ThaiQuangHuy2906/smart-privacy-locker/AnhVatLi/2.3.9.jpg

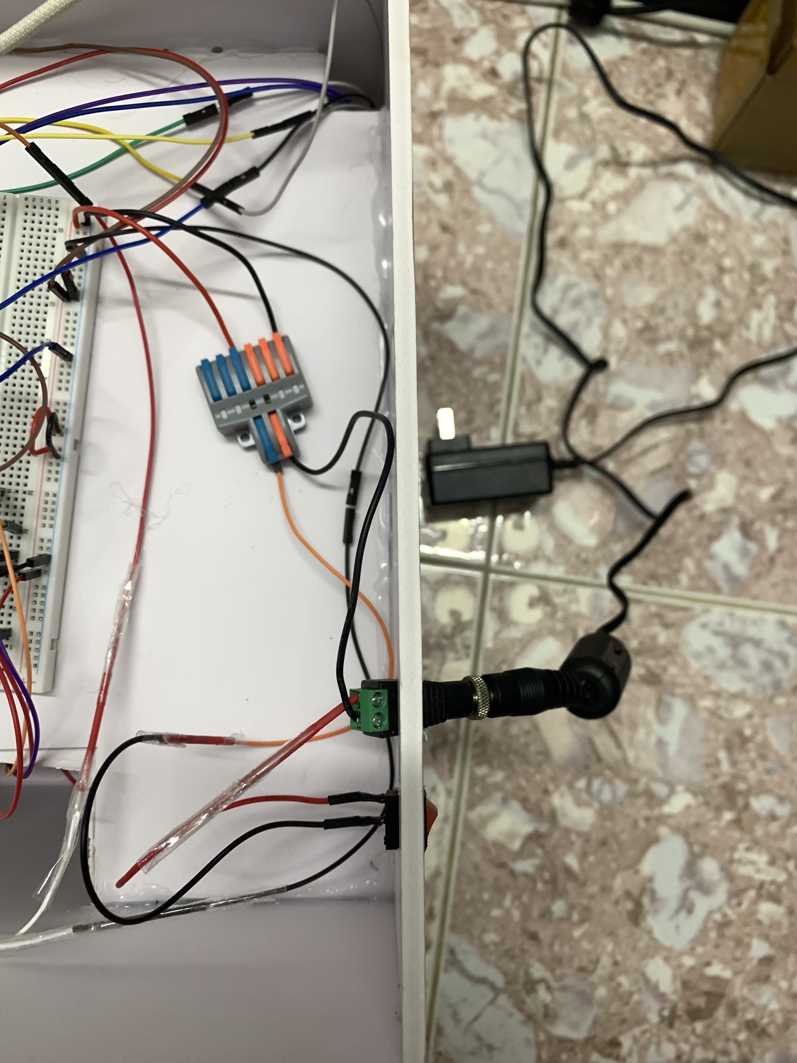
AnhVatLi/2.3.9.jpg
