ThaiQuangHuy2906/smart-privacy-locker/node-red/README.md

# Node-RED application deployment

> Audit snapshot 2026-08-18: `npm test` passes 177/177, simulator 28 assertions
> across 22 scenarios, authenticated loopback broker 18 assertions, local
> Chrome/CDP dashboard QA 18/18, and config/dependency audits report zero
> findings. External FlowFuse/Supabase/
> Telegram/Gemini/SMTP state was not redeployed or rerun in this audit.

`flows.json` separates MQTT validation/cache, auth/dispatcher/ACK/timeout,
unauthorized/Telegram, history/chatbot, Dashboard APIs, persistence/chart and
daily reports. Core logic is in
small modules under `lib/`; no giant Function node owns the trust boundary.

The dispatcher rejects unknown/late/mismatched ACKs for pending completion and
routes those schema-valid anomalies as `accepted:false` bounded diagnostics.
The runtime also validates the non-retained device heartbeat and refreshes only
the active `ONLINE` connection generation; it does not persist a periodic
`DEVICE_ONLINE` event. Dashboard corrections are documented in
[../dashboard/README.md](../dashboard/README.md). Regenerate the FlowFuse
artifact after every source change and run the deterministic artifact test.

Door events preserve a firmware UUIDv4 `event_id` and use its explicit OPEN
`authorized` boolean when present. One successful `UNLOCK` ACK while CLOSED
grants one OPEN. Current firmware auto-locks after that opening closes or when
the unused 30-second grant expires; a later forced OPEN without re-arm is
unauthorized. The automatic lock publishes state but no command ACK. The
backend window is a legacy fallback, not an
override of firmware after restart. A missed OPEN is reconciled from full state
only when the device also reports local `alarm=ACTIVE`; repeated event IDs are
idempotent across alarm/history/notification side effects.
Persistence failures enter a bounded RAM retry outbox; due retries run from the
periodic flow tick, and exhausted/full-outbox records remain visible as explicit
dead letters rather than a false healthy state.

## Install and configure

### FlowFuse Cloud (J.11)

Generate the import artifact from the tested runtime and Dashboard sources:

```
npm run build:flowfuse
```

Import `flows.flowfuse.json`, not `flows.json`. The FlowFuse export bundles the
modules under `lib/` into the initializer's **On Start** code and embeds the
Dashboard HTML/CSS/JavaScript behind `GET /locker`; `GET /phase2` remains a
legacy alias. It does not require access to this repository or a custom
`settings.js` at runtime. Do not edit the
generated JSON directly; change `lib/`, `dashboard/`, or `flows.json`, then run
the build command again.

The instance must allow Function nodes to load modules
(`functionExternalModules`). This export requests the Node.js built-ins
`crypto`/`https` plus the pinned `nodemailer` dependency. Add the
following variables to the FlowFuse instance environment, install the pinned
`@flowfuse/node-red-dashboard` palette, then enter the MQTT username and
password in the MQTT broker configuration node's credential fields:

```text
LOCKER_ID, MQTT_HOST, MQTT_PORT,
COMMAND_TIMEOUT_MS, DEVICE_STALE_AFTER_SECONDS, DASHBOARD_BASE_URL,
SUPABASE_URL, SUPABASE_ANON_KEY, SUPABASE_SERVICE_ROLE_KEY,
TELEGRAM_BOT_TOKEN, TELEGRAM_BOT_USERNAME, TELEGRAM_WEBHOOK_SECRET,
GEMINI_API_KEY, GEMINI_MODEL, REPORT_TIMEZONE,
GMAIL_SMTP_HOST, GMAIL_SMTP_PORT, GMAIL_SMTP_USER,
GMAIL_APP_PASSWORD, EMAIL_FROM
```

Do **not** copy every key from the repository-wide `.env.example` into
FlowFuse. Phase 3 Node-RED needs `SUPABASE_SERVICE_ROLE_KEY` for trusted event
and delivery writes, but the Dashboard never receives it. `MQTT_USERNAME` and
`MQTT_PASSWORD` belong in the broker configuration node's credential store,
not in the JSON export. The included TLS config verifies the broker certificate;
upload a CA only when the broker uses a private CA.

The broker permissions must match the flow's actual subscription filters. Use
separate credentials and permissions for the trusted orchestrator and device:

```text
Node-RED credential: Publish + Subscribe on locker/+/#
ESP32 credential:    Publish + Subscribe on locker/LOCKER-001/#
```

The Node-RED flow subscribes to `locker/+/+` and
`locker/+/telemetry/door`. Giving its credential only the device-scoped
`locker/LOCKER-001/#` permission can authenticate the connection while the
broker still rejects both subscriptions; a green/connected MQTT status alone
does not prove that telemetry is entering the flow. Keep the device credential
scoped to its one locker and never copy the broader Node-RED credential into
firmware.

Telegram has no shared/global destination. `TELEGRAM_BOT_TOKEN` and
`TELEGRAM_WEBHOOK_SECRET` are backend secrets; `TELEGRAM_BOT_USERNAME` is the
BotFather username without `@`. After the first deployment, register this
HTTPS webhook once with Telegram:

```text
https://<ten-instance-cua-ban>.flowfuse.cloud/api/v1/telegram/webhook
```

Use Telegram Bot API `setWebhook` with the same `TELEGRAM_WEBHOOK_SECRET` in
its `secret_token` field. The Dashboard then creates a 10-minute, one-time
deep link. The owner clicks **Liên kết Telegram**, presses **Start** in the
private bot chat, and the webhook stores the destination for that locker. The
browser never asks for, receives, or saves a Chat ID. Group/supergroup starts,
expired or cross-account token reuse, wrong owners, and webhook calls without
the exact secret header are rejected. An exact retry from the already-linked
private account is idempotent. See `docs/deployment-guide.md` for the exact
registration and verification commands.

The webhook also handles private `/start`, `/help`, and `/settings` commands
without a link token by directing the user back to the authenticated Dashboard.
Other messages and every group/supergroup command remain ignored. Configure the
same three command names and the bot descriptions through BotFather or the Bot
API after the matching runtime is deployed.

After deployment, use `/locker` for the embedded app and
`/dashboard/locker` for the FlowFuse Dashboard wrapper. Existing direct
`/phase2` links remain valid through the compatibility alias. A missing bootstrap
returns `503 RUNTIME_STARTING` from protected routes instead of exposing or
bypassing authentication.

### Self-hosted Node-RED

1. Use a FlowFuse/Node-RED runtime `>=4.1.13 <5` on Node.js 20+. The platform supplies Node-RED; this project intentionally does not vendor its palette-manager runtime. Install the pinned Dashboard node with `npm ci`.
2. Apply `settings.example.js` values to the deployment `settings.js`. Set a strong `NODE_RED_CREDENTIAL_SECRET` outside Git.
3. Set only the runtime variables listed in the FlowFuse section above in the deployment secret/environment store. Self-hosted Node-RED additionally needs `NODE_RED_CREDENTIAL_SECRET`. Never import a plaintext credential flow.
4. Import `flows.json`. Configure the MQTT broker node credential fields from the Node-RED credential store/environment; remote brokers require certificate verification.
5. Serve the static app through `httpStatic`; open the FlowFuse Dashboard page `/dashboard/locker` (or `/locker` directly for diagnostics).

Node-RED creates one shared runtime from `settings.js` before flow messages and
keeps the flow-level initializer idempotent. MQTT status is distinct from device
LWT: the exported flow recognizes the Node-RED 4.1.13 connected status key,
invalidates pending commands on disconnect, and emits one internal `GET_STATE`
per configured locker on each reconnect. Controls enable only after a fresh
ONLINE availability plus full state from the current connection generation;
restart/old ACK cannot restore a request. Invalid MQTT payload produces a safe
bounded diagnostic containing only code, topic, and observed time—never raw
payload/token.

Valid heartbeat on `locker/{locker_id}/heartbeat` is non-retained and refreshes
the liveness observation only after current-generation `ONLINE`. It cannot make
an explicitly `OFFLINE`, retained-only or pre-reconnect generation trustworthy.
Firmware follows heartbeat with a full-state refresh, so controls still depend
on validated current state rather than liveness alone.

The validated full-state `wifi_connected` boolean is retained in the live
cache and exposed to the owner Dashboard only while that state is fresh and
trusted. Missing/stale context becomes `wifi=UNKNOWN`. The Dashboard's YC12
panel provides only local captive-portal instructions; it has no path for an
SSID or Wi-Fi password.

## Tests

```powershell
npm test
npm run test:simulator
npm run test:broker
npm run audit
```

Tests use Node's built-in runner and deterministic fixtures. The memory matrix
covers retained/non-retained semantics; `test:broker` additionally executes the
exported MQTT status Function with the real Node-RED 4.1.13 status token, then
passes real MQTT traffic through `Phase2Runtime` on an authenticated loopback
Aedes broker. Neither result is an imported FlowFuse deployment or hardware evidence. Live
Supabase, FlowFuse, Telegram, Gemini, MQTT and ESP32 gates require deployment
environment and sanitized manual evidence.

Authorization is fail-closed: each Supabase Auth request is bounded to five
seconds and verify-plus-ownership shares a 9-second aggregate deadline. The
Dashboard uses a 15-second deadline for simple auth/command operations, 30
seconds for database-backed views/settings and 40 seconds for grounded chat;
all remain bounded. If the command HTTP request disconnects during
authorization, runtime dispatch and MQTT outbox draining are suppressed.

## Routes and operations

See `docs/auth-ownership.md` for route/status contracts. The timeout scheduler
runs every 250 ms against a 5000 ms default deadline. Actuator timeouts are not
retried; one internal `GET_STATE` is issued only while the device remains ready.
Completed IDs are bounded in memory. A Node-RED restart clears them, pending
commands, cache freshness, and the legacy unlock-command window by design.
Current firmware telemetry remains authoritative for the one-time OPEN decision,
so a backend restart cannot turn a device-authorized edge into an alert or vice
versa.

Phase 3 adds owner-protected `GET history`, `GET chart`, and `GET/PUT
notification-settings` routes. A minute scheduler selects email-enabled
settings after their local `HH:MM` becomes due, aggregates the previous local
calendar day, and atomically reserves `(locker, channel, report_date)`. A
definitively rejected/not-sent attempt can retry at most three times. A crash
before SMTP starts can reclaim its stale reservation; a timeout/crash after
SMTP may have accepted the message becomes `delivery_unknown` and is never
resent automatically. Every setting is isolated, so one invalid stored
timezone cannot stop reports for other lockers. Provider/config failures expose
only bounded error codes, never credentials or response bodies.

History-backed aggregation, report and chatbot queries page Supabase in stable
`occurred_at DESC,event_id DESC` order. Daily scheduler settings use the same
bounded paging rule in stable `locker_id ASC` order. Both paths fail explicitly
at their configured safety ceiling instead of returning a silent 1000-row
partial result. Enabling Telegram before that locker has a completed
private-account link is rejected. The scheduler checks that SMTP
is configured before reserving a delivery attempt, so an unset deployment does
not consume the day's retry budget. Retained availability without `sent_at`
updates live state but is not persisted because it has no replay-stable event
identity.

Apply `202608100002_phase3_scheduler_delivery_hardening.sql` and then
`202608110001_telegram_account_linking.sql` and then
`202608110002_telegram_link_consume_conflict_fix.sql` and then
`202608110003_telegram_notification_preference_upsert_fix.sql` before deploying this runtime. The
previous runtime remains compatible with the generated `report_date`; the new
runtime intentionally fails closed if the reservation or Telegram-link RPC is
absent.
