ThaiQuangHuy2906/smart-privacy-locker/PLAN.md

# Smart Privacy Locker — Implementation Plan

> Baseline lập kế hoạch: 2026-08-07, repository greenfield, chưa có source code và chưa có implementation evidence.
>
> Historical baseline status khi lập kế hoạch, không phải current registry: **Phase 1 — ACTIVE**; **Phase 2 — NOT_STARTED**; **Phase 3 — NOT_STARTED**.
>
> Quy tắc cập nhật: không tick công việc, không ghi `PASS`, không điền commit hash/remote reference và không chuyển trạng thái Phase nếu chưa có evidence thực tế tương ứng.

> **Addendum hiện hành 2026-08-18:** đây là baseline/kế hoạch lịch sử nên các
> dòng cũ về “chưa có hardware”, trạng thái phase và số test tại từng phase
> không được hiểu là current registry. Trạng thái hiện hành nằm ở
> [BAO_CAO_RA_SOAT_CODEBASE.md](BAO_CAO_RA_SOAT_CODEBASE.md),
> [docs/requirements.md](docs/requirements.md) và
> [tests/test-plan.md](tests/test-plan.md). As-built hiện dùng tay SG90 làm chốt
> quay: `LOCK=80°`, `UNLOCK=170°`, settle `2.000 ms`; người dùng đóng/mở cửa và
> MC-38 chỉ đo cửa. Các quan sát riêng lẻ OLED/DHT22/MC-38/WS2812B/SG90 là
> `PARTIAL / USER-REPORTED`; final E2E phần cứng vẫn chưa đóng. Rủi ro phép đo
> nguồn/tải P1-05 đã được người dùng chấp nhận cho demo, không phải measured
> PASS. Quy trình hiện hành ở
> [HUONG_DAN_TEST_END_TO_END.md](HUONG_DAN_TEST_END_TO_END.md), phần ôn vấn đáp ở
> [ON_TAP_VAN_DAP_CHI_TIET.md](ON_TAP_VAN_DAP_CHI_TIET.md).

## 1. Project Overview

Smart Privacy Locker là mô hình tủ bảo mật IoT mini dùng ESP32 để giám sát cửa, điều khiển khóa servo, còi báo động và đèn trong tủ. Người dùng thao tác qua FlowFuse Dashboard; Node-RED là backend bắt buộc đứng giữa Dashboard, MQTT Broker, ESP32, Supabase và các dịch vụ Telegram, Gmail, Gemini. DHT22 và OLED tạo thành luồng hiển thị cục bộ, không mặc định đưa nhiệt độ/độ ẩm lên Dashboard.

Tại baseline lập kế hoạch, repository là greenfield, Git chưa có commit và chỉ có hai tài liệu PDF nguồn. Hiện repository đã có đủ Phase 1–3 software baseline cùng build/test evidence và project ở trạng thái `SOFTWARE_COMPLETE`; current implementation/lifecycle phải lấy từ Phase registry, Phase Completion Summary và Git evidence, không từ mô tả historical baseline này.

### Nguồn sự thật và audit tài liệu

Thứ tự ưu tiên khi triển khai:

1. Bản thuyết minh dự án.
2. Yêu cầu trong prompt tạo kế hoạch này.
3. Master Project Plan.
4. Quyết định kỹ thuật được ghi rõ trong tài liệu này.

Source-document audit là phần duy nhất đã hoàn thành tại baseline:

- Đã đọc toàn bộ 22 trang của `12_24127177_24127205_24127249.pdf`, gồm phạm vi chức năng, thiết kế 3D, vị trí linh kiện, wireframe, sơ đồ truyền nhận dữ liệu, BOM, lịch và phân công gốc.
- Đã đọc toàn bộ 49 trang của `Master Project Plan.pdf`, gồm kiến trúc, MQTT/database đề xuất, firmware/Node-RED decomposition, lịch 5 tuần, acceptance criteria, test plan, risk register, demo và recovery audit.
- Đã kiểm tra trực quan các trang chứa thiết kế 3D, wireframe, sơ đồ hệ thống và ảnh linh kiện; hai PDF là born-digital, không mã hóa, không có JavaScript và không có lỗi cấu trúc do `qpdf` phát hiện.
- Hai PDF là tài liệu chỉ đọc; không được sửa, thay thế hoặc âm thầm di chuyển trong quá trình triển khai.

### Phạm vi cam kết và traceability

Có **12 requirement** phải được triển khai đầy đủ; `Owner chính` không được thay đổi dù hạ tầng dùng chung do thành viên khác xây dựng.

| Requirement | Phạm vi cam kết | Owner chính | Phase triển khai chính | Dependency tích hợp cuối |
|---|---|---|---|---|
| CB1 | MC-38 đọc `OPEN/CLOSED` → ESP32 → MQTT → Node-RED → Dashboard; hỗ trợ `UNKNOWN` | Nguyễn Văn Minh | Phase 2 | YC4 persistence ở Phase 3 |
| CB2 | Dashboard Lock/Unlock → Node-RED xác thực → MQTT → ESP32 → Servo SG90 → ACK/state | Thái Quang Huy | Phase 1, tích hợp shared backend ở Phase 2/3 | Dispatcher/Auth của Phase 2; Dashboard cuối của Phase 3 |
| CB3 | Dashboard **Bật còi/Tắt còi** (`ALARM_ON/OFF`) → Node-RED → MQTT → ESP32 → Active Buzzer → ACK/state | Mai Phương Thùy | Phase 3 | Command contract/foundation từ Phase 1/2 |
| YC1 | DHT22 → ESP32 → OLED SSD1306, chỉ cục bộ | Thái Quang Huy | Phase 1 | Hardware integration cuối Phase 3 |
| YC3 | Dashboard LED On/Off → Node-RED xác thực → MQTT → ESP32 → WS2812B → ACK/state | Thái Quang Huy | Phase 1, tích hợp shared backend ở Phase 2/3 | Dispatcher/Auth của Phase 2; Dashboard cuối của Phase 3 |
| YC4 | Node-RED lưu lịch sử cửa, khóa, buzzer, LED, cảnh báo, source, result, authorized, command_id, timestamp vào Supabase | Mai Phương Thùy | Phase 3 | Event contract do Phase 2 phát cho YC6 |
| YC5 | Biểu đồ số lần mở tủ và số cảnh báo theo 7/30 ngày | Mai Phương Thùy | Phase 3 | YC4, timezone contract |
| YC6 | Phát hiện mở trái phép; `authorized=false`; buzzer; Telegram; cảnh báo Dashboard | Nguyễn Văn Minh | Logic Phase 2; tích hợp đầy đủ Phase 3 | CB3 và YC4 do Thùy triển khai |
| YC7 | Báo cáo email hằng ngày: số lần mở, số cảnh báo, hoạt động gần nhất | Mai Phương Thùy | Phase 3 | YC4 và notification settings |
| YC8 | Chatbot dùng live state + Supabase history làm context cho Gemini; Gemini chỉ diễn đạt | Nguyễn Văn Minh | Routing/grounding Phase 2; history integration Phase 3 | YC4 history query thực ở Phase 3 |
| YC9 | Supabase Auth register/login/logout/session/JWT, ownership, RLS | Nguyễn Văn Minh | Phase 2 | Dashboard cuối Phase 3 |
| YC12 | WiFiManager captive portal đổi Wi-Fi không nạp lại firmware | Thái Quang Huy | Phase 1 | User/deployment guide Phase 3 |

### Phase registry

| Phase | Thành viên | MSSV | Owner chính | Trạng thái hiện tại |
|---|---|---|---|---|
| 1 | Thái Quang Huy | 24127177 | CB2, YC1, YC3, YC12 | **COMPLETED** |
| 2 | Nguyễn Văn Minh | 24127205 | CB1, YC6, YC8, YC9 | **COMPLETED** |
| 3 | Mai Phương Thùy | 24127249 | CB3, YC4, YC5, YC7 | **COMPLETED** |

### Phase lifecycle và ranh giới quyền hạn

Lifecycle chuẩn, chỉ chuyển theo evidence thật chứ không theo lịch:

`NOT_STARTED → ACTIVE → COMPLETED`

`BLOCKED` chỉ dùng khi có blocker thật. Khi blocker được giải quyết, Phase trở lại `ACTIVE`; thiếu hardware không phải blocker của SOFTWARE-GATE.

- `NOT_STARTED`: chưa được phép triển khai Phase.
- `ACTIVE`: Terra được phép triển khai đúng Phase này.
- `COMPLETED`: toàn bộ `MUST` software implementation của Phase đã hoàn thành; build/test phù hợp đã `PASS`; documentation/evidence software đã cập nhật; secret/diff audit sạch; code đã commit, push lên GitHub, tích hợp vào `develop` và `develop` đã push. Trạng thái này xác nhận software baseline cho dependency purposes, không xác nhận board, sensor, actuator, nguồn hoặc cơ khí đã verified. Mọi `DEFERRED — HARDWARE-FINAL-GATE` vẫn `[ ]` và chặn final release/demo.
- `BLOCKED`: có blocker software, access hoặc dependency thật khiến owner không thể tiếp tục an toàn; phải ghi chính xác blocker và điều kiện gỡ. Không dùng trạng thái này chỉ vì nhóm chưa mua hardware.

Quy tắc vận hành tuần tự:

- Khi Phase đang `ACTIVE` đạt SOFTWARE-GATE, branch Phase đã commit/push và được merge vào `develop` rồi `develop` đã push thành công, cập nhật Phase đó thành `COMPLETED` và chuyển Phase kế tiếp từ `NOT_STARTED` sang `ACTIVE`.
- Không yêu cầu review, reviewer approval, cross review hoặc Pull Request để chuyển Phase. Peer feedback hoặc Pull Request có thể dùng tùy chọn, nhưng không tạo gate và không thay đổi lifecycle.
- Mỗi thời điểm chỉ có tối đa một Phase `ACTIVE`; không triển khai Phase kế tiếp trước khi Phase hiện tại `COMPLETED`.
- Phase 1 `COMPLETED` → Phase 2 `ACTIVE`; Phase 2 `COMPLETED` → Phase 3 `ACTIVE`; Phase 3 `COMPLETED` → project `SOFTWARE_COMPLETE`.
- Sau `SOFTWARE_COMPLETE`, project đi tuần tự qua `HARDWARE_INTEGRATION → HARDWARE_VERIFICATION → FULL_E2E → FINAL_RELEASE_READY`. Đây là project-level release workflow, không phải Phase mới.
- `HARDWARE_INTEGRATION`: mua/nhận linh kiện, wiring, assembly và calibration theo pin-map/power/mechanical docs.
- `HARDWARE_VERIFICATION`: chạy toàn bộ P1 hardware tests, P2 MC-38 tests, P3 buzzer tests, WiFiManager thật, physical MQTT recovery và power/full-load tests.
- `FULL_E2E`: chạy real-device E2E/demo regression, sửa lỗi và chạy lại affected tests; simulator/mock không thay evidence vật lý.
- `FINAL_RELEASE_READY`: chỉ được đặt sau khi mọi hardware-final/`FINAL-GATE`, security/service gate và final acceptance đều có evidence thật.
- Phase 1 software baseline accepted by project maintainer.
- Hạ tầng dùng chung không làm thay đổi owner requirement. Minh xây dispatcher dùng cho CB2/CB3/YC3 nhưng không sở hữu CB3; Thùy nối buzzer/persistence vào YC6 nhưng Minh vẫn là owner YC6.

### SOFTWARE-FIRST / DEFERRED-HARDWARE workflow

Khi nhóm chưa có ESP32 hoặc module, tiến độ software vẫn tiếp tục theo frozen contracts, nhưng không một simulator/mock/broker capture nào được trình bày như hardware evidence.

- **SOFTWARE-GATE:** clean build, automated/unit/contract tests, documentation, source/diff/secret self-audit, và broker/simulator integration có thể chạy không cần board. Simulator chỉ xác nhận producer/consumer tuân thủ MQTT contract; nó không xác nhận firmware hay điện tử trên ESP32 thật.
- **HARDWARE-FINAL-GATE:** board ESP32 thật; sensor/actuator thật; pin/wiring; nguồn, brownout và full-load; cơ cấu chốt; OLED/DHT/LED/buzzer/MC-38; WiFiManager captive portal trên thiết bị thật; physical MQTT recovery; và physical end-to-end demo. Các mục này bắt buộc trước **FINAL RELEASE/DEMO**.
- Test hardware chưa thể chạy phải giữ checkbox `[ ]` và nhãn `DEFERRED — HARDWARE-FINAL-GATE`, kèm blocker “hardware chưa được mua/chưa có”. Nhãn này không phải `PASS`, không phải `VERIFIED`, và không được xóa test hoặc evidence requirement.
- Một test service/account không cần board vẫn là SOFTWARE-GATE hoặc MANUAL service gate theo table riêng của nó; chỉ phần thật sự cần hardware mới được defer thành hardware final gate.
- Sau khi Phase đạt SOFTWARE-GATE, branch Phase và `develop` đã push với integration evidence thật, Phase đó là `COMPLETED` cho dependency purposes và Phase kế tiếp có thể thành `ACTIVE`. Hardware final gates vẫn được chạy trên release candidate trước demo/release.

### Simple sequential Git workflow

Integration branch và Phase branches cố định:

```text
develop
phase/1-huy-firmware-foundation
phase/2-minh-security-orchestration
phase/3-thuy-data-integration
```

Không bắt buộc Pull Request hoặc reviewer approval. Không rebase/rewrite shared history và không force push. Nhóm làm tuần tự nên ưu tiên fast-forward merge khi có thể.

Mỗi thành viên thực hiện đúng thứ tự:

1. Pull `develop` mới nhất bằng fast-forward-only.
2. Tạo hoặc switch đúng Phase branch từ `develop`.
3. Implement duy nhất scope Phase đang `ACTIVE`.
4. Chạy build/test thuộc SOFTWARE-GATE.
5. Cập nhật `PLAN.md` và evidence thật.
6. Commit thay đổi thuộc Phase.
7. Push Phase branch lên GitHub.
8. Khi SOFTWARE-GATE `PASS`, merge Phase branch vào `develop`, ưu tiên fast-forward.
9. Push `develop` lên GitHub.
10. Đánh dấu Phase hiện tại `COMPLETED`, chuyển Phase kế tiếp `ACTIVE`, commit/push lifecycle update trên `develop`, tạo/push branch kế tiếp từ HEAD đó và dừng; với Phase 3, đặt project `SOFTWARE_COMPLETE` và không tạo Phase mới.

Phase 1 là bootstrap exception: project maintainer đã chấp nhận software baseline, vì vậy `develop` được tạo đúng tại accepted Phase-1 HEAD. Branch `phase/2-minh-security-orchestration` phải xuất phát từ HEAD đó của `develop`; việc tạo branch không triển khai functionality Phase 2.

### Priority model, manual gates và Simple Implementation Rule

Thứ tự ưu tiên của dự án:

`CORRECT → COMPLETE → TESTABLE → DEMOABLE → SECURE ENOUGH → MAINTAINABLE → HARDENING`

- `MUST`: bắt buộc để đúng thuyết minh/frozen contract, an toàn, chạy demo hoặc đạt acceptance. Mọi `MUST` software implementation và SOFTWARE-GATE verification của Phase phải hoàn tất trước `COMPLETED`; hardware `MUST` được đánh dấu `DEFERRED — HARDWARE-FINAL-GATE` có thể còn pending khi chưa có phần cứng và phải hoàn tất trước final release/demo.
- `SHOULD`: engineering quality có ích nếu không làm chậm committed scope. Có thể defer và phải ghi trong Phase Completion Summary.
- `OPTIONAL`: production hardening/enhancement. Không được block Phase, acceptance hoặc final project acceptance; chỉ làm sau khi mọi `MUST` đã hoàn thành và còn thời gian.
- `MANUAL — HARD-GATE`: manual correctness/safety/dependency test **không cần hardware** hoặc có environment thật sẵn sàng; evidence bắt buộc trước Phase có thể rời `ACTIVE`.
- `DEFERRED — HARDWARE-FINAL-GATE`: manual physical test chưa thể chạy do thiếu hardware. Nó không chặn software handoff hoặc Phase 1 → Phase 2 → Phase 3, nhưng bắt buộc pass trước `FINAL_RELEASE_READY`/demo.
- `MANUAL — FINAL-GATE`: manual service/account/end-to-end test không nhất thiết là hardware; có thể còn pending khi dependency/credential thật chưa sẵn sàng, nhưng phải được liệt kê trung thực và pass trước `FINAL_RELEASE_READY`. Không dùng nhãn nào để né test có thể và cần chạy ngay.

> **Simple Implementation Rule:** Khi có nhiều cách đúng, chọn implementation đơn giản nhất đáp ứng committed requirements và frozen contracts. Không xây abstraction, framework, service, table, queue, retry system hoặc security mechanism phức tạp hơn mức project thực sự cần.

Áp dụng KISS/YAGNI và separation of concerns vừa đủ: không giant Node-RED Function node, không god class, không premature optimization. Tuy nhiên không được “đơn giản hóa” bằng cách bỏ authentication, authorization, RLS, ACK, timeout, duplicate protection cơ bản, validation, basic failure handling hoặc secret protection.

Hardening guidance để Terra không biến ý tưởng tốt thành blocker:

| Cơ chế | Priority | MUST path đơn giản |
|---|---|---|
| MQTT authentication | `MUST` | Broker có username/password; credential không ở Dashboard/Git |
| TLS qua Internet | `MUST` khi broker remote | Xác minh certificate; local isolated development không bắt buộc TLS |
| TLS cho local development | `OPTIONAL` | Chỉ làm nếu môi trường đã hỗ trợ và không làm chậm scope |
| MQTT topic ACL nâng cao | `OPTIONAL` | Authentication + Node-RED authorization là đường bắt buộc; ACL là defense-in-depth |
| Schema migrations | `MUST` ở mức script có thứ tự, chạy lặp/rebuild dev được | Migration framework phức tạp, rollback automation và query-plan tuning là `SHOULD/OPTIONAL` |
| `boot_id`/sequence telemetry | `SHOULD` | Core state + timestamp + stale handling phải chạy; boot UUID không block |
| Duplicate cache | `MUST` ở mức bounded recent-ID cache đơn giản | LRU tinh vi, persistence qua reboot và distributed cache là `OPTIONAL` |
| Persistence failure | `MUST` ghi lỗi rõ, không crash/loop vô hạn | Bounded retry nhỏ là `SHOULD`; dead-letter queue/infrastructure là `OPTIONAL` |
| Locker provisioning | `MUST` ownership server-side + không claim lại | Provisioning service, concurrent stress/race framework là `OPTIONAL`; dùng constraint/conditional update đơn giản |
| Secret checking | `MUST` kiểm tra working tree/diff và không commit secret | Exhaustive history scanning/automation là `SHOULD/OPTIONAL`, trừ khi có incident thật |
| Dependency/license work | `MUST` pin dependency cần dùng | License/dependency automation, bot update và CI policy nâng cao là `OPTIONAL` |
| Gemini grounding | `MUST` Node-RED tính facts, context có cấu trúc, no-data/failure rõ | Numeric-token validator/phân tích output tinh vi là `OPTIONAL` |
| CI/CD, observability, scalability | `OPTIONAL` | Local documented build/test/deploy và log lỗi cơ bản là đủ cho committed scope |

### Mâu thuẫn, diễn giải và quyết định ưu tiên

1. **Lịch dự án:** Master Project Plan giả định dự án bắt đầu 20/07/2026 và đang giữa Tuần 3, nhưng repository không có commit/source và prompt xác nhận greenfield. Quyết định: dùng ba Phase tuần tự và evidence gates của kế hoạch này; lịch 5 tuần chỉ là bối cảnh lịch sử, không phải bằng chứng hoàn thành.
2. **Phân công:** Master Project Plan mô tả một số việc là trách nhiệm chung. Bản thuyết minh và prompt khóa owner theo CB/YC. Quyết định: có thể trao đổi kỹ thuật và tích hợp chéo, nhưng không chuyển owner chính; trao đổi này không phải lifecycle gate.
3. **Command payload:** hai PDF nêu tối thiểu `command_id`, `locker_id`, `action`, `issued_at`; prompt yêu cầu thêm `requested_by`. Quyết định: shared contract bắt buộc đủ cả năm trường.
4. **YC6 dependency:** Master mô tả YC6 như một luồng hoàn chỉnh trong cùng lịch tuần. Prompt tách rõ logic YC6 ở Phase 2, actual buzzer và event persistence ở Phase 3. Quyết định: Phase 2 phát `ALARM_ON` và normalized event `UNAUTHORIZED_OPEN` qua interface đã khóa; Phase 3 hiện thực CB3/YC4 và nối thật.
5. **YC8 dependency:** Minh sở hữu YC8 nhưng history thực phụ thuộc YC4 của Thùy. Quyết định: Phase 2 hoàn thành classifier, state-cache route, history adapter contract, structured grounding và failure path; Phase 3 nối adapter vào schema/query thật và chạy integration test.
6. **Quên mật khẩu:** wireframe thuyết minh có liên kết “Quên mật khẩu”, nhưng danh sách phạm vi YC9 chỉ cam kết register/login/logout/session/JWT/ownership/RLS. Quyết định: password recovery là **OPTIONAL**, không được làm chậm acceptance của YC9 trừ khi nhóm/giảng viên xác nhận bổ sung.
7. **Dashboard directory:** Dashboard chạy bằng FlowFuse Dashboard trong Node-RED. Thư mục `dashboard/` chỉ lưu wireframe, asset và tài liệu UI; source-of-truth flow runtime nằm trong `node-red/`.

### Open questions phải được đóng bằng evidence, không được suy đoán âm thầm

| Câu hỏi | Default đề xuất để triển khai | Người/Phase phải xác nhận | Ảnh hưởng nếu chưa đóng |
|---|---|---|---|
| ESP32 DevKit V1 Type-C thực tế dùng pin label/board profile nào? | Dùng candidate pin map ở Section 4, kiểm tra trực tiếp board trước khi nối tải | Huy / Phase 1 | Chặn wiring và firmware hardware |
| Góc `LOCK`/`UNLOCK` và hình học chốt? | Cấu hình, không hard-code rải rác; hiệu chuẩn không tải rồi có tải | Huy / Phase 1 | Chặn acceptance CB2 |
| Buzzer module active-high/active-low, dòng tải và có cần MOSFET? | Specimen LOW-trigger: local active-low, VCC 3V3, GPIO26 qua 4,7 kΩ; inactive HIGH bench PASS, active/current/full-load còn pending | Thùy / Phase 3; dùng power notes của Huy từ Phase 1 | Chặn phần còn lại của CB3 và tích hợp YC6 |
| WS2812B có bao nhiêu pixel và dòng cực đại? | Đo strip thật; giới hạn brightness để 5 V/3 A vẫn có margin | Huy / Phase 1 | Chặn full-load acceptance |
| MQTT Broker/FlowFuse deployment, TLS và credential được cấp ở đâu? | Broker có authentication; TLS bắt buộc nếu đi qua Internet | Nhóm, Huy khóa config / Phase 1 | Chặn MQTT integration thật |
| Locker được pre-provision/claim bằng mã như thế nào? | `LOCKER-001` được tạo server-side ở trạng thái chưa claim; claim một lần qua backend/RPC đã xác thực bằng một thao tác có điều kiện/constraint đơn giản. Chỉ cần cơ chế phức tạp hơn nếu test thật chứng minh có race cần xử lý | Minh / Phase 2 | Chặn ownership end-to-end |
| Telegram được liên kết với locker/user thế nào? | Owner tạo deep link 10 phút; private `/start` + webhook secret tiêu thụ token một lần; Chat/User ID chỉ ở backend settings | Minh / Phase 2, Thùy tích hợp Phase 3 | Chặn Telegram test thật |
| Giờ báo cáo/email auth dùng cấu hình nào? | `21:00`, `Asia/Ho_Chi_Minh`; Gmail App Password hoặc OAuth chỉ ở backend | Thùy / Phase 3 | Chặn YC7 MANUAL test |
| Gemini model/quota nào được phép dùng? | Tên model là environment variable, không hard-code; kiểm tra model khả dụng khi triển khai | Minh / Phase 2 | Chặn Gemini API MANUAL test |
| Git remote và integration branch đã tồn tại chưa? | Dùng `develop` làm integration branch sau khi bootstrap; không giả lập remote state | Huy / Phase 1 | Chặn push/integration, không chặn local implementation |

## 2. Proposed Technology Stack

Đây là stack **đề xuất** vì hai PDF không khóa phiên bản thư viện/tool cụ thể. Không ghi “latest” trong manifest. Phase 1 phải pin các phiên bản tương thích đã build/test và ghi chúng trong `platformio.ini`, Node-RED package metadata và deployment guide.

| Lớp | Công nghệ đề xuất | Lý do/ranh giới |
|---|---|---|
| Firmware toolchain | PlatformIO + ESP32 Arduino Framework + C++ | Phù hợp ESP32 DevKit, dependency pinning và build lặp lại được |
| MQTT firmware | PubSubClient | Nhẹ, phổ biến; phải kiểm tra giới hạn QoS publish và dựa vào ACK timeout/state reconciliation thay vì tự retry actuator |
| JSON firmware | ArduinoJson | Parse/validate payload có schema rõ, tránh thao tác chuỗi rời rạc |
| Wi-Fi provisioning | WiFiManager | Captive portal cục bộ cho YC12; Wi-Fi password chỉ lưu trên ESP32/NVS |
| Servo | ESP32Servo | PWM tương thích ESP32; góc và thời gian chuyển động cấu hình được |
| DHT22 | Adafruit DHT sensor library + Adafruit Unified Sensor nếu dependency yêu cầu | Chu kỳ đọc có kiểm soát, phát hiện `NaN` |
| OLED | Adafruit SSD1306 + Adafruit GFX | SSD1306 0.96 inch I2C, hỗ trợ thông báo lỗi cục bộ |
| WS2812B | Adafruit NeoPixel (ưu tiên một thư viện duy nhất) | API đơn giản cho ON/OFF; FastLED chỉ là phương án thay thế nếu có lý do được ghi lại |
| Backend/orchestration | Node-RED | Auth/ownership gate, MQTT dispatcher, pending/ACK, cache, persistence, notifications, chatbot routing |
| UI | FlowFuse Dashboard | Dashboard web/mobile trong hệ Node-RED; không publish MQTT trực tiếp |
| MQTT Broker | Eclipse Mosquitto cho local/dev hoặc broker managed tương đương | Authentication bắt buộc; TLS khi qua Internet; topic ACL nếu broker hỗ trợ |
| Auth/database | Supabase Auth + PostgreSQL + PostgREST/RPC + Row Level Security | Session/JWT, ownership, event history, aggregation và RLS |
| Telegram | Telegram Bot API qua Node-RED HTTP request | Cảnh báo tức thời YC6, rate-limit/dedupe ở Node-RED |
| Email | Gmail SMTP/Email node | Báo cáo hằng ngày YC7; credential chỉ ở backend |
| Chatbot | Gemini API qua HTTPS | Chỉ diễn đạt structured facts do Node-RED cung cấp; không là nguồn dữ liệu |
| Test | PlatformIO test/native parser tests, Node-RED flow tests, Supabase/RLS integration tests, MANUAL hardware/service tests | Tách semantic automated tests khỏi phần cần board/account thật |
| Documentation | Markdown + ảnh/video/log evidence | Traceability requirement → module → test → evidence |

Quy tắc dependency:

- Chỉ dùng một thư viện cho cùng một trách nhiệm; không đồng thời dùng Adafruit NeoPixel và FastLED.
- Không nâng dependency giữa Phase nếu không có lỗi/nhu cầu cụ thể và regression evidence.
- Production dependency mới **MUST** có lý do cụ thể, phiên bản pin và manifest/lockfile được cập nhật bằng tool chính thức. License/risk assessment cơ bản là **SHOULD**; license/dependency automation nâng cao là **OPTIONAL**.
- FlowFuse/Supabase/Gemini/Telegram/Gmail là dịch vụ biến động; Phase tương ứng phải xác minh API/node đang khả dụng bằng tài liệu chính thức tại thời điểm triển khai, không dựa vào tên endpoint nhớ từ trước.

## 3. Target Repository Structure

Cây dưới đây là **mục tiêu cho quá trình triển khai**, không phải cấu trúc đã được tạo ở baseline:

```text
smart-privacy-locker/
├── PLAN.md
├── README.md
├── .gitignore
├── .env.example
├── firmware/
├── node-red/
├── supabase/
├── dashboard/
├── hardware/
├── tests/
├── tools/
└── docs/
```

| Đường dẫn | Mục đích |
|---|---|
| `PLAN.md` | Trạng thái Phase, checklist, acceptance, evidence index và Git handoff; là tài liệu điều phối chính |
| `README.md` | Tổng quan, quick start không chứa secret, trạng thái triển khai thật và liên kết tài liệu |
| `.gitignore` | Loại `.env`, secret header, Node-RED credential runtime, PlatformIO build, log, cache, evidence nhạy cảm |
| `.env.example` | Chỉ tên biến và placeholder vô hại; không chứa credential hoạt động |
| `firmware/` | PlatformIO project, module ESP32, config example, unit/contract tests và firmware README |
| `node-red/` | Export flow/subflow, package metadata, environment example, test helper/fixtures không nhạy cảm và deployment README |
| `supabase/` | Migration/schema/RLS/RPC/test được tạo ở Phase 2/3; không đặt service-role key hoặc dump dữ liệu thật |
| `dashboard/` | Wireframe, asset và UI behavior/spec; FlowFuse flow runtime vẫn ở `node-red/` |
| `hardware/` | Pin map, wiring diagram, power budget, BOM, enclosure/assembly guide và ảnh evidence |
| `tests/` | Test plan, traceability matrix, fixtures, test results/evidence index; file lớn/nhạy cảm theo chính sách nhóm |
| `tools/device-simulator/` | Test-support harness dùng broker để giả lập device theo frozen MQTT contract; không phải production firmware, không phải hardware evidence |
| `docs/` | Requirements, architecture, MQTT/event contract, auth model, database design, user/deployment/troubleshooting/demo guide |

Không tạo cấu trúc “cho đủ”. Mỗi Phase chỉ tạo đường dẫn có deliverable thực, và không commit build output, cache, local credentials, Node-RED encrypted credentials gắn với máy cá nhân hoặc dữ liệu người dùng thật.

## 4. Architecture and Shared Contracts

### Sơ đồ hệ thống và trust boundaries

```text
Người dùng
   │ HTTPS / authenticated Dashboard messages
   ▼
FlowFuse Dashboard
   │  Supabase access token theo frozen Auth Transport Contract; không có MQTT credential
   ▼
Node-RED Backend
   ├── validate session/JWT + ownership + device/broker readiness
   ├── pending command / ACK / timeout / live-state cache
   ├── Supabase Auth, Database, RLS
   ├── Telegram Bot API
   ├── Gmail SMTP/Email node
   └── Gemini API (structured context only)
   │ authenticated MQTT
   ▼
MQTT Broker
   │ command / ACK / state / telemetry / availability
   ▼
ESP32
   ├── MC-38
   ├── Servo SG90
   ├── Active Buzzer
   ├── WS2812B
   └── DHT22 ──local only──► OLED SSD1306
```

Dashboard không được biết MQTT username/password và không được publish thẳng xuống ESP32. Node-RED là policy enforcement point; Supabase RLS là lớp bảo vệ dữ liệu độc lập, không thay thế ownership check trước command.

### Contract freeze và thay đổi contract

- Huy tạo bản `docs/mqtt-contract.md` đầu tiên trong Phase 1 và chốt với Minh trước khi các firmware module phụ thuộc được merge.
- Đầu Phase 2, Minh khóa thêm normalized event, **Supabase Auth Transport Contract** và history-adapter contract với Thùy trước khi triển khai protected command/history/chatbot/settings flows hoặc YC6/YC8/YC4 integration.
- Mỗi contract có `schema_version` số nguyên, ví dụ `1`. Thay đổi additive tương thích giữ version; thay đổi breaking phải tăng version, cập nhật producer, consumer, fixtures, tests và migration note trong cùng versioned change set.
- Không đổi topic, enum, field type, timeout semantics hoặc event counting rule một phía.

### MQTT topics

Base topic đề xuất: `locker/{locker_id}`. `locker_id` trong topic và payload phải khớp tuyệt đối.

| Topic | Publisher | Subscriber | Retained | Mục đích |
|---|---|---|---|---|
| `locker/{locker_id}/command` | Node-RED | ESP32 | Không | `LOCK`, `UNLOCK`, `ALARM_ON`, `ALARM_OFF`, `LED_ON`, `LED_OFF`, `GET_STATE` |
| `locker/{locker_id}/ack` | ESP32 | Node-RED | Không | ACK cho từng command, kể cả lỗi có thể định danh |
| `locker/{locker_id}/state` | ESP32 | Node-RED | Có | Full current state để bootstrap/reconcile sau reconnect |
| `locker/{locker_id}/telemetry/door` | ESP32 | Node-RED | Không | Stable door transition sau debounce; không replay event cũ |
| `locker/{locker_id}/availability` | ESP32/LWT | Node-RED | Có | `ONLINE` lúc connect, LWT `OFFLINE` khi disconnect bất thường |

Quy tắc MQTT:

- Command topic không retained để ESP32 không thực thi lệnh cũ sau reboot.
- Node-RED publish command với QoS được broker/client hỗ trợ cao nhất theo cấu hình đã test; firmware phải chịu được delivery trùng.
- Nếu dùng PubSubClient, phải ghi rõ QoS publish thực tế. Không tuyên bố QoS 1 cho ACK/state nếu library chỉ publish QoS 0.
- Availability LWT đặt retained; Node-RED dùng thời điểm nhận broker làm `observed_at` cho offline, vì timestamp đóng gói trong LWT được tạo từ lúc connect.
- ESP32 dùng client ID duy nhất theo locker/device. Reconnect **MUST** có khoảng chờ tăng dần và giới hạn hợp lý để không busy-loop/reset vô hạn; exponential backoff chính xác hoặc jitter là **SHOULD**, không được làm chậm committed scope nếu một state machine retry đơn giản đã đáp ứng.
- Sau mỗi MQTT reconnect thành công: publish retained `ONLINE`, drain door-transition outbox theo FIFO, publish retained full state, rồi mới chạy callback nhận command bình thường.
- MQTT session cho device ưu tiên clean session và command không queued qua downtime; sau recovery Node-RED dùng `GET_STATE`, không replay actuator command.

### Device simulator strategy

`tools/device-simulator/` là **test-support component**, không phải production component và không thay firmware ESP32. Phase 2 sẽ tạo source/harness này khi bắt đầu software implementation; phiên cập nhật PLAN này không tạo skeleton/source simulator.

Simulator phải dùng nguyên MQTT topics, payloads, schema version, retained semantics, ACK semantics và QoS đã ghi trong plan; field additive chỉ được thêm khi contract hiện hành tài liệu hóa (hiện có `event_id` và `authorized` ở door telemetry), không tự thêm field riêng để tiện cho test. Nó phải có fixture/script có kiểm soát cho:

- availability `ONLINE`/`OFFLINE`;
- retained full state;
- `GET_STATE`;
- `LOCK`/`UNLOCK`, `LED_ON`/`LED_OFF`, `ALARM_ON`/`ALARM_OFF`;
- ACK success/error, cached duplicate ACK, delayed ACK, timeout/no ACK, và malformed payload;
- door telemetry `OPEN`/`CLOSED` cho CB1 Phase 2;
- reconnect scenarios, gồm availability/full-state recovery.

Simulator/broker output chỉ là SOFTWARE-GATE evidence cho contract, Node-RED, Dashboard/state-cache và recovery handling. Nó không xác minh GPIO, Wi-Fi provisioning trên ESP32, PubSubClient transport thực, sensor, servo, LED, buzzer, nguồn, cơ khí hoặc full-load; các mục đó vẫn là HARDWARE-FINAL-GATE.

### Command payload

```json
{
  "schema_version": 1,
  "command_id": "550e8400-e29b-41d4-a716-446655440000",
  "locker_id": "LOCKER-001",
  "action": "UNLOCK",
  "issued_at": "2026-08-07T08:00:00.000Z",
  "requested_by": "user-uuid"
}
```

Validation bắt buộc:

- Đủ năm field tối thiểu; đúng type; `command_id` là UUID hợp lệ. `requested_by` là user UUID do Node-RED lấy từ session cho lệnh Dashboard, hoặc service principal ổn định như `system:unauthorized-detector` cho automation YC6; UI không được tự khai giá trị này.
- `locker_id` khớp topic và compile/runtime configuration của thiết bị.
- `action` thuộc allowlist: `LOCK`, `UNLOCK`, `ALARM_ON`, `ALARM_OFF`, `LED_ON`, `LED_OFF`, `GET_STATE`.
- `issued_at` là ISO 8601 UTC. Nếu thiết bị đã sync thời gian, từ chối command quá cũ hơn `COMMAND_MAX_AGE_SECONDS`; nếu chưa sync, dựa vào non-retained topic/clean session và Node-RED timeout, đồng thời ghi diagnostic.
- ESP32 không tự đánh giá quyền user; nó chỉ thực thi command đến từ topic/broker credential được bảo vệ. Quyền được kiểm tra ở Node-RED trước publish.

### ACK payload

```json
{
  "schema_version": 1,
  "command_id": "550e8400-e29b-41d4-a716-446655440000",
  "locker_id": "LOCKER-001",
  "action": "UNLOCK",
  "result": "success",
  "device_state": {
    "door": "CLOSED",
    "lock": "UNLOCKED",
    "alarm": "INACTIVE",
    "led": "OFF"
  },
  "error": null,
  "duplicate": false,
  "timestamp": "2026-08-07T08:00:01.000Z"
}
```

Ví dụ correlated error ACK khi command parse được `command_id` nhưng lỗi ở validation khác:

```json
{
  "schema_version": 1,
  "command_id": "550e8400-e29b-41d4-a716-446655440000",
  "locker_id": "LOCKER-001",
  "action": "UNLOCK",
  "result": "error",
  "device_state": {
    "door": "CLOSED",
    "lock": "LOCKED",
    "alarm": "INACTIVE",
    "led": "OFF"
  },
  "error": {
    "code": "STALE_COMMAND",
    "message": "Command is outside the accepted age window"
  },
  "duplicate": false,
  "timestamp": "2026-08-07T08:00:01.000Z"
}
```

- `result`: `success` hoặc `error`.
- `device_state` luôn là object full state với enum hợp lệ; trạng thái chưa xác định dùng `UNKNOWN`, không dùng chuỗi rỗng.
- `error` là `null` khi thành công; khi lỗi là object có `code` ổn định và `message` an toàn, ví dụ `MISSING_FIELD`, `INVALID_ACTION`, `LOCKER_MISMATCH`, `STALE_COMMAND`, `ACTUATION_FAILED`. `INVALID_JSON` chỉ được dùng trong ACK khi payload vẫn parse đủ để lấy một `command_id` hợp lệ; nếu không thì chỉ là diagnostic nội bộ/không tương quan.
- **Normal ACK luôn là response tương quan với command có `command_id` hợp lệ.** Nếu JSON malformed đến mức không lấy được `command_id`, firmware không publish normal correlated ACK và tuyệt đối không bịa `command_id:null`. Firmware **MAY** ghi serial diagnostic hoặc publish một uncorrelated diagnostic đơn giản nếu thật sự hữu ích; Node-RED không match diagnostic đó với pending command, không cập nhật success và để request liên quan timeout/reconcile theo contract.
- Nếu lấy được `command_id` hợp lệ nhưng command lỗi ở field/action/locker/time khác, firmware publish ACK `result:error` giữ nguyên `command_id` để Node-RED correlate.
- Command trùng không tác động actuator lần hai. Firmware phát lại cached ACK, giữ `result/device_state/error` gốc và đặt `duplicate: true`.
- Node-RED chỉ accept ACK khi `command_id`, `locker_id`, expected action/state và schema hợp lệ, đồng thời command còn trong pending store. ACK sai hoặc đến muộn được ghi diagnostic, không đổi UI thành success.

### Full state payload

```json
{
  "schema_version": 1,
  "locker_id": "LOCKER-001",
  "door": "CLOSED",
  "lock": "LOCKED",
  "alarm": "INACTIVE",
  "led": "OFF",
  "wifi_connected": true,
  "mqtt_connected": true,
  "timestamp": "2026-08-07T08:00:01.000Z"
}
```

Enum chuẩn:

- Door: `OPEN`, `CLOSED`, `UNKNOWN`.
- Lock: `LOCKED`, `UNLOCKED`, `UNKNOWN`.
- Alarm: `ACTIVE`, `INACTIVE`, `UNKNOWN`.
- LED: `ON`, `OFF`, `UNKNOWN`.
- Availability: `ONLINE`, `OFFLINE`.

### Cold boot và Servo safe-state policy

- Sau cold boot: `lock=UNKNOWN`, `alarm=INACTIVE`, `led=OFF`; door giữ `UNKNOWN` cho đến khi MC-38 có stable debounce sample rồi mới chuyển `OPEN`/`CLOSED`.
- Servo SG90 **không tự di chuyển chỉ vì ESP32 boot/reboot**. Không phát xung “safe initialization”, không replay last command và không khôi phục mù vị trí từ NVS.
- SG90 không có position feedback, vì vậy firmware không được giả vị trí cơ khí sau restart. `lock` chỉ chuyển sang `LOCKED` hoặc `UNLOCKED` sau khi controller thực sự thực hiện command `LOCK`/`UNLOCK` hợp lệ và tạo ACK/full state tương ứng; trước đó vẫn là `UNKNOWN`.
- Dashboard phải trình bày lock `UNKNOWN` là **chưa xác nhận**, không ánh xạ hoặc tô trạng thái như `LOCKED`/`UNLOCKED` và không dùng last-known state như current truth.
- YC6 tiếp tục xử lý lock `UNKNOWN` theo fail-safe hiện có: door `OPEN` khi lock chưa xác nhận không được coi là authorized.

Full-state JSON phía trên là ví dụ runtime sau một command đã được xác nhận, không phải cold-boot payload mặc định.

State được publish sau boot/reconnect, sau state transition và sau command. Retained state là last-known state, không tự chứng minh device online; availability và stale timer mới quyết định độ tươi. `boot_id`/sequence có thể được thêm nhất quán như **SHOULD**, nhưng không phải điều kiện bắt buộc của contract v1 hoặc acceptance.

### Door telemetry

```json
{
  "schema_version": 1,
  "locker_id": "LOCKER-001",
  "previous_state": "CLOSED",
  "state": "OPEN",
  "timestamp": "2026-08-07T08:01:00.000Z",
  "time_synced": true
}
```

- Chỉ publish sau stable debounce và khi state thay đổi; boot publish initial state qua full state, telemetry transition chỉ phát khi có edge thật.
- `boot_id` và `sequence` là field **SHOULD** nếu nhóm triển khai được đơn giản và nhất quán để hỗ trợ chẩn đoán duplicate/reorder; core path không phụ thuộc vào chúng.
- Nếu chưa sync NTP, giữ field `timestamp` nhưng dùng `null`, đặt `time_synced:false`; Node-RED đóng dấu `received_at` UTC và không bịa device time.
- Với MC-38 hai dây và một digital input pull-up/pull-down thông thường, firmware chỉ ánh xạ **stable electrical state** sang `OPEN` hoặc `CLOSED`; nó không thể chắc chắn phân biệt cửa đang mở hợp lệ với dây sensor bị đứt/hở. Vì vậy không được yêu cầu hoặc tuyên bố `wire disconnected → UNKNOWN`.
- Door `UNKNOWN` chỉ dùng khi live state không đáng tin: sensor chưa initialize, boot chưa có stable sample, device Offline, state cache stale, payload thiếu/không hợp lệ, hoặc lỗi đọc nội bộ mà phần cứng/library thực sự phát hiện. Dashboard/cache có thể suy ra `UNKNOWN` do Offline/stale mà không sửa retained payload gốc. **Broken-wire detection requires additional supervised circuitry and is outside current project scope.**

### Availability/Last Will and Testament (LWT) payload

Availability dùng MQTT **Last Will and Testament (LWT)**. Payload tối thiểu là JSON retained có `schema_version`, `locker_id`, `status` và `sent_at`; `boot_id` là **SHOULD**, không bắt buộc. ESP32 publish `ONLINE` sau MQTT connect. LWT chứa `OFFLINE`; `sent_at` trong LWT chỉ là lúc LWT được đăng ký, vì vậy Node-RED phải thêm `observed_at` khi broker phát LWT và dùng `observed_at` để lưu event/display. Graceful disconnect nên publish `OFFLINE` trước khi ngắt nếu có thể.

### Pending command, timeout và duplicate protection

- Node-RED sinh UUID v4 server-side; Dashboard không tự đặt `command_id`.
- Dispatcher có hai caller class rõ ràng: `authenticated_user` cho Dashboard và `trusted_internal_automation` cho detector YC6. Chỉ entrypoint nội bộ không public mới được dùng automation; action allowlist ban đầu chỉ cho `ALARM_ON`/`GET_STATE`, gắn `requested_by=system:unauthorized-detector`, vẫn phải kiểm tra locker, MQTT/device readiness, conflict và audit. Không tạo HTTP/UI “bypass auth”.
- Pending store key là `command_id`, có `locker_id`, user ID, action, actuator domain, issued time, deadline và request correlation của Dashboard.
- Actuator domain: lock (`LOCK/UNLOCK`), alarm (`ALARM_ON/OFF`), LED (`LED_ON/OFF`). Không cho hai command xung đột cùng locker/domain đồng thời; các control tương ứng bị disable.
- Timeout mặc định đề xuất `5.000 ms`, cấu hình bằng environment. Khi timeout: không báo success, ghi `COMMAND_TIMEOUT`, giải phóng pending, hiển thị lỗi và gửi một `GET_STATE` để reconcile nếu connection còn tốt.
- Không tự động retry `LOCK`, `UNLOCK`, alarm hoặc LED sau timeout; actuator có thể đã tác động nhưng ACK bị mất. Chỉ reconcile state hoặc yêu cầu người dùng thao tác lại sau khi biết state.
- Node-RED và firmware **MUST** giữ một bounded recent-command cache đơn giản đủ cho demo để nhận command/ACK trùng và tái phát ACK gốc khi phù hợp. Array/ring buffer kích thước cấu hình nhỏ là đủ; LRU phức tạp, persistence qua reboot hoặc distributed cache là **OPTIONAL** và không block Phase.
- ACK đến sau timeout không đổi request cũ thành success; state hợp lệ vẫn có thể cập nhật cache như telemetry riêng và UI phải ghi rõ reconciliation, không giả thành công cho command đã timeout.

### Node-RED restart recovery policy

- Khi Node-RED khởi động/restart, **MUST** clear toàn bộ pending commands và unlock-command correlation trong runtime; không restore hoặc replay actuator command cũ.
- Live-state cache sau restart bắt đầu empty/stale. Controls phải disabled và không được dùng retained last-known state như bằng chứng rằng device đang fresh.
- Node-RED reconnect MQTT, chờ availability cùng retained full state hợp lệ; gửi `GET_STATE` nếu state còn thiếu/stale. Chỉ enable controls sau khi MQTT Broker, ESP32 availability và state freshness đều được xác nhận theo Dashboard state rules.
- ACK cũ đến sau restart không có pending entry tương ứng nên bị drop/ghi diagnostic an toàn; nó không được biến command cũ thành success. State hợp lệ trong ACK chỉ có thể được dùng cho reconciliation theo validation/freshness policy, không khôi phục request cũ.
- Sau restart, detector chỉ phân loại lại khi retained full state hoặc ACK hợp lệ xác nhận lock state fresh; last-known state stale không được dùng để bật/tắt cảnh báo.
- Không tạo persistent queue/database cho pending command hoặc unlock correlation chỉ để xử lý restart. Runtime state đơn giản + retained full state/`GET_STATE` reconciliation là contract bắt buộc.

### One-time unlock authorization và unauthorized-open rule

- Mỗi ACK `UNLOCK` thành công khi MC-38 đang `CLOSED` cấp một quyền cho đúng cạnh `CLOSED→OPEN` tiếp theo trong 30 giây. Cạnh đầu tiên consume quyền và arm auto-lock; `OPEN→CLOSED` kế tiếp tự chạy `LOCK=80°`. Nếu quyền không được dùng, đúng hạn 30 giây cũng tự khóa khi cửa stable/raw `CLOSED`. `LOCK`, hết hạn và reboot thu hồi quyền.
- Current firmware quyết định tại cạnh OPEN và gửi `authorized:true|false`. `true` chỉ phát `DOOR_OPENED`; `false` bật còi cục bộ, phát thêm `UNAUTHORIZED_OPEN`, cập nhật latest alert và gửi Telegram. Auto-lock chạy cục bộ, không chờ mạng và không phát ACK giả; mở/ép lại khi chưa có ACK `UNLOCK` mới là unauthorized.
- Node-RED ưu tiên quyết định explicit của firmware. Bounded UNLOCK window phía backend chỉ để gắn `command_id` và hỗ trợ producer legacy không có field `authorized`; restart backend không được đổi ngược quyết định của firmware.
- Retained state chỉ hòa giải một OPEN thành unauthorized khi cùng snapshot xác nhận `alarm=ACTIVE`; OPEN với alarm inactive chờ transition telemetry để tránh cảnh báo giả.
- Chỉ cảnh báo trên stable transition/episode. Duplicate telemetry hoặc door vẫn `OPEN` không gửi lặp; transition về `CLOSED` mới reset episode. Telegram có dedupe/rate-limit theo locker + episode/event ID.

### Normalized event types và persistence contract

Canonical event types:

`DOOR_OPENED`, `DOOR_CLOSED`, `DOOR_UNKNOWN`, `LOCK_COMMAND`, `UNLOCK_COMMAND`, `LOCK_STATE_CHANGED`, `ALARM_STARTED`, `ALARM_STOPPED`, `LED_TURNED_ON`, `LED_TURNED_OFF`, `DEVICE_ONLINE`, `DEVICE_OFFLINE`, `UNAUTHORIZED_OPEN`, `COMMAND_REJECTED`, `COMMAND_TIMEOUT`, `TELEGRAM_NOTIFICATION`, `DAILY_EMAIL_REPORT`.

Mỗi normalized event phải có:

- `event_id` UUID để dedupe insert.
- `schema_version`, `locker_id`, `event_type`.
- `device`: `door`, `lock`, `alarm`, `led`, `system` hoặc `notification`.
- `action` nullable; `source`: `sensor`, `dashboard`, `system`, `automation`.
- `result`: `observed`, `success`, `failure`, `rejected` hoặc `timeout`.
- `authorized`: boolean bắt buộc cho `DOOR_OPENED`/`UNAUTHORIZED_OPEN`, `null` cho event không áp dụng.
- `command_id` bắt buộc cho command/ACK-derived event, nullable cho telemetry.
- `device_state`, `error`, metadata tối thiểu không chứa secret/JWT.
- `occurred_at` UTC và `recorded_at` server-side. Nếu device time không tin cậy, `occurred_at` dùng Node-RED receive time và metadata ghi `device_time_unsynced=true`.

Counting rule bắt buộc để chart/report/chatbot không đếm khác nhau:

- “Số lần mở tủ” = số event `DOOR_OPENED` đã dedupe trong khoảng thời gian.
- “Số cảnh báo” = số event `UNAUTHORIZED_OPEN` đã dedupe trong khoảng thời gian.
- Một lần mở trái phép tạo cả `DOOR_OPENED authorized=false` và `UNAUTHORIZED_OPEN`; nó tính một lần mở và một cảnh báo, không tạo hai cảnh báo.

### Database entities đề xuất

Không tạo SQL ở baseline; Phase 2/3 hiện thực bằng versioned migrations.

| Entity | Trường/ý nghĩa tối thiểu | Owner triển khai |
|---|---|---|
| `profiles` | `user_id` liên kết Auth, full name, created time | Minh / Phase 2 |
| `lockers` | UUID, unique `locker_code`, `owner_id`, display name, claim state/time | Minh / Phase 2 |
| `device_events` | event ID, locker FK, type, device/action/source/result/authorized/command ID, state/error/metadata, occurred/recorded timestamps | Thùy / Phase 3 |
| `notification_settings` | locker FK, Telegram enabled + backend-only private destination, email enabled/address, report time, timezone | Thùy / Phase 3; Minh cung cấp ownership contract |
| `notification_deliveries` | channel, locker, report/event key, status, attempted/sent time, bounded error; unique dedupe key | Thùy / Phase 3 |

RLS/ownership rules:

- User chỉ đọc/update profile của chính mình theo policy phù hợp.
- User chỉ đọc locker có `owner_id = auth.uid()`; không được tự sửa `owner_id` từ frontend.
- Claim locker là thao tác server-side/RPC đã xác thực, atomic, chỉ cho locker chưa claim; code sai/đã claim bị từ chối.
- Event/history/settings/deliveries chỉ đọc khi user sở hữu locker liên quan; write event từ Node-RED backend sau auth/ownership hoặc bằng service-role bảo vệ tuyệt đối.
- Frontend chỉ có Supabase URL + publishable/anon key. Service-role key chỉ nằm ở Node-RED environment/secret store.
- Node-RED validate access token với Supabase Auth, lấy user ID đáng tin cậy, rồi kiểm tra ownership trước mọi command/history/chatbot/settings request. `locker_id` do client gửi chỉ là selector không đáng tin và luôn phải ownership-check trước side effect.

### Supabase Auth Transport Contract

- Browser/FlowFuse Dashboard thực hiện Supabase sign-up/sign-in và nhận authenticated session; protected request sang Node-RED phải mang **Supabase access token hiện hành**, không tự tạo token hoặc identity thứ hai.
- Transport mặc định cần freeze ở đầu Phase 2 là HTTP `Authorization: Bearer <access_token>` nếu implementation FlowFuse Dashboard thực tế hỗ trợ phù hợp. Phase 2 phải xác minh bằng request thật và ghi rõ route, header, refresh/expiry behavior cùng CORS cần thiết trong `docs/auth-ownership.md` **trước** khi xây toàn bộ protected command/history/chatbot/settings flows.
- Nếu FlowFuse Dashboard cần `ui-template`/`fetch` hoặc cơ chế tương đương để gắn `Authorization` header, chọn cách đơn giản nhất và tài liệu hóa. Chỉ dùng một canonical auth transport; không vận hành song song Bearer + custom token/cookie/session mechanism nếu không có constraint thực tế được ghi bằng evidence.
- Node-RED validate access token với Supabase trước side effect; `user_id` luôn lấy từ verified token, tuyệt đối không tin `user_id` do browser gửi. Mọi `locker_id` trong request phải qua ownership check cho user đã verify.
- Supabase service-role key chỉ ở Node-RED/backend secret store, không được gửi ra browser. Không log full JWT, không lưu JWT trong event metadata và không đưa JWT vào Gemini context.
- Không thêm backend framework/service mới chỉ để vận chuyển hoặc validate token; dùng FlowFuse/Node-RED + Supabase theo implementation đơn giản nhất đáp ứng contract này.

### Timestamp và timezone

- Truyền và lưu chuẩn UTC ISO 8601 có hậu tố `Z`; database dùng `timestamptz`.
- `Asia/Ho_Chi_Minh` là timezone hiển thị/report mặc định, nhưng phải lưu theo từng notification setting.
- Chart 7 ngày = ngày hiện tại và 6 ngày lịch trước; chart 30 ngày = ngày hiện tại và 29 ngày lịch trước, tính boundary theo timezone người dùng rồi chuyển UTC khi query.
- Daily report mặc định tổng hợp ngày lịch trước `[00:00, 24:00)` theo timezone đã cấu hình.
- Không dùng local timezone của máy Node-RED một cách ngầm định; DST/timezone conversion phải nằm ở một utility/subflow dùng chung.

### Environment variables và secret boundaries

Tên biến đề xuất; `.env.example` chỉ để placeholder:

- Device/deployment: `LOCKER_ID`, `MQTT_HOST`, `MQTT_PORT`, `MQTT_USERNAME`, `MQTT_PASSWORD`, `MQTT_TLS`, `MQTT_CA_CERT_PATH`.
- Runtime: `COMMAND_TIMEOUT_MS`, `COMMAND_MAX_AGE_SECONDS`, `DEVICE_STALE_AFTER_SECONDS`, `DASHBOARD_BASE_URL`.
- Supabase: `SUPABASE_URL`, `SUPABASE_ANON_KEY`, `SUPABASE_SERVICE_ROLE_KEY`.
- Telegram: `TELEGRAM_BOT_TOKEN`, public bot username và secret webhook riêng; không dùng global `TELEGRAM_CHAT_ID`.
- Email: `GMAIL_SMTP_HOST`, `GMAIL_SMTP_PORT`, `GMAIL_SMTP_USER`, `GMAIL_APP_PASSWORD`, `EMAIL_FROM`.
- Gemini: `GEMINI_API_KEY`, `GEMINI_MODEL`.
- Node-RED: `NODE_RED_CREDENTIAL_SECRET`, `REPORT_TIMEZONE`.

Wi-Fi SSID/password không thuộc `.env`: nhập qua captive portal, lưu trong ESP32/NVS và không publish/log/đưa lên Cloud. MQTT credential firmware được provision bằng file local bị ignore hoặc cơ chế runtime đã tài liệu hóa; không hard-code trong source hay `platformio.ini` được commit.

### Dashboard state rules

Control chỉ enable khi đồng thời:

1. User đã đăng nhập.
2. Session/JWT còn hiệu lực.
3. Ownership đúng locker.
4. Node-RED đang connected với MQTT Broker.
5. ESP32 `ONLINE` và state chưa stale.
6. Không có command xung đột đang pending.

UI rules:

- Click control chuyển đúng domain sang `PENDING`, disable control xung đột và hiển thị spinner/command ID rút gọn.
- Chỉ hiển thị success sau ACK hợp lệ. Publish thành công vào broker không phải device success.
- Timeout/error/rejected phải hiện lý do có kiểm soát và không đổi state mong muốn thành state thực.
- `MQTT Disconnected` và `ESP32 Offline` là hai trạng thái riêng; cả hai disable control.
- Khi Offline/stale: door hiển thị `UNKNOWN`; actuator có thể hiện last-known kèm nhãn stale nhưng không được trình bày như current truth.
- Lock `UNKNOWN` phải hiển thị nhãn chưa xác nhận và không được trình bày như `LOCKED`/`UNLOCKED`; chỉ ACK/state từ command `LOCK`/`UNLOCK` thực sự được controller thực hiện mới xác nhận lock state.
- State cache **MUST** lưu value, source, device timestamp, Node-RED observed time và stale flag theo locker; `boot_id` là **SHOULD** nếu firmware đã cung cấp nhất quán.
- Session hết hạn: xóa state UI nhạy cảm, disable control, yêu cầu đăng nhập lại; không âm thầm dùng service credential thay user.
- User không sở hữu locker nhận `403`/thông báo phù hợp; request không được publish MQTT.
- Recent events, chart, chatbot và notification settings đều lọc theo locker ownership.

### Candidate pin map cần Phase 1 xác nhận trên board thật

| Chức năng | Candidate GPIO | Ghi chú |
|---|---:|---|
| MC-38 | GPIO 27 | `INPUT_PULLUP` nếu wiring phù hợp; xác nhận logic đảo |
| Servo SG90 signal | GPIO 18 | PWM; servo lấy 5 V từ rail nguồn, không từ GPIO/3.3 V |
| Active Buzzer control | GPIO 26 | LOW-trigger: `IN` qua 4,7 kΩ, module `VCC→3V3`, `GND` chung; public baseline active-low; GPIO không cấp VCC/tải |
| DHT22 data | GPIO 4 | Cấp và kéo data lên 3.3 V; dùng 4.7–5.1 kΩ nếu module chưa có; không kéo GPIO lên 5 V |
| WS2812B data | GPIO 25 | Revision demo dùng Direct-D qua 330–470 Ω gần DIN và bắt buộc qua direct/full-load gate; nếu không ổn định thì đổi sang đúng 74AHCT125 không đảo hoặc hai cổng 74HCT14 nối tiếp, không dùng SN74HC125N như TTL buffer |
| OLED SDA | GPIO 21 | I2C mặc định; pull-up nhìn thấy từ ESP32 phải về 3.3 V hoặc qua level shifter đã xác minh |
| OLED SCL | GPIO 22 | I2C mặc định; pull-up nhìn thấy từ ESP32 phải về 3.3 V hoặc qua level shifter đã xác minh |

Tránh dùng GPIO boot-strapping hoặc input-only nếu không có lý do/kiểm thử. Pin map chỉ được xem là khóa sau khi Phase 1 đo board, kiểm tra boot, test từng module và cập nhật `hardware/pin-map.md` + `docs/mqtt-contract.md` nếu state mapping bị ảnh hưởng.

## 5. Phase 1 — Thái Quang Huy

### Phase Goal

**Status: COMPLETED. Owner: Thái Quang Huy — 24127177.**

Phase 1 software baseline accepted by project maintainer.

Khởi tạo nền tảng repository và firmware ESP32; khóa pin map/MQTT contract; triển khai firmware foundation, CB2, YC1, YC3, YC12 đủ để Minh thêm CB1 và xây Node-RED orchestration ở Phase 2. Phase 1 không tuyên bố CB2/YC3 end-to-end qua Dashboard đã hoàn thành khi auth/dispatcher/final Dashboard chưa tồn tại.

### Minimum Required Completion Path

Để Phase 1 chuyển từ `ACTIVE` sang `COMPLETED`, Terra phải ưu tiên và hoàn tất SOFTWARE-GATE `MUST`: repository/toolchain build được; candidate pin map/wiring/power documentation; frozen command/ACK/state contract; Wi-Fi/MQTT/CB2/YC1/YC3/YC12 implementation và contract coverage; parser/validation/dedupe; broker/simulator integration khi harness có sẵn; build/test/evidence thật; commit/push/integration handoff. Mọi xác minh pin map trên board, power/wiring thật, servo, DHT/OLED, LED, captive portal và physical MQTT recovery là `DEFERRED — HARDWARE-FINAL-GATE` nếu chưa có hardware; không làm `OPTIONAL` trước software critical path này.

### Dependencies

- Hai PDF nguồn và Sections 1–4 của `PLAN.md`.
- ESP32 DevKit V1 Type-C, MC-38 để reserved pin integration, SG90, DHT22, OLED SSD1306, WS2812B, nguồn 5 V/3 A, dây/đầu nối và linh kiện bảo vệ thực tế. Khi chưa mua/chưa có, đây là blocker riêng của HARDWARE-FINAL-GATE, không chặn software baseline hoặc Phase 2 software sau khi Phase 1 đã tích hợp vào `develop`.
- MQTT Broker development endpoint/credential hoặc broker local có cấu hình tương đương; không commit credential.
- MQTT topics/payload/error semantics phải được ghi đầy đủ, không còn TBD và được khóa bằng contract/fixtures/tests trước khi Phase 2 dùng.
- Git remote/permissions để hoàn tất push Phase branch và `develop`; thiếu remote không được giả evidence.

### Deliverables

- Repository baseline (`README.md`, `.gitignore`, `.env.example`) và target directories cần thiết cho Phase 1.
- PlatformIO firmware project có module boundaries, config example và build/test command được tài liệu hóa.
- Wi-Fi provisioning, MQTT connect/reconnect/LWT/availability, full-state publish, command parser, state manager, duplicate protection và ACK publisher.
- CB2 Servo SG90 controller + cấu hình góc + firmware command/ACK/state.
- YC1 DHT22 → OLED local display + error state, không publish temperature/humidity lên Dashboard.
- YC3 WS2812B ON/OFF + firmware command/ACK/state.
- YC12 WiFiManager captive portal, reset/configuration guide và reconnect Internet/MQTT.
- Pin map, wiring/power guide, MQTT contract v1, firmware README, test case/evidence index.

### Files and Directories to Create or Modify

Đây là danh sách dự kiến cho lúc triển khai, không phải file đã tồn tại:

| Đường dẫn | Nội dung |
|---|---|
| `README.md`, `.gitignore`, `.env.example` | Baseline repo, secret/build ignore, placeholder config |
| `firmware/platformio.ini` | Board/framework/dependency versions đã pin; không chứa secret |
| `firmware/include/app_config.example.h`, `firmware/include/pin_map.h`, `firmware/include/secrets.example.h` | Cấu hình public/candidate pins/secret template vô hại |
| `firmware/src/main.cpp` | Non-blocking orchestration loop và module wiring |
| `firmware/src/wifi_provisioning.*`, `mqtt_client.*` | WiFiManager, connection/backoff, subscriptions, LWT |
| `firmware/src/state_manager.*`, `command_handler.*`, `ack_publisher.*` | State, JSON validation, dedupe, ACK/full state |
| `firmware/src/lock_controller.*` | Servo CB2 |
| `firmware/src/environment_monitor.*`, `display_controller.*` | DHT22/OLED YC1 |
| `firmware/src/led_controller.*` | WS2812B YC3 |
| `firmware/test/` | Parser/state/dedupe tests chạy không cần hardware khi khả thi |
| `hardware/pin-map.md`, `hardware/power-budget.md`, `HUONG_DAN_CHAY_HE_THONG.md`, `HUONG_DAN_TEST_END_TO_END.md` | Pin/calibration, common ground, nguồn và post-assembly acceptance; các assembly guide lỗi thời đã xóa theo xác nhận của người dùng |
| `docs/requirements.md`, `docs/architecture.md`, `docs/mqtt-contract.md` | Baseline requirement/architecture/shared contract |
| `tests/test-plan.md`, `tests/evidence/phase-1/` | Test spec và evidence thật, không chứa secret |
| `PLAN.md` | Chỉ cập nhật trạng thái/evidence/commit/remote state thực |

### Implementation Checklist

Các bullet cần board, module, nguồn hoặc cơ khí bên dưới vẫn là `MUST` cho final release, nhưng khi hardware chưa có chúng được theo dõi bằng P1-M01–P1-M11 và Section 9 với nhãn `DEFERRED — HARDWARE-FINAL-GATE`; chúng không chặn SOFTWARE-GATE handoff Phase 1.

- [ ] **[MUST]** Khởi tạo repository baseline và cấu trúc tối thiểu cần cho Phase 1.
  - File/module dự kiến: `README.md`, `.gitignore`, `.env.example`, các thư mục cần dùng trong bảng trên.
  - Kết quả phải đạt: người mới hiểu dự án, toolchain và secret policy; build/cache/local config bị ignore đúng.
  - Cách kiểm tra: audit tree, `git status`, ignore checks với file placeholder local và secret scan diff.
  - Điều kiện được tick: chỉ các file có nội dung thật được tạo, không có source ngoài scope/secret/build artifact và baseline tự tái lập được theo README.

- [ ] **[MUST]** Chọn, pin và tài liệu hóa PlatformIO/ESP32 Arduino toolchain cùng firmware architecture.
  - File/module dự kiến: `firmware/platformio.ini`, `firmware/README.md`, module headers/sources.
  - Kết quả phải đạt: clean build tái lập được; mỗi module có một trách nhiệm; loop không bị chặn bởi thao tác thiết bị/network.
  - Cách kiểm tra: chạy clean build và parser/unit tests trên môi trường được ghi lại; audit dependency versions.
  - Điều kiện được tick: build thật exit 0, không warning nghiêm trọng bị bỏ qua, command/build output và phiên bản đã ghi evidence.

- [ ] **[MUST]** Chốt pin map, wiring, power budget và nguyên tắc nguồn trên phần cứng thật.
  - File/module dự kiến: `firmware/include/pin_map.h`, `hardware/pin-map.md`, wiring diagram, assembly guide.
  - Kết quả phải đạt: pin không xung đột/ảnh hưởng boot; common ground; servo/LED/buzzer không lấy dòng từ GPIO; protection parts được ghi rõ.
  - Cách kiểm tra: continuity/polarity check, boot test từng module, đo rail không tải/có tải, đối chiếu candidate map Section 4.
  - Điều kiện được tick: as-built pin-map evidence đã được ghi, không còn pin TBD ảnh hưởng Phase 2. Khi chưa có hardware, mục này giữ `[ ] DEFERRED — HARDWARE-FINAL-GATE`.

- [ ] **[MUST]** Khóa MQTT topics, payload, enum, error và timeout contract v1 với Minh.
  - File/module dự kiến: `docs/mqtt-contract.md`, fixtures trong `firmware/test/`.
  - Kết quả phải đạt: contract chứa command/ACK/state/door/availability, QoS/retained thực tế, schema version và sample hợp lệ/lỗi.
  - Cách kiểm tra: audit producer/consumer matrix, validate fixtures, walkthrough valid/invalid/duplicate/reconnect cases.
  - Điều kiện được tick: không còn field/type/topic TBD, contract version được ghi và fixtures/tests bám đúng frozen contract.

- [ ] **[MUST]** Xây Wi-Fi foundation và YC12 WiFiManager captive portal.
  - File/module dự kiến: `wifi_provisioning.*`, config example, user setup section.
  - Kết quả phải đạt: dùng Wi-Fi đã lưu; khi không kết nối được thì mở AP/portal; lưu Wi-Fi mới; có bounded portal/reconnect behavior và cách reset cấu hình.
  - Cách kiểm tra: MANUAL bằng điện thoại với Wi-Fi cũ sai/không có, nhập Wi-Fi mới, restart và kiểm tra NVS/reconnect mà không lộ password.
  - Điều kiện được tick: captive portal/reconnect/reset đều có video/log đã che secret và ESP32 không cần nạp lại firmware.

- [ ] **[MUST]** Xây MQTT connect/reconnect, subscription, LWT/availability và full-state recovery.
  - File/module dự kiến: `mqtt_client.*`, `state_manager.*`, `main.cpp`.
  - Kết quả phải đạt: unique client ID; backoff có giới hạn; command non-retained; LWT retained; publish `ONLINE`, drain door outbox, rồi full state sau reconnect trước khi nhận command.
  - Cách kiểm tra: MANUAL ngắt broker/Wi-Fi/restart ESP32, quan sát broker/Node-RED debug client và timestamp.
  - Điều kiện được tick: recovery lặp lại được, không busy-loop/reset vô hạn, LWT và full state đúng contract có evidence.

- [ ] **[MUST]** Xây command parser, action validation, duplicate cache và ACK publisher.
  - File/module dự kiến: `command_handler.*`, `ack_publisher.*`, `state_manager.*`, parser tests.
  - Kết quả phải đạt: validate JSON/field/locker/action/time; invalid payload không actuation; duplicate không actuation lần hai; ACK lỗi rõ. Malformed JSON không lấy được `command_id` không tạo normal ACK; payload lấy được `command_id` nhưng lỗi field/action khác tạo correlated error ACK.
  - Cách kiểm tra: automated fixtures cho valid action, missing field, malformed JSON có/không lấy được `command_id`, invalid action/locker, stale và duplicate command; assert không có correlated ACK giả.
  - Điều kiện được tick: tất cả test đã chạy thật và có result artifact; không có broad fallback/silent ignore ngoài trường hợp contract quy định.

- [ ] **[MUST]** Bảo đảm scheduler/loop firmware non-blocking và state nhất quán.
  - File/module dự kiến: `main.cpp`, `state_manager.*`, các controller.
  - Kết quả phải đạt: MQTT loop/reconnect, sensor polling, display và actuator state machine cùng chạy; không dùng delay dài trong callback.
  - Cách kiểm tra: source audit, timing log có kiểm soát, chạy đồng thời reconnect/sensor/LED/servo.
  - Điều kiện được tick: không có blocking path làm mất MQTT keepalive và state transition có nguồn duy nhất.

- [ ] **[MUST]** Triển khai CB2 Servo SG90 với cấu hình `LOCK`/`UNLOCK` an toàn.
  - File/module dự kiến: `lock_controller.*`, config angles/timing, state/ACK integration.
  - Kết quả phải đạt: góc tập trung trong config; callback chỉ queue action; controller chuyển động hữu hạn; cold boot giữ `lock=UNKNOWN` và không di chuyển servo; chỉ command hợp lệ đã thực thi mới publish ACK/full state `LOCKED`/`UNLOCKED`.
  - Cách kiểm tra: automated controller boot/state test nếu khả thi; MANUAL cold reboot quan sát không có servo motion, rồi test servo không tải, có tải, chốt thật và command trùng.
  - Điều kiện được tick: reboot không tự di chuyển/giả vị trí; LOCK/UNLOCK lặp lại ổn định, không kẹt/quá góc/reset; ACK/state khớp và có ảnh/video/current evidence.

- [ ] **[MUST]** Triển khai YC1 DHT22 acquisition và OLED SSD1306 local display.
  - File/module dự kiến: `environment_monitor.*`, `display_controller.*`.
  - Kết quả phải đạt: chu kỳ đọc phù hợp DHT22; hiển thị nhiệt độ/độ ẩm; `NaN`/sensor missing hiển thị lỗi; firmware tiếp tục chạy.
  - Cách kiểm tra: MANUAL với sensor bình thường, tháo data/sensor lỗi, theo dõi OLED và MQTT connection.
  - Điều kiện được tick: display/read/error evidence đầy đủ và không có temperature/humidity topic/card Dashboard được tạo.

- [ ] **[MUST]** Triển khai YC3 WS2812B `LED_ON`/`LED_OFF`, ACK và state.
  - File/module dự kiến: `led_controller.*`, command/state integration.
  - Kết quả phải đạt: ON/OFF không block; brightness/current limit cấu hình; duplicate command không render lại không cần thiết; state chính xác.
  - Cách kiểm tra: parser/controller tests và MANUAL LED, nguồn LED, servo + LED đồng thời.
  - Điều kiện được tick: LED đúng trạng thái qua command contract, ACK/state đúng, không reset/overheat và power evidence đạt.

- [ ] **[MUST]** Tích hợp firmware foundation và kiểm tra recovery/state reconciliation.
  - File/module dự kiến: toàn bộ `firmware/src/`, integration fixtures, firmware README.
  - Kết quả phải đạt: cold boot áp dụng safe-state policy mà không di chuyển servo; boot → Wi-Fi → MQTT → running; GET_STATE; full state sau reconnect; invalid/duplicate command không làm hỏng loop.
  - Cách kiểm tra: scripted broker messages khi khả thi và MANUAL restart/mất mạng/khôi phục nhiều vòng.
  - Điều kiện được tick: các path thành công/lỗi/recovery có evidence, không có debug secret hoặc temporary instrumentation trong diff.

- [ ] **[MUST]** Hoàn thiện tài liệu Phase 1 và evidence index.
  - File/module dự kiến: firmware/hardware docs, `tests/test-plan.md`, `tests/evidence/phase-1/`, `PLAN.md`.
  - Kết quả phải đạt: người khác có thể build, wire, flash, reset Wi-Fi và chạy test; evidence liên kết với Test ID.
  - Cách kiểm tra: tái tạo theo README khi khả thi, final diff audit và secret scan.
  - Điều kiện được tick: software acceptance đạt; mọi physical MANUAL test chưa thể chạy giữ `[ ] DEFERRED — HARDWARE-FINAL-GATE` với procedure/evidence rõ và vẫn chặn final release.

### Tests

Không ghi `PASS` trước khi chạy. `P1-Sxx` là SOFTWARE-GATE broker/simulator integration, không cần board nhưng vẫn cần command/output thật. `P1-Mxx` là physical ESP32 verification; khi nhóm chưa có hardware, giữ `[ ]` và dùng nhãn `DEFERRED — HARDWARE-FINAL-GATE`.

| Test ID | Kịch bản | Bước thực hiện | Kết quả mong đợi | Loại | Evidence cần lưu |
|---|---|---|---|---|---|
| P1-A01 | Clean firmware build | Checkout sạch; cài toolchain đúng README; chạy clean/build | Build exit 0 cho đúng board profile; không cần secret thật | Automated | Command, tool versions, full build log |
| P1-A02 | Valid command parser | Feed từng action hợp lệ và required fields | Parse đúng; locker/action/UUID được validate; queue đúng domain | Automated | Test report + fixtures |
| P1-A03 | Invalid JSON/missing field/action | Feed malformed JSON không lấy được ID, rồi payload lấy được valid `command_id` nhưng lỗi field/action | Không actuation; case không có ID không phát normal ACK; case có ID phát correlated `result:error` | Automated | Test report + assertion no-ACK/captured error ACK |
| P1-A04 | Duplicate command | Feed cùng `command_id` hai lần | Actuator handler gọi một lần; cached ACK phát lại với `duplicate:true` | Automated | Assertion/log không chứa secret |
| P1-S05 | MQTT broker/simulator recovery contract | Dùng `tools/device-simulator/` khi được tạo ở Phase 2 cùng broker test để phát availability/state, rồi mô phỏng OFFLINE/ONLINE, reconnect và GET_STATE | Consumer nhận retained availability + full state đúng contract; reconnect reconciliation không replay command; capture không được gọi là ESP32/LWT hardware evidence | SOFTWARE-GATE — broker/simulator integration | Simulator scenario, broker capture, automated/integration output |
| P1-S06 | MQTT broker/simulator command/ACK contract | Dùng simulator gửi LOCK/UNLOCK, LED_ON/OFF, ALARM_ON/OFF, GET_STATE; chạy success/error/duplicate/delayed/no-ACK/malformed fixtures | ACK/state/timeout/duplicate semantics đúng frozen contract; không khẳng định actuator vật lý hoặc firmware PubSubClient đã chạy | SOFTWARE-GATE — broker/simulator integration | Fixture + broker/test-runner output |
| P1-M01 | Servo không tải | Khi có hardware: cấp nguồn đúng; gửi UNLOCK/LOCK nhiều vòng | Góc đúng, không rung/kẹt/reset; ACK/state đúng | DEFERRED — HARDWARE-FINAL-GATE | Video, angle config, current/voltage note |
| P1-M02 | Servo có tải/cơ cấu chốt | Khi có hardware: lắp linkage; đóng/mở chốt lặp lại; xác minh chốt tự giữ cơ khí sau khi servo detach hay cần holding torque | Khóa/mở cơ khí tin cậy, không vượt travel/quá nhiệt; kết luận giữ lực được ghi trước khi sửa servo policy | DEFERRED — HARDWARE-FINAL-GATE | Video, ảnh cơ khí, kết luận holding-torque, defect log nếu có |
| P1-M03 | Servo power transient | Khi có hardware: quan sát 5 V và ESP32 khi servo khởi động/đảo chiều | Không brownout/MQTT drop; rail trong giới hạn đã chốt | DEFERRED — HARDWARE-FINAL-GATE | Meter/scope photo hoặc đo điện áp + serial/broker log |
| P1-M04 | DHT22 thành công + OLED | Khi có hardware: kết nối sensor; chạy qua nhiều chu kỳ | OLED hiển thị nhiệt độ/độ ẩm hợp lý, cập nhật đúng chu kỳ | DEFERRED — HARDWARE-FINAL-GATE | Ảnh OLED + serial diagnostic |
| P1-M05 | DHT22 lỗi/NaN | Khi có hardware: tháo hoặc gây lỗi sensor an toàn | OLED hiển thị lỗi; firmware/MQTT không treo; không publish YC1 lên Dashboard | DEFERRED — HARDWARE-FINAL-GATE | Video/ảnh + broker topic capture |
| P1-M06 | LED ON/OFF và nguồn | Khi có hardware: gửi LED_ON/OFF, test brightness đã chốt | LED đúng; ACK/state đúng; data/power ổn định | DEFERRED — HARDWARE-FINAL-GATE | Video, current/voltage note |
| P1-M07 | Servo + LED | Khi có hardware: chạy servo khi LED đang ON | ESP32/OLED/MQTT ổn định, không flicker/reset bất thường | DEFERRED — HARDWARE-FINAL-GATE | Video + broker/serial log |
| P1-M08 | WiFiManager bằng điện thoại | Khi có hardware: xóa config theo hướng dẫn; boot; kết nối AP; nhập Wi-Fi mới | Portal mở; credential lưu cục bộ; Internet/MQTT reconnect không reflash | DEFERRED — HARDWARE-FINAL-GATE | Screen recording đã che SSID/password + broker log |
| P1-M09 | MQTT physical ESP32 reconnect/LWT | Khi có hardware: ngắt Wi-Fi/broker đột ngột rồi khôi phục nhiều lần. Nếu tạo được điều kiện thực tế làm `PubSubClient::subscribe()` trả `false` ở local/send level thì lưu capture riêng. Broker ACL là deployment prerequisite; PubSubClient 2.8 không expose SUBACK grant/rejection nên không yêu cầu firmware phát hiện ACL reject. | ESP32 thật phát LWT `OFFLINE`; backoff bounded; `ONLINE` + full state sau reconnect. Local/send failure không để `ONLINE`/full state giả, đặt MQTT false, disconnect và retry bounded. | DEFERRED — HARDWARE-FINAL-GATE | Timestamped serial/broker log; local/send-failure setup nếu thực hiện được |
| P1-M10 | ESP32 physical restart/GET_STATE | Khi có hardware: đưa lock về trạng thái đã biết, restart board, quan sát servo; sau online gửi GET_STATE rồi gửi command mới | Restart không di chuyển servo/replay command; cold-boot state là lock UNKNOWN, alarm INACTIVE, LED OFF, door UNKNOWN; chỉ command mới xác nhận LOCKED/UNLOCKED. Không yêu cầu stable MC-38 sample ở Phase 1. | DEFERRED — HARDWARE-FINAL-GATE | Video servo + broker transcript + serial boot log |
| P1-M11 | ESP32 physical full-state retained semantics | Khi có hardware: ESP32 online/reconnected, dùng subscriber mới subscribe availability và state | Subscriber mới nhận retained availability và retained full state phù hợp từ ESP32 thật. Door telemetry non-retained/no old-event replay thuộc CB1 Phase 2. | DEFERRED — HARDWARE-FINAL-GATE | Broker subscription capture |

### Acceptance Criteria

Mọi mục trong phần này là `MUST`. `SHOULD`/`OPTIONAL` còn defer không được làm thất bại acceptance nếu Minimum Required Completion Path đã đạt và được ghi trong summary.

- [ ] **[SOFTWARE-GATE]** Repository/toolchain baseline có thể được tái tạo từ tài liệu trên checkout sạch.
- [ ] **[SOFTWARE-GATE]** Candidate pin map, wiring/power documentation và MQTT contract v1 đầy đủ, nhất quán với implementation/tests; physical pin/power verification còn được ghi riêng là hardware final gate, không phải `VERIFIED`.
- [ ] **[SOFTWARE-GATE]** Firmware clean build và automated parser/state/dedupe tests đã chạy thật, evidence được liên kết.
- [ ] **[PLANNED SOFTWARE-GATE — Phase 2 harness]** Broker/simulator integration cho availability, retained full state, GET_STATE, ACK/timeout/duplicate và reconnect contract sẽ chạy thật khi `tools/device-simulator/` được tạo ở Phase 2; output không được gọi là ESP32 evidence và không block Phase 1 software handoff trước khi harness tồn tại.
- [ ] **[SOFTWARE-GATE]** Invalid JSON/action/missing field/locker mismatch không gây actuation; chỉ command có `command_id` hợp lệ mới nhận correlated error ACK, malformed JSON không có ID sẽ timeout/reconcile.
- [ ] **[SOFTWARE-GATE]** CB2/YC1/YC3/YC12 implementation, cold-boot policy, state/ACK contract và documentation đủ để Phase 2 dùng frozen baseline mà không đổi contract một phía.
- [ ] **[SOFTWARE-GATE]** Không có secret, build output, cache, debug token hoặc kết quả test giả trong diff; handoff đủ để Minh bắt đầu Phase 2 từ `develop`.
- [ ] **[DEFERRED — HARDWARE-FINAL-GATE]** P1-M01–P1-M03: servo không tải/có tải, latch/holding torque, rail/power transient.
- [ ] **[DEFERRED — HARDWARE-FINAL-GATE]** P1-M04–P1-M05: DHT22/OLED physical success/error và actual I2C address.
- [ ] **[DEFERRED — HARDWARE-FINAL-GATE]** P1-M06–P1-M07: WS2812B physical ON/OFF và Servo + LED power stability.
- [ ] **[DEFERRED — HARDWARE-FINAL-GATE]** P1-M08–P1-M11: WiFiManager phone/board, physical ESP32 MQTT recovery/LWT, safe reboot và retained full-state verification.

### Git Checklist

- [ ] **Terra/owner:** Pull `develop` mới nhất nếu branch đã tồn tại; với Phase 1 bootstrap phải ghi đúng hiện trạng, không giả remote.
- [ ] **Terra/owner:** Xác nhận Phase 1 đang `ACTIVE`, owner đúng và switch/tạo `phase/1-huy-firmware-foundation`.
- [ ] **Terra/owner:** Bảo toàn hai PDF nguồn và mọi user work; không reformat/move ngoài scope.
- [ ] **Terra/owner:** Build/test SOFTWARE-GATE phù hợp đã chạy; mọi P1-M01–P1-M11 chưa có hardware giữ `[ ] DEFERRED — HARDWARE-FINAL-GATE`, không ghi PASS/VERIFIED.
- [ ] **Terra/owner:** Chạy final diff/source/secret audit; `PLAN.md` chỉ ghi evidence và remote state thật.
- [ ] **Terra/owner:** Commit thay đổi thuộc Phase và ghi hash thật vào Phase Completion Summary.
- [ ] **Terra/owner:** Push `phase/1-huy-firmware-foundation` lên GitHub; nếu không có quyền, giữ Phase `ACTIVE` và ghi exact command.
- [ ] **Terra/owner:** Khi SOFTWARE-GATE `PASS`, tạo/fast-forward `develop` tại Phase-1 HEAD và push `develop`; không rewrite history hoặc force push.
- [ ] **Terra/owner:** Chỉ sau push thành công, chuyển Phase 1 `ACTIVE → COMPLETED`, Phase 2 `NOT_STARTED → ACTIVE`, tạo `phase/2-minh-security-orchestration` từ `develop`, push branch rồi dừng.
- [ ] **Terra/owner:** Xác nhận P1-M01–P1-M11 vẫn `[ ] DEFERRED — HARDWARE-FINAL-GATE` và nằm trong Final Release checklist.

### Handoff

- Người nhận tiếp theo: **Nguyễn Văn Minh — 24127205**.
- Phase tiếp theo: **Phase 2 — CB1, YC6, YC8, YC9 và Node-RED orchestration**.
- Contract phải đọc: Sections 4; `docs/mqtt-contract.md`; pin map; firmware README; command/ACK/error/duplicate/time và cold-boot/Servo safe-state contracts.
- Những phần đã hoàn thành (SOFTWARE-GATE): repository/toolchain baseline; PlatformIO firmware foundation; WiFiManager lifecycle; MQTT v1 parser/validation/dedupe/ACK/state/LWT/reconnect; CB2, YC1 và YC3 software implementation; pin/wiring/power documentation; automated build/native evidence.
- Những phần còn MANUAL: P1-M01–P1-M11 là `DEFERRED — HARDWARE-FINAL-GATE` do nhóm chưa có ESP32/module; chúng không có evidence/PASS và phải chạy lại trước final release/demo. Các full-system case phụ thuộc Node-RED/Supabase/Dashboard vẫn được ghi `FINAL-GATE` cho Phase 3, không bị trình bày là đã pass.
- Dependency được mở khóa sau SOFTWARE-GATE và integration/push: firmware buildable; CB2/YC1/YC3/YC12 software baseline; MQTT/LWT/state/ACK contract; candidate pin map documentation; contract v1. Physical pin/wiring/power behavior chưa được unlock/verified.
- Dependency vẫn dành cho Phase 3: actual buzzer, event persistence, chart, email và final Dashboard.
- Phase 1 software baseline accepted by project maintainer.
- Phase 1 là `COMPLETED`; Phase 2 là `ACTIVE` và bắt đầu từ `develop`; Phase 3 giữ `NOT_STARTED`. Hardware final gates vẫn pending.

### Phase Completion Summary

- Status: COMPLETED — tất cả MUST SOFTWARE-GATE implementation, documentation, automated evidence, secret/diff audit và Git handoff đã được re-audit; software baseline đã được project maintainer chấp nhận. P1-M01–P1-M11 đều `[ ] DEFERRED — HARDWARE-FINAL-GATE` do nhóm chưa có ESP32/module; chúng không phải PASS/VERIFIED, không chặn Phase 2 software, nhưng vẫn bắt buộc trước final release/demo.
- Implementation: Repository baseline; PlatformIO ESP32 Arduino firmware foundation; WiFiManager; MQTT v1 parser/validation/dedupe/ACK/state/LWT/reconnect; CB2 SG90 state machine with cold-boot no-motion; YC1 local DHT22/OLED error display; YC3 WS2812B control; wiring/power/test/docs created. Targeted patch: a transport connection is operational only after PubSubClient 2.8 sends the `command` SUBSCRIBE packet successfully at local/send level; it does not expose broker SUBACK grant/rejection. A local/send failure keeps MQTT state false, publishes `OFFLINE` when possible, disconnects, and follows bounded retry. OLED I2C address is `AppConfig::OLED_I2C_ADDRESS` (default `0x3C`), not a display-source literal; local calibration copies the full ignored `app_config.h` from the example and edits it directly. CB1/YC6/YC8/YC9/CB3/YC4/YC5/YC7 were not implemented.
- Automated tests: PASS — SOFTWARE-GATE re-audit at `8695b3c` ran P1-A01 clean `esp32dev` build (PlatformIO Core 6.1.18, `espressif32@6.10.0`) and P1-A02/P1-A03/P1-A04 native contract suite 7/7. Evidence: `tests/evidence/phase-1/automated-results.md`.
- Planned broker/simulator tests: P1-S05/P1-S06 remain PLANNED SOFTWARE-GATE scenarios for the Phase 2 harness. They are not hardware evidence and do not create a circular dependency that blocks this Phase 1 handoff.
- Deferred HARDWARE-FINAL-GATE tests: P1-M01–P1-M11 remain `[ ]` because the group has not bought/received ESP32 or modules. P1-M09 remains the physical ESP32 Wi-Fi/broker reconnect/LWT check and P1-M02 must determine mechanical self-holding versus holding torque before any servo-policy change. Section 8/full-system hardware tests remain mandatory before final release/demo.
- Known issues: PlatformIO Core 6.1.18 fails from the current Windows path containing Vietnamese characters; documented ASCII-path build workaround was used. Default Arduino partition build uses 83.7% flash (16.3% remaining). Candidate pin map vẫn chờ physical as-built verification; trạng thái này không phải `VERIFIED`.
- Deferred SHOULD/OPTIONAL items at the original Phase 1 handoff: `boot_id`/sequence telemetry and optional local TLS. The later pre-purchase electrical audit supersedes the old conditional WS2812B note: the 5 V data path now requires a 5 V-powered 74AHCT125, or two cascaded 74HCT14 inverter gates so the output is not inverted, plus a 330–470 Ω series resistor and 470–1000 µF local bulk capacitor unless the exact purchased module's primary datasheet proves an equivalent safe interface. No optional scope was used to replace a MUST.
- Branch: `phase/1-huy-firmware-foundation` pushed to `origin/phase/1-huy-firmware-foundation`.
- Accepted baseline commit: `4dd72fa` — Phase 1 source/docs/PDF baseline trước workflow-transition commit; remote branch HEAD là source of truth cho commit mới nhất.
- Integration: `develop` được tạo tại accepted Phase-1 HEAD và push; không yêu cầu Pull Request.
- Maintainer acceptance: Phase 1 software baseline accepted by project maintainer.
- Next phase: Phase 2 `ACTIVE` trên `phase/2-minh-security-orchestration`, tạo từ `develop`. Hardware final gates remain open until final release.

## 6. Phase 2 — Nguyễn Văn Minh

### Phase Goal

**Status: COMPLETED. Owner: Nguyễn Văn Minh — 24127205.**

Phase này đã `COMPLETED` sau khi Phase 1 mở dependency trên `develop`; P1/P2 hardware final gates vẫn deferred. Baseline đã triển khai CB1; nền tảng Node-RED authentication/authorization/command orchestration; YC9; logic YC6 và Telegram; YC8 routing/grounding. Interface cho actual buzzer và event persistence được bàn giao sang Phase 3, không chuyển ownership YC6 hoặc YC8.

### Minimum Required Completion Path

Để Phase 2 chuyển từ `ACTIVE` sang `COMPLETED`, Terra phải hoàn tất SOFTWARE-GATE `MUST`: CB1 debounce/state semantics qua unit tests và simulator; Supabase Auth/session/ownership/RLS và frozen auth transport; Node-RED validation + secure dispatcher; pending/ACK/timeout/dedupe/restart recovery; live-state cache; one-time unlock + unauthorized detector; `UNAUTHORIZED_OPEN`/`ALARM_ON` interface; Telegram path; YC8 live/history adapter contract và grounded failure behavior; regression/evidence; commit/push/`develop` integration. Physical MC-38/ESP32 verification được defer thành HARDWARE-FINAL-GATE khi hardware chưa có. Actual CB3, YC4 persistence và history backend thật vẫn thuộc Phase 3. Không làm `OPTIONAL` trước software critical path này.

### Dependencies

- Phase 1 software baseline đã `COMPLETED` và có trên `develop`, handoff có evidence và MQTT contract v1 đã freeze; physical pin map/wiring vẫn là deferred hardware final gate cho đến khi có evidence thật.
- Firmware build được; Wi-Fi/MQTT/LWT/state/ACK parser foundation có software evidence. Hardware behavior trên ESP32 chỉ được coi là verified sau hardware final gates.
- Supabase development project và hai test account riêng; credential thật chỉ ở local/backend secret store.
- MQTT Broker/Node-RED development environment; Telegram bot và Gemini credential cho MANUAL tests khi được cấp.
- Normalized event/history adapter contract phải đầy đủ, versioned và có producer/consumer fixtures trước khi Phase 2 merge vào `develop`.
- Phase 2 không được giả actual buzzer ACK hoặc Supabase event persistence là production-complete; các dependency Phase 3 phải được ghi rõ.

### Deliverables

- Firmware `DoorSensor` cho MC-38: logic OPEN/CLOSED và boot/untrusted-state `UNKNOWN`, debounce, transition telemetry, timestamp; sequence/boot ID là `SHOULD`.
- Device simulator test harness theo frozen MQTT contract cho Phase 2 software/broker integration; không phải firmware production và không thay physical ESP32 verification.
- Node-RED modular foundation: MQTT connection, payload validation, availability/state cache, authenticated command dispatcher, pending map, ACK matching, timeout, dedupe và disabled-control state.
- YC9: Supabase Auth register/login/logout/session/JWT; frozen browser → Node-RED access-token transport; profile/locker ownership/claim; RLS; Node-RED token + ownership middleware; test User A/B.
- CB1 Dashboard state `OPEN/CLOSED/UNKNOWN` và updated time.
- YC6: firmware-first one-time unlock authorization, `UNAUTHORIZED_OPEN` event contract, `ALARM_ON` request, latest alert, Telegram delivery/rate-limit/failure handling.
- YC8: question classification, live-state path, history adapter, structured Gemini context do Node-RED tính facts, no-data/failure response. Sophisticated numeric-token validator là `OPTIONAL`.
- Contract và handoff cho Phase 3: normalized event, alarm integration, event persistence input, history query output, notification status.

### Files and Directories to Create or Modify

| Đường dẫn | Nội dung dự kiến |
|---|---|
| `firmware/src/door_sensor.*`, `firmware/include/pin_map.h`, `firmware/src/main.cpp` | MC-38 integration, debounce, telemetry/state |
| `firmware/test/door_sensor/` | Debounce/state-transition tests không cần hardware khi khả thi |
| `tools/device-simulator/` | Harness/fixtures broker MQTT giả lập device theo frozen contract cho contract, dispatcher, cache, ACK/timeout và reconnect tests; không phải production component |
| `node-red/flows.json`, `node-red/package.json`, `node-red/README.md` | Export nguồn FlowFuse/Node-RED, dependency và deploy guide |
| `node-red/test/`, `node-red/fixtures/` | Auth/dispatcher/ACK/YC6/chatbot contract tests, dữ liệu giả chỉ trong test |
| `supabase/migrations/` | Profiles, lockers, claim/ownership và RLS migrations của YC9 |
| `supabase/tests/` | Auth/RLS/ownership test scripts hoặc hướng dẫn integration test |
| `dashboard/README.md`, `dashboard/wireframes/` | Auth, connection/door/basic control and chatbot behavior spec |
| `docs/auth-ownership.md` | Token lifecycle, frozen browser → Node-RED transport, FlowFuse request implementation, claim flow và policy boundaries |
| `docs/event-contract.md`, `docs/chatbot-grounding.md` | Phase 3 interfaces và Gemini rules |
| `tests/evidence/phase-2/`, `tests/test-plan.md` | Test evidence/index cập nhật |
| `PLAN.md` | Status, evidence, handoff, commit/remote state thực |

Node-RED flow phải được tổ chức thành tab/subflow có trách nhiệm rõ: authentication/authorization, command dispatcher, ACK processor, telemetry/cache, unauthorized detector, Telegram, history adapter và chatbot. Không đặt toàn bộ logic trong một Function node lớn.

### Implementation Checklist

Các bullet CB1/MC-38 cần phần cứng thật vẫn là `MUST` cho final release, nhưng khi hardware chưa có chúng được theo dõi bằng P2-M01/P2-M02 và Section 9 với nhãn `DEFERRED — HARDWARE-FINAL-GATE`; simulator/unit/broker evidence không thay thế physical verification.

- [x] **[MUST]** Re-audit Phase 1 handoff và khóa contract bổ sung cho Phase 3.
  - File/module dự kiến: `docs/mqtt-contract.md`, `docs/event-contract.md`, fixtures dùng chung.
  - Kết quả phải đạt: Phase 2 không phá payload v1; normalized event, history request/response và alarm request có schema rõ.
  - Cách kiểm tra: producer/consumer walkthrough; contract fixture validation; audit change log.
  - Điều kiện được tick: mọi thay đổi contract được version hóa; fixtures chứng minh đủ dữ liệu để Phase 3 làm YC4/YC5/YC7.

- [ ] **[MUST]** Triển khai firmware CB1 cho MC-38 với stable debounce và semantics `UNKNOWN` khả thi.
  - File/module dự kiến: `door_sensor.*`, state manager integration, door tests.
  - Kết quả phải đạt: xác định logic điện thật; ánh xạ stable electrical state sang OPEN/CLOSED; debounce cấu hình hợp lý; chỉ publish stable change; boot trước stable sample là UNKNOWN; không flood event. Không tuyên bố phát hiện dây đứt bằng digital input thường.
  - Cách kiểm tra: automated debounce/boot-state tests và MANUAL reed switch đóng/mở liên tục. Test UNKNOWN bằng boot trước stable sample và Node-RED Offline/stale/invalid-payload scenarios, không dùng tháo dây làm bằng chứng broken-wire detection.
  - Điều kiện được tick: OPEN/CLOSED đúng trên board; UNKNOWN đúng các untrusted-state cases trong Section 4; telemetry/cache/Dashboard đúng contract và evidence đầy đủ.

- [x] **[MUST]** Xây Node-RED MQTT ingress/egress và payload validation.
  - File/module dự kiến: MQTT/config tab, validation subflows, fixtures.
  - Kết quả phải đạt: subscribe đúng locker topics; reject schema/type/locker/enum sai; không để invalid payload cập nhật cache/UI/persistence.
  - Cách kiểm tra: automated inject valid/invalid ACK/state/door/availability và broker integration test.
  - Điều kiện được tick: validation branches có test/evidence và error log không lộ payload nhạy cảm.

- [x] **[MUST]** Xây live-state cache và availability/staleness handling.
  - File/module dự kiến: telemetry/cache subflow, context schema, Dashboard state adapter.
  - Kết quả phải đạt: cache theo locker gồm state/source/timestamps/stale; phân biệt MQTT disconnected và device offline. Sau Node-RED restart cache bắt đầu empty/stale, controls disabled cho đến khi MQTT + availability + full state fresh; chỉ lưu boot ID/sequence nếu firmware cung cấp nhất quán (`SHOULD`).
  - Cách kiểm tra: inject retained state, LWT, invalid/missing state, late/duplicate message; restart Node-RED và assert cache stale/controls disabled, MQTT reconnect, retained state/GET_STATE reconciliation rồi mới enable.
  - Điều kiện được tick: stale/offline/restart đưa live state về untrusted, control gates nhận trạng thái đúng và không dùng retained state như bằng chứng online trước freshness confirmation.

- [ ] **[MUST]** Cấu hình Supabase development project và triển khai YC9 Auth register/login/logout/session lifecycle.
  - File/module dự kiến: project/auth settings được tài liệu hóa, Dashboard auth view, Node-RED auth endpoints/subflow, `docs/auth-ownership.md`.
  - Kết quả phải đạt: project URL/redirect/config được nạp qua environment; browser nhận Supabase authenticated session; signup/signin/signout thật; token không log; expiry/refresh behavior rõ; logout xóa session UI. FlowFuse transport thực tế được xác minh và freeze trước protected flows.
  - Cách kiểm tra: MANUAL bằng test account, redirect allowlist, expiry/revocation, browser reload; inspect network để xác nhận canonical `Authorization: Bearer <access_token>` hoặc alternative đã document; inspect log và frontend bundle/config.
  - Điều kiện được tick: register/login/logout/session hoạt động; auth transport duy nhất được ghi trong `docs/auth-ownership.md`; expired token bị từ chối; service-role key không ở frontend.

- [ ] **[MUST]** Triển khai profiles, lockers, one-time claim/ownership và RLS của YC9.
  - File/module dự kiến: versioned Supabase migrations/tests, claim backend/RPC, ownership docs.
  - Kết quả phải đạt: locker pre-provisioned chỉ được claim một lần bằng conditional update/constraint hoặc RPC đơn giản đã xác thực; owner không tự sửa; User A không đọc/claim/control Locker B.
  - Cách kiểm tra: MANUAL/Integration bằng hai account, direct REST query, claim locker chưa có owner, double claim locker đã có owner và unauthenticated cases. Concurrent stress/race harness nâng cao là `OPTIONAL`.
  - Điều kiện được tick: RLS deny đúng ở database, claim thứ hai bị từ chối, frontend dùng anon/publishable key và evidence không chứa PII/secret.

- [ ] **[MUST]** Xây Node-RED authentication middleware và ownership gate cho mọi route/message nhạy cảm.
  - File/module dự kiến: auth/authorization subflows dùng lại cho command, history, chatbot và settings; `docs/auth-ownership.md`.
  - Kết quả phải đạt: middleware chỉ nhận canonical frozen transport; token được Supabase xác minh; user ID lấy từ verified token; client-supplied user ID bị bỏ qua; locker ID luôn ownership-check; deny trước side effect; full JWT không vào log/Gemini.
  - Cách kiểm tra: automated matrix cho missing/malformed/expired Bearer token, spoofed `user_id`, User A–Locker B và valid owner; MANUAL FlowFuse request; broker capture xác nhận deny không publish.
  - Điều kiện được tick: unauthenticated nhận 401, wrong owner 403, session expired disable UI, không có bypass hoặc auth mechanism song song và transport khớp tài liệu.

- [x] **[MUST]** Xây command dispatcher, command ID generation và pending-command store.
  - File/module dự kiến: command dispatcher subflow, pending context, Dashboard response adapter.
  - Kết quả phải đạt: user request kiểm tra auth/ownership/MQTT/device/stale/conflict; trusted YC6 automation chỉ đi qua internal allowlisted entrypoint; sinh UUID/timestamp/requested_by; publish đúng topic; lưu deadline.
  - Cách kiểm tra: automated matrix cho từng user gate, attempt gọi automation entrypoint từ ngoài, internal ALARM_ON, concurrent domains và conflicting actions; inspect broker output.
  - Điều kiện được tick: chỉ user/internal request đủ điều kiện được publish, không có public auth bypass, mỗi request có command ID duy nhất và control pending đúng domain.

- [x] **[MUST]** Xây ACK processor, matching, timeout, duplicate/late ACK handling và reconciliation.
  - File/module dự kiến: ACK subflow, timeout scheduler, completed-command cache.
  - Kết quả phải đạt: match ID/locker/action/schema; cancel đúng timer; wrong/late ACK không báo success; timeout ghi event interface và GET_STATE một lần. Restart clear pending, không restore/replay command; ACK cũ sau restart không thể báo success.
  - Cách kiểm tra: automated valid ACK, wrong ID, wrong locker/state, duplicate, late ACK, no ACK; restart với command pending rồi feed ACK cũ và kiểm tra GET_STATE/state reconciliation.
  - Điều kiện được tick: Dashboard chỉ success sau valid ACK của pending runtime hiện tại; restart không resurrect request; không auto-retry actuator; timeout/reconcile có evidence.

- [ ] **[MUST]** Hoàn thiện CB1 Dashboard và shared disabled-control behavior.
  - File/module dự kiến: FlowFuse Dashboard state widgets, connection/door view, UI state adapter.
  - Kết quả phải đạt: hiển thị ESP32/MQTT riêng, door OPEN/CLOSED/UNKNOWN và update time; lock UNKNOWN có nhãn chưa xác nhận; control disable đúng sáu điều kiện Section 4, bao gồm recovery sau Node-RED restart.
  - Cách kiểm tra: MANUAL desktop/mobile và automated state-model inputs khi khả thi.
  - Điều kiện được tick: UI không hiển thị stale data như live, không success trước ACK và CB1 end-to-end có evidence.

- [x] **[MUST]** Triển khai one-time unlock authorization và unauthorized-open detector của YC6.
  - File/module dự kiến: security detector subflow, per-locker command correlation/episode state, test fixtures.
  - Kết quả phải đạt: một ACK `UNLOCK` khi `CLOSED` cho đúng một OPEN `authorized=true`; close/expiry tự khóa ở firmware; OPEN sau không có grant mới tạo `authorized=false`; firmware decision sống qua backend restart; duplicate/replay không phát side effect lặp.
  - Cách kiểm tra: automated timeline gồm current producer auto-lock và fixture tương thích producer cũ có first/second OPEN khi vẫn `UNLOCKED`, re-arm bằng same-state `UNLOCK`, expiry, firmware/backend restart, `LOCKED`/`UNKNOWN`, duplicate telemetry và replay `event_id`.
  - Điều kiện được tick: classification deterministic theo Section 4 và không có repeated alert trong cùng door-open episode.

- [x] **[MUST]** Phát `UNAUTHORIZED_OPEN` interface và `ALARM_ON` request mà không nhận ownership CB3/YC4.
  - File/module dự kiến: event emitter/dispatcher adapter, `docs/event-contract.md`.
  - Kết quả phải đạt: event đủ source/result/authorized/state/time; alarm đi qua cùng dispatcher/pending/ACK contract; có hook cho Phase 3.
  - Cách kiểm tra: automated contract consumer/harness xác nhận event và command output; không tuyên bố buzzer/persistence thật.
  - Điều kiện được tick: interface có contract/fixture evidence và Phase 2 ghi rõ CB3/YC4 integration vẫn pending Phase 3.

- [ ] **[MUST]** Triển khai Telegram notification, dedupe/rate-limit và failure handling cho YC6.
  - File/module dự kiến: Telegram subflow, notification status adapter, settings lookup interface.
  - Kết quả phải đạt: message có locker code, local display time, door/lock state, Dashboard link; token không log; lỗi không làm crash detector.
  - Cách kiểm tra: MANUAL bot thật cho success/invalid token/network failure; automated duplicate episode/rate-limit tests.
  - Điều kiện được tick: một cảnh báo/episode theo policy, delivery status hiện rõ, failure có evidence và không làm mất normalized event.

- [x] **[MUST]** Triển khai YC8 classifier, live-state/history routing và Gemini grounding.
  - File/module dự kiến: chatbot subflows, history adapter, prompt/context builder, `docs/chatbot-grounding.md`.
  - Kết quả phải đạt: câu live lấy cache; câu history dùng adapter Supabase; Node-RED tính facts/counts; context không có JWT/secret; Gemini chỉ diễn đạt.
  - Cách kiểm tra: automated route/context snapshots, verify Node-RED facts/counts xuất hiện đúng trong structured context, missing-data/provider-error fixtures; MANUAL Gemini live credential. Numeric-token validator tinh vi chỉ là `OPTIONAL`.
  - Điều kiện được tick: live query thật đạt; history adapter contract đạt; no-data/failure trả lời kiểm soát; prompt buộc Gemini chỉ diễn đạt facts, không tự tạo số liệu. Không cần blocker là một validator phức tạp.

- [x] **[MUST]** Hoàn thiện Phase 2 documentation, regression và handoff Phase 3.
  - File/module dự kiến: Node-RED/Supabase/dashboard docs, test evidence/index, `PLAN.md`.
  - Kết quả phải đạt: Thùy có thể nối buzzer, event persistence, chart/email/final Dashboard mà không sửa ngầm contract.
  - Cách kiểm tra: tái tạo key tests khi khả thi, final diff/secret/generated-flow audit và Phase 1 regression.
  - Điều kiện được tick: acceptance/evidence đạt; pending MANUAL/Phase 3 dependencies được liệt kê trung thực.

### Tests

| Test ID | Kịch bản | Bước thực hiện | Kết quả mong đợi | Loại | Evidence cần lưu |
|---|---|---|---|---|---|
| P2-A01 | Door debounce timeline | Feed bounce sequences quanh threshold | Một stable transition, không event giả; boundary xác định | Automated | Test report + input timeline |
| P2-S01 | Device simulator contract matrix | Chạy harness với broker cho availability/state/door telemetry, command/ACK success/error/duplicate/delay/no-ACK/malformed và reconnect | Node-RED/consumer xử lý frozen contract đúng; output không được gọi là MC-38/ESP32 hardware evidence | SOFTWARE-GATE — broker/simulator integration | Harness fixture + broker/test-runner output |
| P2-M01 | MC-38 OPEN/CLOSED | Khi có hardware: tác động reed switch/nam châm thật; dùng subscriber mới kiểm tra telemetry sau transition | Stable electrical states ánh xạ đúng; telemetry door non-retained nên subscriber mới không nhận lại old transition; cache và Dashboard đúng state/time | DEFERRED — HARDWARE-FINAL-GATE | Video + broker/Dashboard capture |
| P2-M02 | MC-38 debounce và UNKNOWN khả thi | Khi có hardware: toggle nhanh; boot trước stable sample; tạo Offline/stale hoặc inject invalid/missing state payload | Debounce lọc bounce; OPEN/CLOSED từ input ổn định; cache/Dashboard dùng UNKNOWN khi live state không đáng tin | DEFERRED — HARDWARE-FINAL-GATE | Video/log + cache/UI capture; ghi rõ không test broken-wire detection |
| P2-A02 | Invalid MQTT payload | Inject malformed JSON/schema/enum/locker | Reject; cache/UI/event interface không đổi | Automated | Flow test output |
| P2-A03 | Auth transport/ownership command gates | Gửi canonical Bearer token valid/missing/malformed/expired, spoof `user_id`, wrong owner, provider transport/5xx/malformed response, offline và MQTT down | Node-RED dùng verified token identity; chỉ invalid session trả 401, owner deny 403, provider failure 503; claim RPC chuẩn hóa đúng một row; không publish khi deny | Automated | Request fixtures + broker spy + redacted log assertion |
| P2-M03 | Register/login/logout/session + FlowFuse transport | Dùng Supabase test account thật; inspect request protected từ Dashboard qua login/refresh/logout | Browser session và frozen token transport đúng tài liệu; logout/expiry disable control; full JWT không log | MANUAL — HARD-GATE | Screen/network capture đã redact PII/token |
| P2-M04 | User A đọc/điều khiển Locker B | Hai account/locker thật, thử UI và API trực tiếp | RLS/read deny; command gate deny; MQTT không có command | MANUAL — HARD-GATE | Sanitized request/result + broker capture |
| P2-M05 | Locker one-time/double claim | Claim locker chưa có owner, sau đó claim lại cùng code bằng user khác | Chỉ owner đầu tiên thành công; owner ID không sửa từ client | MANUAL — HARD-GATE | Sanitized DB/API evidence |
| P2-A04 | Command dispatcher valid | Request hợp lệ với live device | UUID sinh server-side; pending lưu; payload đủ năm field | Automated | Captured command + assertions |
| P2-A05 | Pending conflict | Gửi LOCK và UNLOCK cùng locker/domain khi pending | Command sau bị reject/disabled; domain khác theo policy không bị sai | Automated | Flow test output |
| P2-A06 | Valid ACK | Feed ACK khớp pending | Timer cancel; state/cache/UI success; event output đúng | Automated | ACK fixture + result snapshot |
| P2-A07 | ACK + Node-RED restart/reconnect recovery | Feed wrong/duplicate/late ACK; restart khi pending; disconnect/reconnect; feed Node-RED 4.1.13 status token, MQTT/availability/full-state recovery | Restart/disconnect clear hoặc fail pending; ACK cũ không resurrect; reconnect phát một GET_STATE bootstrap; chỉ fresh state generation mới re-enable | Automated | Exported Function + flow/state-gate assertions |
| P2-A08 | Timeout | Không feed ACK đến hết deadline | Timeout; không auto-retry actuator; GET_STATE một lần; UI error | Automated | Virtual-clock/timestamped output |
| P2-A09 | One-time unlock + restart | ACK `UNLOCK` khi `CLOSED`; producer hiện tại auto-lock sau close, đồng thời giữ fixture legacy OPEN → CLOSED → OPEN; restart backend trước một firmware edge `authorized=true` | OPEN đầu authorized; OPEN sau không grant là unauthorized; explicit firmware decision vẫn đúng sau restart; legacy producer vẫn tương thích | Automated | Timeline + normalized events + firmware-decision assertions |
| P2-A10 | Unauthorized OPEN | OPEN không có grant hợp lệ: second open, expired/revoked grant, `LOCKED` hoặc `UNKNOWN` | `authorized=false`; một `UNAUTHORIZED_OPEN`; local alarm và bounded ALARM_ON request | Automated | Event + command capture |
| P2-A11 | Alert duplicate/rate-limit/bounded state | Replay same sequence/keep OPEN và feed quá giới hạn buffer/map | Không tạo Telegram/alarm request lặp trong episode; runtime/Telegram collections không tăng vô hạn; delivery status có contract/UI | Automated | Invocation counts + bound/status assertions |
| P2-M06 | Telegram thành công | Owner bấm **Liên kết Telegram**, Start private bot, gửi test rồi gây unauthorized event an toàn | Link một lần thành công; một message đúng locker/time/states/link | MANUAL — FINAL-GATE | Screenshot đã che provider ID nếu cần + delivery log |
| P2-M07 | Telegram thất bại | Dùng controlled invalid credential/network case | Detector/event vẫn hoạt động; status failure rõ; không crash/retry vô hạn | MANUAL — FINAL-GATE | Sanitized error/status log |
| P2-A12 | Chatbot canonical/live/missing/error route | Feed đủ sáu câu acceptance, live cache, empty cache, provider error | Intent/route và safe canonical question đúng; structured facts đúng; no-data/error deterministic; raw trailing secret không vào context | Automated | Context snapshots không secret |
| P2-A13 | Chatbot history contract | Feed history response, unavailable và thrown transport failure | Structured context chứa đúng question/intent/facts/counts; failure controlled; instruction không cho model tự tính hoặc tạo số | Automated | Adapter fixture + deterministic context assertions |
| P2-M08 | Gemini live API | Hỏi state thật qua Dashboard | Câu trả lời bám cache; không lộ token/JWT; failure UI kiểm soát | MANUAL — FINAL-GATE | Sanitized UI/API evidence |

### Acceptance Criteria

Mọi mục trong phần này là `MUST`. External-service `FINAL-GATE` có thể còn `Pending` khi Phase 2 handoff nếu credential/dependency thật chưa sẵn sàng, nhưng implementation/contract test tương ứng phải đạt và test thật bắt buộc hoàn tất trước final release. `SHOULD`/`OPTIONAL` không block acceptance.

- [x] Phase 1 regression còn đạt và shared contract không bị đổi một phía.
- [x] **[SOFTWARE-GATE]** Device simulator/broker matrix chứng minh CB1 telemetry OPEN/CLOSED/UNKNOWN, retained/non-retained, reconnect và consumer handling theo frozen contract; không gọi đây là MC-38/ESP32 evidence.
- [ ] **[DEFERRED — HARDWARE-FINAL-GATE]** CB1 đọc/debounce/publish OPEN/CLOSED với MC-38/ESP32 thật; UNKNOWN dùng đúng cho boot/uninitialized/Offline/stale/invalid state, không tuyên bố phát hiện dây đứt ngoài khả năng phần cứng.
- [x] Node-RED validate mọi MQTT ingress trước cache/UI/event side effect.
- [x] YC9 register/login/logout/session/JWT, frozen Supabase access-token transport, ownership/claim và RLS hoạt động với hai user; verified token là nguồn user ID duy nhất; service-role key không ở frontend.
- [x] Command dispatcher kiểm tra auth/ownership cho user request; internal YC6 entrypoint không public, allowlisted/audited; cả hai kiểm tra MQTT, device freshness và pending conflict trước publish.
- [x] ACK matching, wrong ID, timeout, duplicate/late ACK và GET_STATE reconciliation đạt; exported flow nhận đúng status Node-RED 4.1.13; disconnect fail pending, reconnect bootstrap một GET_STATE; restart clear pending/cache freshness và ACK cũ không tạo success.
- [x] Mỗi ACK `UNLOCK` khi cửa đóng cho đúng một OPEN; đóng lại hoặc hết hạn tự khóa; mở/ép lại không re-arm và phát unauthorized một lần/episode; explicit firmware decision không lệch sau backend restart.
- [x] YC6 phát đúng `UNAUTHORIZED_OPEN` và `ALARM_ON` interface; Telegram adapter, payload, bounded dedupe/rate-limit, visible delivery status và controlled failure có automated/integration evidence. P2-M06/P2-M07 với dịch vụ thật đã PASS.
- [x] Tài liệu nói rõ actual buzzer CB3 và Supabase persistence YC4 chưa được Phase 2 tuyên bố hoàn tất.
- [x] YC8 nhận đủ sáu câu acceptance; live route, history adapter contract, safe canonical question/intent, structured context do Node-RED tính facts, no-data/history transport failure và controlled Gemini failure đạt; model được giới hạn ở diễn đạt dữ liệu. P2-M08 dùng Gemini thật đã PASS.
- [x] Event/history/alarm interfaces có contract/fixture/documentation đủ để Phase 3 bắt đầu mà không đổi interface ngầm.
- [x] Không có secret, production mock data, token/JWT trong log/evidence hoặc implementation result giả.

### Git Checklist

- [x] **Terra/owner:** Pull `develop` mới nhất bằng fast-forward-only; xác minh Phase 1 `COMPLETED`, Phase 2 `ACTIVE` và P1 hardware final gates vẫn deferred.
- [x] **Terra/owner:** Xác nhận owner Nguyễn Văn Minh và switch/tạo `phase/2-minh-security-orchestration` từ `develop`.
- [x] **Terra/owner:** Build/test phù hợp đã chạy; firmware regression + Node-RED/Auth/RLS/dispatcher/YC6/YC8 contract tests được ghi đúng.
- [x] **Terra/owner:** Manual service/account gates có environment sẵn sàng đã có sanitized live evidence: P2-M03 custom-SMTP signup/session/logout/Bearer 12/12 và P2-M04–P2-M08 đều PASS. MC-38/ESP32 tests thiếu hardware giữ `[ ] DEFERRED — HARDWARE-FINAL-GATE`; không giả PASS.
- [x] **Terra/owner:** Chạy final diff/source/secret/generated-flow audit; không nhận ownership CB3/YC4 và không đổi frozen contract thiếu version/evidence.
- [x] **Terra/owner:** Cập nhật `PLAN.md`, commit thay đổi thuộc Phase và ghi hash thật `5eef94b` vào Phase Completion Summary.
- [x] **Terra/owner:** Push Phase branch lên GitHub; `origin/phase/2-minh-security-orchestration` đã được push tại `478864e`.
- [x] **Terra/owner:** SOFTWARE-GATE `PASS`; Phase branch đã được fast-forward merge vào `develop` và `origin/develop` đã được push tại `478864e`, không merge commit, rewrite history hoặc force push.
- [x] **Terra/owner:** Sau integration push thành công, chuyển Phase 2 `ACTIVE → COMPLETED` và Phase 3 `NOT_STARTED → ACTIVE`.
- [x] **Terra/owner:** Đã tạo và push `phase/3-thuy-data-integration` từ lifecycle commit `a05ca06` trên `develop`; remote ref được xác minh trước khi ghi nhận.
- [x] **Terra/owner:** Xác nhận Phase 1/2 hardware final gates vẫn `[ ]` và nằm trong Final Release checklist.

### Handoff

- Người nhận tiếp theo: **Mai Phương Thùy — 24127249**.
- Phase tiếp theo: **Phase 3 — CB3, YC4, YC5, YC7 và final integration**.
- Contract phải đọc: MQTT v1; normalized event; alarm request/ACK; Supabase Auth Transport + ownership; Node-RED restart recovery; state cache; history adapter; timezone/counting; Telegram status.
- Những phần đã hoàn thành: implementation/evidence software đã có cho CB1 contract/debounce, secure dispatcher/cache/ACK/timeout/restart, YC9 schema/auth middleware/Dashboard và custom-SMTP signup/session gate, YC6 Telegram success/failure/restore, YC8 grounded Gemini success/failure/restore, cùng P2-M03–P2-M08 trên deployment thật.
- Những phần còn MANUAL: automatic Telegram private-account linking được bổ sung trong lần tích hợp Phase 3; current Dashboard/artifact, secret/webhook, private **Start**, sanitized connected status và test-message subset đã PASS trên deployment ngày 2026-08-11, còn preference save/re-enable, consumed-token replay và disconnect/relink chưa chạy nên gate vẫn unticked. Gate này không mở lại lifecycle Phase 2 nhưng vẫn chặn final release. Actual CB3 buzzer, full load/final demo và Phase 1/2 hardware final gates vẫn deferred.
- Dependency được mở khóa: door telemetry; secure dispatcher; pending/ACK/timeout; cache; auth/RLS; unauthorized event + ALARM_ON; Telegram; chatbot context adapter.
- Dependency Phase 3 phải hoàn thiện: CB3 firmware/hardware, event schema/persistence, history query thật, YC6 full integration, YC5, YC7, final Dashboard/docs/regression.
- SOFTWARE-GATE, commit/push Phase branch và fast-forward integration vào `develop` đã hoàn tất. `phase/3-thuy-data-integration` đã được tạo/push từ lifecycle commit `a05ca06`; bàn giao lifecycle hoàn tất mà không triển khai functionality Phase 3 trong phiên chuyển giao này.
- Hardware final gates của Phase 1/2 vẫn pending và không đổi owner YC6/YC8 sang Thùy.

### Phase Completion Summary

- Status: COMPLETED — SOFTWARE-GATE, live service gates và Git integration đều PASS; P1/P2 hardware final gates vẫn deferred và tiếp tục block final release/demo.
- Implementation: Phase 2 software source hiện có cho CB1 debounce/telemetry; authenticated local TCP device simulator; modular Node-RED MQTT validation/live cache/dispatcher/ACK/timeout/restart/reconnect recovery; real Node-RED status-key handling + GET_STATE bootstrap; Supabase profiles/lockers/RLS/atomic claim migrations với explicit least-privilege Data API grants; full-name signup; canonical Bearer middleware với 401/503 và bounded provider timeout; normalized claim row; responsive Phase 2 Dashboard auth/claim/state/control/chat + Telegram delivery status, implicit-flow URL cleanup, local-first logout, bounded/serialized requests; bounded runtime/provider buffers; firmware-first one-time unlock authorization/unauthorized episodes; normalized event, `ALARM_ON`, notification và history contracts; đủ sáu YC8 canonical question với safe question/intent; Telegram/Gemini adapters. Actual CB3 và YC4/history backend production vẫn thuộc Phase 3.
- Automated tests at the immutable Phase 2 snapshot — PlatformIO native 14/14 at Phase 2 (the then-current combined firmware suite was 17/17); clean ESP32 build PASS via temporary ASCII drive alias (RAM 16,2%, Flash 84,2%); the then-current Node contract/artifact/Dashboard/export suite 145/145; P2-S01 memory fault matrix 14 scenario/8 assertion + authenticated local TCP MQTT broker/exported-status/Phase2Runtime 15 assertion; npm audit 0 vulnerability and secret/config audit 0 finding. These historical counts are intentionally not rewritten to the later correction-pass totals. Corrective regression bao phủ MQTT status/reconnect/bootstrap, pre-status retained-message generation, disconnect pending cancellation, auth outage/timeout/malformed/RPC normalization (kể cả response body bị treo), aggregate deadline/aborted-request suppression, bounded buffers, đủ sáu YC8 questions + context/history failure, Dashboard callback/logout/claim/poll/concurrency/late-401/locker-context/pending-generation/timeout behavior, semantic `hidden` cho logout/Telegram controls, blocked-popup fallback, private `/start`/`/help`/`/settings`, claim feedback không bị live-state poll ghi đè, automatic Telegram private-account link/retry/cross-account denial, byte-safe webhook secret và unknown-provider retry, pgTAP test envelope, public-signup real-domain template guard và deterministic cross-platform LF-canonical FlowFuse export. Evidence: `tests/evidence/phase-2/automated-results.md`.
- Manual HARD-GATE tests: **PASS**. P2-M03 custom-SMTP signup/user/profile/login/session/callback/reload/logout/PII/Bearer/cleanup đạt 12/12; P2-M04/P2-M05 đạt sanitized two-user UI/API/RLS/broker evidence và claim 200/409/409 + immutable owner evidence.
- Manual FINAL-GATE tests: P2-M06/P2-M07 Telegram **PASS** cho real delivery, controlled failure, `ALARM_ON`/ACK continuity và restore trên deployment pre-auto-link; automatic private-account link current-deployment subset **PASS** cho Dashboard/secret/webhook/private **Start**/sanitized status/test message nhưng preference replay/disconnect/relink vẫn Pending. P2-M08 Gemini **PASS** cho grounded live success, controlled provider failure, state preservation và restore. Evidence: `tests/evidence/phase-2/live-service-results.md` và `tests/test-plan.md`.
- Hardware final gates: P2-M01/P2-M02 `[ ] DEFERRED — HARDWARE-FINAL-GATE`; không có ESP32/MC-38, không tuyên bố GPIO/polarity/debounce/hardware verified. P1-M01–P1-M11 vẫn giữ nguyên deferred.
- Known issues: Playwright CLI 0.1.18 abort với libuv `UV_HANDLE_CLOSING` trên Node v24.14.1 nên live UI evidence dùng Chrome DevTools fallback. Xtensa Windows toolchain không xử lý ổn định đường dẫn workspace tiếng Việt nên clean ESP32 build dùng temporary ASCII `Z:` alias rồi xóa alias. Node-RED runtime phải do FlowFuse cung cấp ở phiên bản `>=4.1.13 <5`; project không vendor runtime/palette-manager npm thừa. Không có Critical/High dependency advisory trong dependency tree đã cài của project.
- Deferred SHOULD/OPTIONAL items: MQTT ACL nâng cao; `boot_id`/sequence; persistent/distributed cache; numeric-output validator nâng cao. Không mục nào thay thế MUST.
- Branch: `phase/2-minh-security-orchestration`; accepted implementation/evidence commit `5eef94b`; final Phase 2 documentation commit `478864e`; remote Phase branch verified at `478864e`.
- Commits: `d7e1c95` — Phase 2 implementation; `9cea590` — implementation evidence; `10ceb08` — corrective review fixes; `43f2efc` — review documentation; `5eef94b` — complete secure orchestration acceptance; `478864e` — record Phase 2 acceptance commit; `967530d` — canonicalize generated FlowFuse export line endings across Git platforms.
- Integration into `develop`: Phase 2 was fast-forwarded and pushed to `origin/develop` at `478864e`; the lifecycle transition was then committed/pushed at `a05ca06`. No merge commit, history rewrite or force push was used.
- Next phase at this historical Phase 2 handoff: Phase 3 was `ACTIVE` on `phase/3-thuy-data-integration`, created and pushed from lifecycle commit `a05ca06`; Phase 3 has since completed and been integrated into `develop`.

## 7. Phase 3 — Mai Phương Thùy

### Phase Goal

**Status: COMPLETED. Owner: Mai Phương Thùy — 24127249.**

Phase này đã được kích hoạt sau khi Phase 2 `COMPLETED`, rồi hoàn tất và được tích hợp/push trên `develop`; Phase 1/2 hardware final gates vẫn deferred. Phase đã triển khai CB3, YC4, YC5, YC7; nối actual buzzer và Supabase persistence vào YC6; nối history thật vào YC8; hoàn thiện Dashboard, full-system integration, regression và tài liệu software. Demo/release vẫn chờ các final gate có evidence thật. Ownership YC6/YC8 vẫn thuộc Minh.

### Minimum Required Completion Path

Để Phase 3 chuyển từ `ACTIVE` sang `COMPLETED`, Terra phải hoàn tất mọi SOFTWARE-GATE `MUST` implementation: CB3 controller logic; YC4 schema/persistence/history/RLS; YC5 chart 7/30; YC7 settings/scheduler/report/dedupe; full YC6/YC8 integration adapters; final Dashboard; automated/contract/simulator tests cần thiết; non-hardware manual gates có environment sẵn sàng; evidence/code/docs; commit/push/`develop` integration. Board, buzzer, door, servo, LED, OLED/DHT, WiFiManager, nguồn/cơ khí/full-load và physical E2E còn thiếu hardware được giữ `DEFERRED — HARDWARE-FINAL-GATE`. Không làm `OPTIONAL` trước committed software scope; Phase 3 không có Phase 4 để đẩy core implementation sang.

MANUAL `FINAL-GATE`, Section 8 E2E, full-load và release tests có thể còn `Pending` khi Phase 3 software chuyển `COMPLETED` nếu được ghi trung thực trong Phase Completion Summary. Chúng không block project đạt `SOFTWARE_COMPLETE`, nhưng tuyệt đối block `FINAL_RELEASE_READY`, demo/release cho đến khi toàn bộ mandatory final tests và final acceptance đạt bằng evidence thật.

### Dependencies

- Phase 1, Phase 2 và Phase 3 software baselines đã `COMPLETED` trên `develop` với acceptance/evidence thực; project hiện là `SOFTWARE_COMPLETE`. Hardware final gates có thể còn deferred và vẫn phải được đóng trước release.
- MQTT/event/auth/history/time/counting contracts đã khóa ở Phase 2 với producer/consumer fixtures và documentation.
- Active Buzzer LOW-trigger/TMB12A05 theo revision đã chọn (`VCC→3V3`, `IN←4,7 kΩ←GPIO26`); active/current/boot/full-load implications vẫn phải được xác minh trong hardware-final workflow.
- Supabase project/schema YC9, Node-RED secure dispatcher/cache, test users/lockers.
- Telegram/Gmail/Gemini/MQTT/Supabase credentials cho MANUAL tests ở secret store; không commit.
- Dashboard endpoint và report recipients/test mailbox đã xác nhận.

### Deliverables

- CB3 Active Buzzer firmware/hardware, configurable polarity, `ALARM_ON/OFF`, ACK/full state và Dashboard **Bật còi/Tắt còi**.
- YC4 versioned event schema, RLS/indexes, Node-RED persistence pipeline, recent/history queries và explicit failure behavior.
- YC5 aggregation/chart 7/30 ngày, empty/loading/error state và timezone-correct boundaries.
- YC7 notification settings, scheduler, daily aggregation, Gmail delivery, delivery log và duplicate-send prevention.
- YC6 hoàn chỉnh: actual alarm ACK/state + persisted unauthorized event + Telegram/latest alert.
- YC8 history adapter nối Supabase thật và regression grounding.
- Final FlowFuse Dashboard cho auth, availability, all states/controls/pending/error/history/chart/chatbot/settings.
- Full test plan/results/evidence, user guide, deployment guide, troubleshooting, demo script và release checklist.

### Files and Directories to Create or Modify

| Đường dẫn | Nội dung dự kiến |
|---|---|
| `firmware/src/alarm_controller.*`, `firmware/src/main.cpp`, config/pin files | CB3 buzzer, polarity, state/ACK integration |
| `firmware/test/alarm_controller/` | Controller/dedupe/state tests khi không cần hardware |
| `supabase/migrations/` | Device events, notification settings/deliveries, indexes, RLS, query/RPC migrations |
| `supabase/tests/` | RLS, aggregation, dedupe/idempotency/timezone tests |
| `node-red/flows.json`, `node-red/README.md`, `node-red/test/` | Persistence/history/chart/email/final integration flows/tests |
| `dashboard/README.md`, `dashboard/assets/` | Final UI behavior/assets; không chứa mock production data |
| `hardware/pin-map.md`, `hardware/power-budget.md`, `HUONG_DAN_CHAY_HE_THONG.md`, `HUONG_DAN_TEST_END_TO_END.md` | Revision pin/nguồn và full-load/final acceptance sau lắp; các assembly guide lỗi thời đã xóa theo xác nhận của người dùng |
| `tests/test-plan.md`, `tests/test-cases.*`, `tests/evidence/phase-3/`, `tests/traceability.md` | System/security/reliability/regression evidence |
| `docs/database-design.md`, `docs/user-guide.md`, `docs/deployment-guide.md`, `docs/troubleshooting.md`, `docs/demo-script.md` | Tài liệu cuối |
| `README.md`, `PLAN.md` | Quick start/status/release evidence thực |

### Implementation Checklist

Các bullet CB3/board/power/cơ khí cần phần cứng thật vẫn là `MUST` cho final release, nhưng khi hardware chưa có chúng được theo dõi bằng deferred hardware-final tests và Section 9; chúng không chặn Phase 3 software handoff hoặc thay thế physical E2E.

- [x] **[MUST]** Re-audit handoff, contract và unresolved hardware/service questions trước khi chỉnh integration.
  - File/module dự kiến: `PLAN.md`, contract docs, risk/open-question log.
  - Kết quả phải đạt: Phase 3 biết rõ schema/topic/counting/timezone/pending semantics; không sửa interface âm thầm.
  - Cách kiểm tra: walkthrough dependency và chạy Phase 1/2 smoke/regression baseline.
  - Điều kiện được tick: dependency thật sẵn sàng, blocker được ghi, contract change nếu có được version hóa và có producer/consumer evidence.

- [ ] **[MUST]** Xác nhận Active Buzzer LOW-trigger ở revision `VCC→3V3`, `IN←4,7 kΩ←GPIO26` và power wiring an toàn.
  - File/module dự kiến: pin/config, wiring diagram, power guide.
  - Kết quả phải đạt: active-high/low cấu hình; safe default INACTIVE khi boot; GPIO không cấp dòng tải; common ground/protection đúng.
  - Cách kiểm tra: MANUAL đo logic/điện áp/dòng, boot/restart, disconnected control và buzzer duration an toàn.
  - Điều kiện được tick: không alarm ngoài ý muốn khi boot và hardware wiring/polarity/current evidence đầy đủ; giữ `[ ] DEFERRED — HARDWARE-FINAL-GATE` khi chưa có hardware.

- [ ] **[MUST]** Triển khai CB3 `ALARM_ON`/`ALARM_OFF`, non-blocking control, ACK và state.
  - File/module dự kiến: `alarm_controller.*`, command/state/ACK integration, tests.
  - Kết quả phải đạt: command hợp lệ điều khiển đúng; duplicate không toggle lại; invalid không actuation; full state phản ánh ACTIVE/INACTIVE.
  - Cách kiểm tra: automated controller/duplicate tests và MANUAL MQTT command/hardware.
  - Điều kiện được tick: CB3 firmware/hardware lặp lại ổn định, không treo/reset và ACK/state đúng contract.

- [ ] **[MUST]** Hoàn thiện Dashboard **Bật còi/Tắt còi** (`ALARM_ON/OFF`) qua secure dispatcher.
  - File/module dự kiến: FlowFuse control widgets/state adapter, existing dispatcher/ACK flows.
  - Kết quả phải đạt: control auth/ownership/online/pending gates; processing; success chỉ sau ACK; timeout/error rõ.
  - Cách kiểm tra: MANUAL valid/unauthorized/offline/timeout/duplicate scenarios và broker capture.
  - Điều kiện được tick: CB3 end-to-end đạt, không có Dashboard → MQTT direct path.

- [x] **[MUST]** Thiết kế và migrate YC4 event schema/index/idempotency/RLS.
  - File/module dự kiến: versioned Supabase migrations, database design, RLS tests.
  - Kết quả phải đạt: lưu đầy đủ event contract; event ID/unique rule chống insert trùng; indexes hỗ trợ locker/time/type query; RLS owner-only.
  - Cách kiểm tra: apply các migration có thứ tự trên dev sạch, schema diff, two-user RLS tests, duplicate insert và query thực tế. Migration framework/rollback automation/query-plan tuning nâng cao là `SHOULD/OPTIONAL`.
  - Điều kiện được tick: setup schema dev tái lập được bằng các script đơn giản, policy/contract tests đạt và không dùng production dump/secret.

- [x] **[MUST]** Xây Node-RED YC4 event persistence pipeline và failure handling.
  - File/module dự kiến: event persistence subflow, error/status output và tests; không cần dead-letter infrastructure.
  - Kết quả phải đạt: insert door/lock/alarm/LED/unauthorized/device/timeout events; idempotent theo event ID; lỗi được log/surface an toàn và không crash/loop. Bounded retry nhỏ cho transient error là `SHOULD`; dead-letter queue/service và retry framework nâng cao là `OPTIONAL`.
  - Cách kiểm tra: automated event matrix, duplicate, 4xx validation failure, 5xx/network failure và recovery; MANUAL Supabase thật.
  - Điều kiện được tick: success lưu đúng; failure không bị nuốt/loop vô hạn; UI/diagnostic phản ánh persistence health và evidence có thật.

- [x] **[MUST]** Hoàn thiện recent events và history query có ownership/RLS.
  - File/module dự kiến: Supabase query/RPC migration, Node-RED history subflow, Dashboard recent/history views.
  - Kết quả phải đạt: recent list newest-first có bounded display limit; filter locker/time/type; không cross-owner; empty/loading/error rõ. Các consumer cần tổng chính xác phải paginate, không được âm thầm dừng ở giới hạn Data API.
  - Cách kiểm tra: seeded test data qua test setup, User A/B, boundary timestamps, no-data và Supabase failure.
  - Điều kiện được tick: query trả đúng dữ liệu thật, UI không leak Locker B và test cleanup được kiểm soát.

- [ ] **[MUST]** Triển khai YC5 aggregation và chart 7/30 ngày theo counting/timezone contract.
  - File/module dự kiến: aggregation query/RPC, chart subflow/widgets, tests.
  - Kết quả phải đạt: DOOR_OPENED và UNAUTHORIZED_OPEN counts đúng; đủ bucket ngày kể cả zero; filter 7/30; local timezone boundaries.
  - Cách kiểm tra: deterministic dataset quanh midnight/UTC boundary, empty/multiple-event days, compare expected counts.
  - Điều kiện được tick: chart/query/chatbot/report dùng cùng counting utility/contract và 7/30 MANUAL UI evidence đạt.

- [x] **[MUST]** Triển khai notification settings với ownership/RLS.
  - File/module dự kiến: settings table/policies, settings API/subflow, Dashboard settings.
  - Kết quả phải đạt: Telegram/email enable, automatic private-account link, email/report time/timezone được validate; chỉ owner thao tác; Chat/User ID và one-time token không lộ ra frontend.
  - Cách kiểm tra: User A/B, invalid time/timezone/address, session expiry và reload.
  - Điều kiện được tick: settings persist đúng, RLS deny cross-owner và UI không hiển thị credential backend.

- [x] **[MUST]** Triển khai YC7 scheduler, daily aggregation và email rendering.
  - File/module dự kiến: scheduler/report aggregator/email subflows, email template/docs.
  - Kết quả phải đạt: đúng report period local ngày trước; số lần mở/cảnh báo/latest activity từ data; email nêu khoảng thời gian/timezone.
  - Cách kiểm tra: virtual/injected schedule automated test với deterministic events và email transport adapter; selected SMTP test mailbox được theo dõi riêng ở P3-M06 `FINAL-GATE`.
  - Điều kiện được tick cho software completion: subject/body/recipient/counts, owner scope và controlled provider-failure path đạt bằng automated/integration evidence; deployed P3-M06 success/definite-failure evidence đã PASS qua Mailtrap Sandbox.

- [x] **[MUST]** Chống gửi email trùng và lưu delivery log idempotent.
  - File/module dự kiến: notification delivery migration, dedupe/scheduler subflow, tests.
  - Kết quả phải đạt: unique dedupe key đơn giản theo locker + local report date + channel; trigger lặp/restart chỉ tạo một send intent/success. Distributed scheduler coordination là `OPTIONAL`.
  - Cách kiểm tra: fire scheduler hai lần, restart Node-RED giữa các bước, provider success/failure và retry policy hữu hạn nếu có.
  - Điều kiện được tick: không gửi trùng, log status/time/error đúng và retry không biến lỗi permanent thành loop.

- [x] **[MUST]** Nối YC6 với actual buzzer và event persistence mà giữ Minh là owner YC6.
  - File/module dự kiến: unauthorized detector adapters, dispatcher, persistence, latest alert, Dashboard.
  - Kết quả phải đạt: unauthorized transition → one event → ALARM_ON → valid ACK/ACTIVE → Telegram/latest alert; persistence failure không ngăn cảnh báo vật lý.
  - Cách kiểm tra: deterministic/injected integration cho buzzer ACK/timeout, Telegram/Supabase success/failure và dedupe episode; MANUAL full scenario P3-M07/P3-M08 là `FINAL-GATE`.
  - Điều kiện được tick cho software completion: adapters/wiring logic và automated/integration matrix có evidence, `authorized=false` mapping đúng, không duplicate alarm/alert; P3-M07/P3-M08 có thể còn `Pending` nhưng block `FINAL_RELEASE_READY`.

- [x] **[MUST]** Nối YC8 history adapter vào Supabase thật và regression grounding.
  - File/module dự kiến: history adapter, chatbot tests, Dashboard chatbot.
  - Kết quả phải đạt: live từ cache, history/counts từ query; context có provenance/time range; Gemini không nhận secret/JWT hoặc tự tính facts.
  - Cách kiểm tra: automated assertions cho query result, structured facts/provenance/time range, prompt boundary, no-data/provider error; MANUAL live Gemini P3-M09 là `FINAL-GATE`. Sophisticated numeric validator là `OPTIONAL`.
  - Điều kiện được tick cho software completion: history query/context/owner filter và deterministic no-data/error behavior đạt; P3-M09 có thể còn `Pending` nhưng block `FINAL_RELEASE_READY`; không cần output-validation framework phức tạp.

- [x] **[MUST]** Hoàn thiện toàn bộ FlowFuse Dashboard và responsive/interaction states.
  - File/module dự kiến: all Dashboard tabs/widgets, dashboard docs/assets.
  - Kết quả phải đạt: Online/Offline, OPEN/CLOSED/UNKNOWN, LOCKED/UNLOCKED, ACTIVE/INACTIVE, LED ON/OFF, pending/timeout/error, recent/history/chart/chatbot/settings.
  - Cách kiểm tra: state-model/integration checks cho auth expiry, wrong owner, broker/device offline và every control path; MANUAL desktop + phone P3-M10 là `FINAL-GATE`.
  - Điều kiện được tick cho software completion: UI bám wireframe/phạm vi, không có YC1 card/mock data, disabled controls đúng và accessibility cơ bản đủ dùng theo available checks; P3-M10 có thể còn `Pending` nhưng block `FINAL_RELEASE_READY`.

- [ ] **[MUST]** Hoàn thiện full-system test plan/harness, chạy SOFTWARE-GATE và quản lý DEFERRED HARDWARE-FINAL-GATE/FINAL-GATE execution.
  - File/module dự kiến: `tests/` plan/cases/evidence, defect log, firmware/flow regression.
  - Kết quả phải đạt để Phase 3 software `COMPLETED`: test plan/harness hoàn chỉnh, SOFTWARE-GATE và non-hardware manual gate đạt, mọi hardware final gate/`FINAL-GATE` chưa chạy được liệt kê `Pending` với bước/evidence/blocker cụ thể. Trước `FINAL_RELEASE_READY`: toàn bộ Section 8/full-load/release tests đạt, Critical/High = 0; Medium có workaround/decision rõ.
  - Cách kiểm tra: trước software completion, audit SOFTWARE-GATE output và danh sách deferred hardware final gate/FINAL-GATE pending; trong hardware-final workflow, chạy test session với hardware/accounts thật, fault injection có kiểm soát và final evidence audit.
  - Điều kiện được tick cho software completion: plan/harness + SOFTWARE-GATE + pending record đầy đủ, không ghi giả. Các test row/acceptance hardware final/`FINAL-GATE` vẫn để unticked cho đến khi chạy thật và tiếp tục block `FINAL_RELEASE_READY`; defects được triage và affected regression rerun.

- [x] **[MUST]** Hoàn thiện user/deployment/troubleshooting/demo documents và release checklist.
  - File/module dự kiến: docs cuối, README, test traceability, `PLAN.md`.
  - Kết quả phải đạt: người khác deploy/use/demo/recover được; secret provisioning và backup/export được mô tả an toàn.
  - Cách kiểm tra: trước software completion, self-check docs với implementation và final diff; reproduction cùng rehearsal P3-M12 diễn ra ở hardware/`FINAL-GATE` workflow.
  - Điều kiện được tick cho software completion: docs/traceability/release checklist đã hoàn chỉnh, liên kết evidence hiện có và ghi rõ final evidence còn `Pending`; rehearsal không được ghi hoàn tất trước bằng chứng thật và vẫn block `FINAL_RELEASE_READY`.

### Tests

| Test ID | Kịch bản | Bước thực hiện | Kết quả mong đợi | Loại | Evidence cần lưu |
|---|---|---|---|---|---|
| P3-A01 | Alarm controller valid/duplicate/invalid | Feed ALARM_ON/OFF, duplicate ID, invalid action | State/ACK đúng; duplicate không actuation; invalid an toàn | Automated | Test report + ACK fixtures |
| P3-M01 | Buzzer active polarity/boot | Khi có hardware: boot/restart, bật/tắt qua command | Boot INACTIVE; ON/OFF đúng; không treo/reset | DEFERRED — HARDWARE-FINAL-GATE | Video + wiring/voltage note |
| P3-M02 | Dashboard **Bật còi/Tắt còi** | Software: test bằng simulator/broker; khi có hardware: login owner, thao tác control | Pending → ACK success → ACTIVE/INACTIVE; không direct MQTT; physical buzzer evidence còn deferred | DEFERRED — HARDWARE-FINAL-GATE | UI + broker + hardware video |
| P3-A02 | Event persistence matrix | Feed mọi canonical event type | Mapping đầy đủ; required fields; idempotent insert | Automated | DB assertions/test report |
| P3-M03 | Supabase insert thành công | Software: inject simulator fixtures; khi có hardware: chạy door/lock/alarm/LED/unauthorized thật | Rows đúng locker/source/result/authorized/command/time; physical producer evidence còn deferred | DEFERRED — HARDWARE-FINAL-GATE | Sanitized query export/screenshot |
| P3-A03 | Supabase duplicate/failure | Insert same event ID; inject 4xx/5xx/network | Một row; lỗi được surface, không crash/loop; retry transient hữu hạn nếu có | Automated | Invocation/row counts + error log |
| P3-M04 | RLS event history | User A/B query UI/API | A không đọc B; unauthenticated bị deny | MANUAL — HARD-GATE | Sanitized request/result |
| P3-A04 | Chart aggregation 7/30 | Deterministic events tại boundary/multiple/zero days | Đủ buckets, counts đúng contract | Automated | Dataset + expected/actual report |
| P3-M05 | Dashboard chart/empty/timezone | Chọn 7/30, no-data và local midnight data | UI/count/boundary/empty state đúng | MANUAL — HARD-GATE | Screenshots + source query |
| P3-A05 | Daily report aggregation | Feed previous-day data/timezone | Counts/latest/period đúng và owner-scoped | Automated | Rendered sanitized email + assertions |
| P3-M06 | SMTP send success/failure | Gửi test report rồi dùng controlled failure | Success log đúng; failure rõ; không crash/loop | MANUAL — FINAL-GATE PASS | Mailtrap Sandbox message + sanitized delivery log |
| P3-A06 | Duplicate email prevention | Trigger cùng locker/report date hai lần và qua restart | Chỉ một send; unique delivery key giữ idempotency | Automated | Send spy + DB delivery rows |
| P3-M07 | YC6 full success | LOCKED rồi tạo stable unauthorized OPEN | One event authorized=false; buzzer ACTIVE; Telegram; Dashboard alert | MANUAL — FINAL-GATE | Synchronized video/UI/broker/DB/Telegram evidence |
| P3-M08 | YC6 dependency failures | Lần lượt gây Supabase/Telegram/buzzer ACK failure an toàn | Các nhánh độc lập, lỗi rõ, không duplicate/infinite retry | MANUAL — FINAL-GATE | Failure matrix evidence |
| P3-M09 | YC8 live/history/no-data/error | Hỏi bốn loại câu với data thật | Grounded answer hoặc controlled no-data/error; no secret | MANUAL — FINAL-GATE | Sanitized question/context/source/answer |
| P3-M10 | Final Dashboard responsive/state gates | Desktop/phone; offline/expired/wrong owner/pending | State/controls/loading/error đúng toàn bộ | MANUAL — FINAL-GATE | Screen recording |
| P3-M11 | Full electrical load | Servo chuyển động + LED max allowed + buzzer ON + OLED/DHT + MQTT | Rail ổn định; ESP32 không reset; devices tiếp tục đúng | MANUAL — FINAL-GATE | Voltage/current + video + broker log |
| P3-M12 | Full demo regression | Chạy Section 11 từ đầu đến cuối | Mọi requirement demo được theo cùng build/deploy | MANUAL — FINAL-GATE | Timestamped rehearsal video + checklist |

### Acceptance Criteria

Mọi mục trong phần này là `MUST` cho final project acceptance. Để Phase 3 software thành `COMPLETED`, các phần implementation/automated/software-gate tương ứng phải đạt; các phần cần hardware/service thật giữ `[ ] DEFERRED — HARDWARE-FINAL-GATE` hoặc `Pending` đúng loại. Mọi `FINAL-GATE` phải có evidence thật trước `FINAL_RELEASE_READY`. `SHOULD`/`OPTIONAL` không block acceptance và phải được ghi rõ nếu defer.

- [ ] CB3 hardware/firmware/Dashboard **Bật còi/Tắt còi**, ACK/state/timeout đạt và safe boot INACTIVE.
- [ ] YC4 lưu đầy đủ door/lock/alarm/LED/unauthorized/source/result/authorized/command/time; idempotency và RLS đạt.
- [ ] Recent/history query đúng owner, có bounded limit/filter và empty/error behavior rõ; pagination đầy đủ là `SHOULD`, không block demo dataset.
- [ ] YC5 chart 7/30, zero buckets, counting rule và Asia/Ho_Chi_Minh boundary đạt.
- [ ] YC7 settings/schedule/aggregation/Gmail/delivery log/duplicate prevention đạt success và failure tests.
- [ ] YC6 actual buzzer + persistence + Telegram + latest alert hoạt động, không duplicate episode; Minh vẫn là owner.
- [ ] YC8 live/history thật, no-data/API error và grounded structured-context behavior đạt; Gemini không được tự tạo số liệu; Minh vẫn là owner.
- [ ] Final Dashboard có đủ states/controls/history/chart/chatbot/settings và disable đúng mọi gate.
- [ ] Full-load hardware không reset/mất MQTT; WiFi/MQTT/restart recovery regression đạt.
- [ ] Security tests unauthenticated/expired/User A–Locker B/RLS/secret scan đạt; Critical và High defect = 0.
- [ ] User/deployment/troubleshooting/demo/release docs khớp hệ thống thật; traceability 12 requirement đầy đủ.
- [ ] Không còn production mock data, debug secret, generated local credential, kết quả test giả hoặc requirement bị đánh dấu hoàn tất thiếu evidence.

### Git Checklist

- [x] **Terra/owner:** Pull `develop` mới nhất bằng fast-forward-only; xác minh Phase 2 `COMPLETED`, Phase 3 `ACTIVE` và prior hardware final gates vẫn deferred nếu chưa có hardware.
- [x] **Terra/owner:** Xác nhận owner Mai Phương Thùy và switch/tạo `phase/3-thuy-data-integration` từ `develop`.
- [x] **Terra/owner:** Build/test SOFTWARE-GATE phù hợp đã chạy: firmware, Node-RED, migrations/RLS, aggregation và regression; non-hardware manual gates có environment sẵn sàng có evidence thật.
- [x] **Terra/owner:** Physical tests chưa chạy được giữ `[ ] DEFERRED — HARDWARE-FINAL-GATE`; `FINAL-GATE` thiếu account/credential giữ `Pending`, không giả PASS và vẫn block `FINAL_RELEASE_READY`.
- [x] **Terra/owner:** Chạy final diff/source/secret/generated-flow/migration audit; không đổi owner YC6/YC8 hoặc frozen contract ngầm.
- [x] **Terra/owner:** Phase 3 source/docs/evidence được commit trên Phase branch tại `55138a`.
- [x] **Terra/owner:** `origin/phase/3-thuy-data-integration` đã được push tại `55138a`.
- [x] **Terra/owner:** Phase branch đã được merge vào `develop`; `origin/develop` hiện tại ở merge commit `f60928f`, không rewrite history hoặc force push.
- [x] **Terra/owner:** Sau integration push thành công, Phase 3 chuyển `ACTIVE → COMPLETED` và project chuyển sang `SOFTWARE_COMPLETE`.
- [x] **Terra/owner:** Không đặt `FINAL_RELEASE_READY`; toàn bộ hardware-final/`FINAL-GATE` vẫn `[ ]`/`Pending` cho workflow sau software.

### Handoff

- Người nhận tiếp theo: **Cả nhóm thực hiện hardware integration**.
- Phase tiếp theo: **Không có Phase 4; sau Phase 3 `COMPLETED`, project là `SOFTWARE_COMPLETE`**.
- Contract phải đọc: architecture/MQTT/event/auth/database/time/counting/deployment docs đã khóa và traceability matrix.
- Những phần đã hoàn thành: Phase 3 source, migration, owner-scoped history, automated gates, deterministic FlowFuse export và responsive Dashboard đã có evidence; khi software handoff phải liệt kê commit/deployment version có thật, không suy từ working tree.
- Những phần còn MANUAL: phân biệt SOFTWARE-GATE, `DEFERRED — HARDWARE-FINAL-GATE` và `FINAL-GATE`; ghi rõ mọi credential/hardware/demo rehearsal chưa chạy; Phase 3 vẫn có thể `COMPLETED` ở software level nhưng project chưa release-ready.
- Dependency được mở khóa: `HARDWARE_INTEGRATION`, sau đó `HARDWARE_VERIFICATION`, `FULL_E2E` và cuối cùng `FINAL_RELEASE_READY`.
- Release record: chỉ ghi tag/version, commit, deployment URL và evidence link sau khi chúng tồn tại; không tạo giá trị giả.
- Khi `MUST` SOFTWARE-GATE implementation + automated/contract/simulator evidence + code/docs đầy đủ, commit/push Phase branch, fast-forward merge/push `develop`, đặt Phase 3 `COMPLETED`, project `SOFTWARE_COMPLETE` và dừng.
- Chỉ sau toàn bộ hardware-final/`FINAL-GATE` và final acceptance có evidence thật mới đặt project `FINAL_RELEASE_READY`. Không có Phase 4.

### Phase Completion Summary

- Status: COMPLETED — Phase 3 source, SOFTWARE-GATE, commit/push and `develop` integration are complete. The development forward migration plus P3-M04/P3-M05 hard gates pass. The automatic Telegram-link Dashboard/secret/webhook/private-Start/sanitized-status/test-message subset passes on the current deployment; preference replay/disconnect/relink and the remaining final gates are still pending and continue to block `FINAL_RELEASE_READY`.
- Implementation: CB3 controller/ACK/state with backward-compatible polarity config; YC4 migration/RLS/idempotent persistence and paginated history consumers; YC5 timezone aggregation/chart with accessible zero buckets; YC7 SMTP state machine with configuration preflight, atomic reservation, bounded retry and ambiguous-outcome protection; YC6/YC8 adapters; YC12 validated fresh Wi-Fi state and local-only captive-portal guidance; independently resilient history/chart panels; warm, responsive owner-facing Dashboard; current deployment/user/troubleshooting/evidence docs.
- Final auto-lock correction pass on 2026-08-18: Node 177/177 PASS; simulator 28 assertions/22 scenarios PASS; authenticated loopback broker's latest relevant result remains 18 assertions; config/secret audit 0 findings and npm production audit 0 vulnerabilities remain unchanged-path results from the same audit day. PlatformIO native 28/28 PASS; clean `esp32dev` build PASS at 53,580 RAM bytes (16.4%) and 1,108,145 flash bytes (84.5%); the 32-file Arduino mirror and isolated profile PASS at 53,608 RAM/1,112,269 flash. The earlier GUI-equivalent Arduino result predates auto-lock and was not rerun. Clean Wokwi build PASS at 22,440 RAM/322,729 flash. Deterministic FlowFuse SHA-256 is `c154c9fbd41041667678c04bfc62e0181a87c9601c35d6606d4c801e84af1d37` (266,041 bytes, 81 nodes, 7 tabs, 15 method-specific HTTP routes, no credential object). Chrome/CDP QA passes 18 checks at 1280×720 desktop and exact 320×800 mobile, including auto-lock wording/action gates, auth privacy, chart/table, keyboard focus, effective targets, reduced motion, polling cadence and classic-scrollbar reflow without horizontal overflow. `playwright-cli 0.1.18` remains `UNAVAILABLE` on Node v24.14.1 because wrapper and direct invocation both hit upstream `UV_HANDLE_CLOSING`; no CLI PASS is claimed. Software/compile results still do not imply hardware evidence.
- Manual HARD-GATE tests: P3-M04 PASS on the development project. P3-M05 PASS for deployed 7/30-day owner views, empty buckets and controlled `Asia/Ho_Chi_Minh` local-midnight data with cleanup.
- Manual FINAL-GATE tests remaining: P3-M01–P3-M03 and P3-M07–P3-M12 remain Pending; P3-M06 deployed SMTP success/definite-failure PASS is recorded, but no buzzer hardware or final physical E2E evidence is claimed.
- Known issues: the completed audits reproduced and fixed the ESP32Servo channel-zero initialization bug, bounded-data response-body/error normalization, late auth expiry handling, same-domain Dashboard request locking, stale/raw UI states, locker-timezone drift across history/chart/YC8 context, browser deadlines that were too short for database-backed views, the visible-but-unissued Telegram fallback button, missing private bot-command guidance, duplicate aggregation caused by overlapping offset pages, quiet-device liveness after 30 seconds, future-skew validation, ACK anomaly routing, publish-failure visibility, Dashboard startup/status/spinner/auth-mode behavior, Wokwi angle/help and remote-MQTT secure defaults. No remaining reproducible software defect is known in the automated scope. QoS0 ambiguity and open-loop SG90 feedback are explicit limits; the unexecuted manual gates above remain release risks, not PASS. Local Supabase CLI/`psql`/Docker were unavailable, so the live database evidence comes from the separately recorded development-project run. No physical result is inferred from the simulator or ESP32 compile.
- Deferred SHOULD/OPTIONAL items: advanced retry/dead-letter infrastructure, distributed scheduler coordination and query-plan tuning.
- Branch: `develop`; accepted Phase 3 implementation/evidence commit `55138a` remains at `origin/phase/3-thuy-data-integration`.
- Commit: `f60928f` — current pushed `origin/develop` integration baseline; the later local audit fixes are not yet committed or pushed.
- Integration into `develop`: completed and pushed at merge commit `f60928f`; no history rewrite or force push was used.
- Project state after completion: `SOFTWARE_COMPLETE`; hardware workflow follows.

## 8. End-to-End Test Checklist

Quy tắc dùng bảng:

- Mỗi dòng chỉ được tick sau khi chạy đúng build/deployment được ghi, expected result đạt và evidence có thể truy vết.
- `Automated` phải có command/test runner output thật. `MANUAL` phải có bước, người chạy, thời gian, cấu hình và ảnh/video/log đã che secret.
- Hardware hoặc account/service thật luôn là `MANUAL`, dù có script hỗ trợ.
- Mọi test có phần `MANUAL` trong Section 8 là `FINAL-GATE`: có thể được ghi pending rõ ràng khi Phase 3 software `COMPLETED` nếu môi trường thật chưa sẵn sàng, nhưng toàn bộ phải pass trước `FINAL_RELEASE_READY`.
- Không đổi expected result để hợp thức hóa behavior lỗi. Defect phải được ghi riêng và regression test lại sau fix.

| Test ID | Kịch bản | Bước thực hiện | Kết quả mong đợi | Loại | Evidence cần lưu |
|---|---|---|---|---|---|
| [ ] E2E-01 | Door CLOSED | Khởi động hệ thống; đưa nam châm MC-38 vào vị trí cửa đóng; chờ hết debounce | Firmware/state/telemetry và Dashboard hiển thị `CLOSED` với update time đúng | MANUAL — FINAL-GATE | Video phần cứng + broker + Dashboard cùng timestamp |
| [ ] E2E-02 | Door OPEN | Từ CLOSED, tách nam châm/cửa thật | Chỉ một stable transition `OPEN`; recent event đúng | MANUAL — FINAL-GATE | Video + telemetry/event evidence |
| [ ] E2E-03 | Door debounce | Rung/toggle MC-38 nhanh quanh ngưỡng nhiều lần | Không flood telemetry/event/cảnh báo; chỉ stable state được publish | MANUAL — FINAL-GATE | Slow-motion/video + message count |
| [ ] E2E-04 | Door UNKNOWN | Quan sát boot trước stable sample; tạo device Offline/cache stale; inject state payload thiếu/không hợp lệ | Cache/Dashboard dùng `UNKNOWN` khi live state không đáng tin; không suy từ retained data và không tuyên bố tháo dây là broken-wire detection | MANUAL — FINAL-GATE | Boot/LWT/cache/UI capture + scope note về supervised circuit |
| [ ] E2E-05 | Servo UNLOCK | Owner login; device online; nhấn Unlock | Pending; một command; servo mở; valid ACK; UI `UNLOCKED` | MANUAL — FINAL-GATE | UI/broker/servo video + ACK |
| [ ] E2E-06 | Servo LOCK và cơ khí | Đóng cửa đúng; nhấn Lock; lặp nhiều vòng có tải | Chốt khóa đúng, không kẹt/quá góc/reset; ACK `LOCKED` | MANUAL — FINAL-GATE | Video + angle/current/defect note |
| [ ] E2E-07 | Buzzer ON/OFF | Nhấn **Bật còi** rồi **Tắt còi** | `ALARM_ON/OFF` qua Node-RED; buzzer/ACK/UI `ACTIVE/INACTIVE` đúng | MANUAL — FINAL-GATE | Hardware/UI/broker video |
| [ ] E2E-08 | LED ON/OFF | Nhấn/toggle LED On rồi Off | WS2812B, ACK và Dashboard `ON/OFF` đúng; không reset | MANUAL — FINAL-GATE | Video + state/ACK capture |
| [ ] E2E-09 | DHT22 thành công | Chạy nhiều chu kỳ với sensor thật | Giá trị hợp lý cập nhật trên OLED, không có card/telemetry Dashboard YC1 | MANUAL — FINAL-GATE | OLED photo/video + topic inventory |
| [ ] E2E-10 | DHT22 lỗi | Tháo/gây lỗi sensor an toàn | OLED báo lỗi; loop/MQTT/controls khác tiếp tục | MANUAL — FINAL-GATE | Video + broker/serial diagnostic |
| [ ] E2E-11 | OLED boot/update/error | Boot, đọc DHT bình thường rồi gây lỗi/khôi phục | OLED init, value và error/recovery rendering đúng, không flicker bất thường | MANUAL — FINAL-GATE | Video toàn chuỗi |
| [ ] E2E-12 | WiFiManager captive portal | Xóa saved Wi-Fi theo guide; boot; dùng điện thoại nối AP | Portal cục bộ xuất hiện; không cần reflash; không lộ credential cloud | MANUAL — FINAL-GATE | Screen recording đã che credential |
| [ ] E2E-13 | Lưu Wi-Fi mới | Nhập SSID/password test; lưu và restart | ESP32 nối Internet/MQTT lại; credential chỉ ở device | MANUAL — FINAL-GATE | Broker online log + sanitized phone video |
| [ ] E2E-14 | MQTT reconnect | Ngắt broker/network rồi khôi phục | Retry interval bounded/tăng dần; không reset loop; tự reconnect | MANUAL — FINAL-GATE | Timestamped serial/broker log |
| [ ] E2E-15 | ESP32 restart/safe boot | Đưa lock về state đã biết, restart ESP32 và quan sát servo/state đến khi gửi command mới | Servo không tự di chuyển/replay; lock UNKNOWN, alarm INACTIVE, LED OFF, door UNKNOWN đến stable sample; availability/full state reconnect đúng; chỉ command LOCK/UNLOCK mới xác nhận lock | MANUAL — FINAL-GATE | Synchronized servo video + boot/broker/UI log |
| [ ] E2E-16 | Availability/LWT | Cắt nguồn/network bất thường rồi graceful reconnect | Retained `OFFLINE` LWT, sau đó `ONLINE`; Dashboard đổi status đúng | MANUAL — FINAL-GATE | Broker/FlowFuse timestamp capture |
| [ ] E2E-17 | Full state sau reconnect | Sau reconnect, subscribe/quan sát state topic | Full state retained được publish; cache/UI reconcile; door event cũ không replay | MANUAL — FINAL-GATE | Full JSON đã sanitize + cache/UI capture |
| [ ] E2E-18 | Valid ACK | Tạo pending command và feed/nhận ACK khớp hoàn toàn | Timer hủy; đúng domain success; state/event cập nhật một lần | Automated | Test runner + command/ACK fixtures |
| [ ] E2E-19 | Wrong command_id | Pending A nhưng nhận ACK ID B/unknown | Không success/cancel A; ACK được diagnostic/dropped an toàn | Automated | Assertions + diagnostic output |
| [ ] E2E-20 | Command timeout | Không gửi ACK đến deadline | UI timeout; event timeout; không auto-retry actuator; GET_STATE một lần | Automated | Virtual clock/output trace |
| [ ] E2E-21 | Duplicate command | Deliver cùng command ID hai lần tới firmware/flow | Actuator một lần; cached ACK/dedupe insert; không double event | Automated + MANUAL — FINAL-GATE | Unit report và hardware message/action count |
| [ ] E2E-22 | Invalid JSON | Gửi malformed payload không lấy được ID, rồi payload lấy được valid ID nhưng lỗi field | Không actuation/cache mutation; case không ID không có normal ACK và pending timeout/reconcile; case có ID nhận correlated error ACK | Automated | Fixtures + assertions cho no-ACK/error-ACK |
| [ ] E2E-23 | Invalid action | Gửi action ngoài allowlist với ID hợp lệ | Firmware không actuation; ACK error `INVALID_ACTION`; UI không success | Automated | Captured ACK/test output |
| [ ] E2E-24 | User chưa đăng nhập | Mở Dashboard/control endpoint không có token | Control disabled/401; không publish MQTT | MANUAL — FINAL-GATE | UI/network + broker capture |
| [ ] E2E-25 | JWT hết hạn | Dùng session hết hạn/revoked, thử command/history | Yêu cầu đăng nhập lại; 401; không side effect/data leak | MANUAL — FINAL-GATE | Sanitized response/UI/broker evidence |
| [ ] E2E-26 | User A điều khiển Locker B | Login A, sửa/request locker B | 403/disabled; không command topic B | MANUAL — FINAL-GATE | Sanitized API/UI + broker capture |
| [ ] E2E-27 | RLS User A đọc Locker B | Query lockers/events/settings B bằng JWT A và unauthenticated | Zero/deny theo policy; service role không ở client | MANUAL — FINAL-GATE | Sanitized Supabase responses/policy test |
| [ ] E2E-28 | Một lần mở hợp lệ, tự khóa, lần sau trái phép | Valid UNLOCK ACK khi `CLOSED`; OPEN → CLOSED, chờ auto-lock, rồi ép OPEN mà không gửi UNLOCK mới | OPEN đầu `authorized=true`; close tự về `LOCKED` không có ACK; OPEN sau `authorized=false`, buzzer/Telegram đúng một episode | MANUAL — FINAL-GATE | Synchronized ACK/door/event/UI/video log |
| [ ] E2E-29 | Mở cửa trái phép | Full state fresh xác nhận `LOCKED`; tạo OPEN stable | `authorized=false`; one `UNAUTHORIZED_OPEN`; buzzer; Telegram; latest alert | MANUAL — FINAL-GATE | Video + DB + Telegram + broker/UI evidence |
| [ ] E2E-30 | Telegram thành công | Owner bấm **Liên kết Telegram**, mở bot private, bấm **Start**, gửi tin thử rồi trigger unauthorized | Dashboard báo đúng tài khoản đã liên kết; một message đúng locker/time/door/lock/link; delivery success; browser không nhận Chat/User ID | MANUAL — FINAL-GATE | Screenshot đã che username/ID không cần thiết + sanitized settings/delivery log |
| [ ] E2E-31 | Telegram thất bại | Sau một success baseline, dùng controlled invalid bot credential hoặc chặn provider network trong môi trường test; trigger event rồi khôi phục secret và Full Deploy | Event/buzzer vẫn xử lý; failure rõ; no infinite retry/duplicate storm; success smoke sau restore | MANUAL — FINAL-GATE | Sanitized error + event/buzzer evidence + post-restore message |
| [ ] E2E-32 | Supabase thành công | Thực hiện door, lock, buzzer, LED và unauthorized flows | Rows đủ fields/source/result/auth/command/time, đúng owner | MANUAL — FINAL-GATE | Sanitized query export/screenshots |
| [ ] E2E-33 | Supabase thất bại | Chặn endpoint/credential test sai có kiểm soát | Real-time control/cảnh báo không crash; lỗi được surface; không retry vô hạn; UI lỗi phù hợp | MANUAL — FINAL-GATE | Failure/recovery logs |
| [ ] E2E-34 | Chart 7 ngày | Tạo deterministic data; chọn 7 ngày | 7 local calendar buckets; open/alert counts đúng; zero days hiển thị | MANUAL — FINAL-GATE | Source rows/query result/chart screenshot |
| [ ] E2E-35 | Chart 30 ngày | Chọn 30 ngày với data boundary | 30 local calendar buckets và totals đúng | MANUAL — FINAL-GATE | Source/expected/actual evidence |
| [ ] E2E-36 | Timezone correctness | Tạo event trước/sau local midnight, query chart/report | Bucket/report period theo configured timezone, DB vẫn UTC | Automated + MANUAL — FINAL-GATE | Dataset + query assertions + UI/email |
| [ ] E2E-37 | Daily email | Trigger scheduler/test hook cho deterministic ngày trước | Một email đúng owner/period/timezone/open/alert/latest activity | MANUAL — FINAL-GATE | Test mailbox + sanitized delivery/data evidence |
| [ ] E2E-38 | Chống email trùng | Trigger scheduler hai lần/restart quanh cùng report date | Chỉ một send; delivery unique key/log đúng | Automated + MANUAL — FINAL-GATE | Send count + delivery rows + mailbox |
| [ ] E2E-39 | Gemini live query | Hỏi lock/door/alarm current state | Node-RED lấy cache và Gemini chỉ diễn đạt exact facts/provenance | MANUAL — FINAL-GATE | Sanitized context + source state + answer |
| [ ] E2E-40 | Gemini history query | Hỏi count/recent alert với deterministic Supabase data | Node-RED query/tính; answer giữ đúng số/time range | MANUAL — FINAL-GATE | Source query/context/answer |
| [ ] E2E-41 | Gemini thiếu dữ liệu | Xóa/không có data trong scope rồi hỏi | Trả lời không đủ dữ liệu; không bịa số/event | Automated + MANUAL — FINAL-GATE | Context/answer + assertion |
| [ ] E2E-42 | Gemini API lỗi | Controlled invalid key/quota/network response | UI lỗi kiểm soát hoặc deterministic facts fallback; không leak secret | MANUAL — FINAL-GATE | Sanitized provider/UI logs |
| [ ] E2E-43 | Controls khi Offline | Device LWT offline hoặc MQTT disconnected | Controls disabled, lý do đúng; door UNKNOWN; không publish | MANUAL — FINAL-GATE | UI + broker capture |
| [ ] E2E-44 | Servo + LED + buzzer full load | OLED/DHT/MQTT chạy; LED max allowed; buzzer ON; actuate servo | Rail 5 V và 3V3 ổn định, không brownout/reset/MQTT loss/unsafe heat | MANUAL — FINAL-GATE | Voltage/current, video, serial/broker log |
| [ ] E2E-45 | Full demo regression | Chạy toàn bộ Section 11 trên release candidate từ login đến recovery | 12 requirements demo bằng data thật, không mock/secret, không Critical/High defect | MANUAL — FINAL-GATE | Full rehearsal video + signed checklist/build ID |

## 9. Manual Hardware Checklist

Mọi mục trong section này là **MANUAL hardware**, chưa được thực hiện ở baseline và mang nhãn gate cụ thể. Khi hardware chưa có, mục physical dùng `DEFERRED — HARDWARE-FINAL-GATE`: vẫn `[ ]`, không có `PASS`/`VERIFIED`, không chặn SOFTWARE-GATE handoff, nhưng bắt buộc trước FINAL RELEASE/DEMO. `SHOULD/OPTIONAL` không block Phase; nếu một mục conditional trở thành cần thiết để loại bỏ lỗi điện/an toàn đã quan sát, nó trở thành `MUST` cho test bị ảnh hưởng.

- [ ] **[MUST | DEFERRED — HARDWARE-FINAL-GATE | Phase 1]** Đối chiếu board ESP32 thực với PlatformIO board profile, pin labels, USB serial và điện áp chân.
- [ ] **[OPTIONAL]** Ghi serial/model/ảnh từng linh kiện dùng chính; phân biệt linh kiện dự phòng khỏi linh kiện đang test.
- [ ] **[MUST | DEFERRED — HARDWARE-FINAL-GATE | Phase 1]** Xác minh candidate pin map trên board thật; không dùng nhầm boot-strapping/input-only pin.
- [ ] **[MUST | DEFERRED — HARDWARE-FINAL-GATE | Phase 2]** Xác minh MC-38 logic điện, `INPUT_PULLUP`/điện trở, vị trí reed trên khung và nam châm trên cánh cửa; không tuyên bố digital input thường phát hiện dây đứt.
- [ ] **[MUST | DEFERRED — HARDWARE-FINAL-GATE | Phase 2]** Xác minh khoảng cách MC-38 ở trạng thái đóng/mở và dây không bị kéo/kẹp khi cửa chuyển động.
- [ ] **[MUST | DEFERRED — HARDWARE-FINAL-GATE | Phase 1]** Servo SG90 lấy 5 V trực tiếp từ rail đủ dòng, signal riêng, common ground; tuyệt đối không lấy dòng servo từ GPIO/3.3 V.
- [ ] **[MUST | DEFERRED — HARDWARE-FINAL-GATE | Phase 1]** Hiệu chuẩn góc LOCK/UNLOCK không tải; ghi giới hạn an toàn trước khi lắp linkage.
- [ ] **[MUST | DEFERRED — HARDWARE-FINAL-GATE | Phase 1]** Lắp chốt có giới hạn cơ khí/khe hở; không để servo stall kéo dài ở hai đầu hành trình.
- [ ] **[MUST | DEFERRED — HARDWARE-FINAL-GATE | Phase 1]** Test servo có tải lặp lại khi cửa căn chỉnh đúng; ghi lỗi cơ khí, nhiệt và dòng.
- [ ] **[MUST | DEFERRED — HARDWARE-FINAL-GATE | Phase 3]** Buzzer specimen đã có inactive bench PASS với VCC `3V3`, local active-low và GPIO qua 4,7 kΩ; còn xác minh LOW có âm trên GPIO26, voltage/current, 10 safe boots, ACK/state và full-load.
- [ ] **[MUST nếu revision 3V3 không qua active/current/full-load gate | DEFERRED — HARDWARE-FINAL-GATE | Phase 3]** Dừng dùng wiring hiện tại và thiết kế lại interface/nguồn đã xác minh; không tự nối lại VCC 5 V với input 3,3 V đã thất bại.
- [ ] **[MUST | DEFERRED — HARDWARE-FINAL-GATE | Phase 1]** Cấp DHT22 và pull-up data về 3.3 V; lắp 4.7–5.1 kΩ nếu module chưa tích hợp; tuyệt đối không để pull-up 5 V đi thẳng vào GPIO; đặt sensor trong khoang chứa.
- [ ] **[MUST | DEFERRED — HARDWARE-FINAL-GATE | Phase 1]** Xác minh OLED SSD1306 địa chỉ I2C và exact-board datasheet; baseline cấp 3.3 V với SDA/SCL pull-up 3.3 V, hoặc dùng level shifter đã xác minh nếu board bắt buộc 5 V; kiểm tra vị trí quan sát ở mặt trước khoang kỹ thuật.
- [ ] **[MUST | DEFERRED — HARDWARE-FINAL-GATE | Phase 1]** Đo số pixel WS2812B thực, current worst case và đặt brightness limit phù hợp nguồn.
- [ ] **[MUST | DEFERRED — HARDWARE-FINAL-GATE | Phase 1]** Lắp điện trở 330–470 Ω nối tiếp data WS2812B và tụ 470–1000 µF gần đầu nguồn strip.
- [ ] **[MUST | DEFERRED — HARDWARE-FINAL-GATE | Phase 1]** Dùng baseline 74AHCT125 không đảo, hoặc hai cổng đảo 74HCT14 mắc nối tiếp, cấp 5 V giữa ESP32 và WS2812 DIN; chỉ bỏ/thay khi primary datasheet của đúng part đã mua và phép đo rail chứng minh mức logic an toàn.
- [ ] **[MUST | DEFERRED — HARDWARE-FINAL-GATE | Phase 1]** Xác minh nguồn DC 5 V/3 A đúng cực, công suất và chất lượng; jack/công tắc/terminal không lỏng hoặc quá nhiệt.
- [ ] **[MUST | DEFERRED — HARDWARE-FINAL-GATE | Phase 1]** Tất cả thiết bị dùng common ground; servo/LED dùng nhánh tải 5 V, còn buzzer specimen dùng ESP32 `3V3` theo wiring đã kiểm thử một phần; GPIO không cấp dòng tải.
- [ ] **[MUST | DEFERRED — HARDWARE-FINAL-GATE | Phase 1]** Dùng dây đủ tiết diện cho tải; mối nối cách điện, có strain relief và không để dây trần chạm vỏ/linh kiện.
- [ ] **[MUST | DEFERRED — HARDWARE-FINAL-GATE | Phase 1]** Lắp tụ 470–1000 µF đúng cực/rating gần nguồn WS2812; chọn decoupling/bulk nhánh servo từ exact-part datasheet và phép đo, không thêm linh kiện ngẫu nhiên để che nguồn thiếu dòng.
- [ ] **[MUST | DEFERRED — HARDWARE-FINAL-GATE | Phase 1]** Xác nhận không đồng thời cấp nguồn ngoài và USB theo đường có thể back-feed; chỉ dùng topology được tài liệu chính thức của đúng board cho phép.
- [ ] **[MUST | DEFERRED — HARDWARE-FINAL-GATE]** Hoàn tất `hardware/bom.md` và `hardware/power-budget.md` bằng model/datasheet/dòng đo thật trước khi mua chốt nguồn hoặc chạy full-load.
- [ ] **[MUST | FINAL-GATE]** Đo cả rail 5 V và 3V3, theo dõi brownout khi boot, Servo + LED, rồi Servo + LED + Buzzer full load.
- [ ] **[MUST | FINAL-GATE]** Xác nhận ESP32, OLED, MQTT và DHT22 vẫn ổn định trong full-load test.
- [ ] **[MUST | FINAL-GATE]** Kiểm tra nhiệt độ/âm lượng/thời lượng buzzer và LED trong giới hạn demo an toàn.
- [ ] **[MUST | FINAL-GATE]** Kiểm tra jack nguồn, công tắc và phương án ngắt nguồn khẩn cấp dễ tiếp cận.
- [ ] **[MUST | FINAL-GATE]** Cố định ESP32, breadboard/PCB, servo, buzzer và connectors trên khay; chỉ thêm driver/MOSFET nếu revision được thiết kế lại; không để linh kiện rơi vào khoang chứa.
- [ ] **[SHOULD]** Nắp khoang kỹ thuật tháo được để bảo trì nhưng được cố định chắc khi vận hành.
- [ ] **[MUST | FINAL-GATE]** Dây được đi sát vách, có quản lý dây và tấm che; không cản cửa, chốt hoặc vật dụng.
- [ ] **[MUST | FINAL-GATE]** Đối chiếu kích thước danh nghĩa tổng thể 300 × 250 × 220 mm, khoang chứa 260 × 170 × 190 mm và vỏ 10 mm; ghi rõ sai số/gia công thực.
- [ ] **[MUST | DEFERRED — HARDWARE-FINAL-GATE | Phase 1]** Test WiFiManager/reset configuration bằng điện thoại thật, không quay/lưu password trong evidence.
- [ ] **[MUST | DEFERRED — HARDWARE-FINAL-GATE | Phase 1]** Test restart/mất Wi-Fi/mất MQTT/cắt nguồn và recovery theo các test case Phase 1, không chỉ một lần thuận lợi.
- [ ] **[SHOULD]** Dán nhãn dây/connector, GPIO và polarity để thành viên khác lắp lại không suy đoán.
- [ ] **[MUST | FINAL-GATE]** Cập nhật wiring diagram/pin map/power budget theo “as-built”, không để tài liệu chỉ phản ánh thiết kế ban đầu.
- [ ] **[MUST | FINAL-GATE]** Lưu ảnh/video/đo điện áp theo Test ID; evidence không chứa token, Wi-Fi password, email cá nhân hoặc nội dung nhạy cảm.

## 10. Environment and Credential Checklist

### Ma trận cấu hình

| Cấu hình | Consumer | Secret? | Nơi được phép lưu | Không được phép |
|---|---|---:|---|---|
| `LOCKER_ID` | Firmware, Node-RED, Supabase mapping | Không | Config/env public phù hợp | Hard-code khác nhau giữa producer/consumer |
| MQTT host/port/TLS | Firmware, Node-RED | Host thường không; credential có | Environment/ignored device config/secret store | Dashboard frontend, committed `platformio.ini` password |
| MQTT username/password | Firmware, Node-RED | Có | Device provisioning/local ignored file; Node-RED secrets | Git, log, screenshot, Dashboard |
| Supabase URL + anon/publishable key | Dashboard/Node-RED | Không phải service secret nhưng vẫn là config | `.env.example` tên biến; deploy env | Nhầm với service-role key |
| Supabase service-role key | Node-RED only | Có, đặc quyền cao | Backend secret store/environment | Browser, FlowFuse UI payload, Git/evidence |
| Supabase JWT/session | Browser session và request tới Node-RED | Có, ngắn hạn | Session storage/runtime theo thiết kế | Log, Gemini context, DB event metadata |
| Telegram bot token | Node-RED only | Có | Backend secret store | DB settings row, Dashboard, Git |
| Telegram private Chat/User ID | Node-RED/service-role Supabase settings only | Nhạy cảm | Không cấp cột cho browser; link qua one-time token + secret webhook | Public response/log/evidence |
| Gmail App Password/OAuth | Node-RED only | Có | Backend secret/credential store | Flow export plaintext, Git, screenshot |
| Email recipient | Owner-protected settings | PII | Supabase RLS row | Cross-locker query/log công khai |
| Gemini API key | Node-RED only | Có | Backend secret store | Dashboard, Gemini prompt/context, Git |
| Gemini model | Node-RED | Không | Environment | Hard-code rải rác trong flow |
| Wi-Fi SSID/password | ESP32/WiFiManager | Password có | Captive portal → ESP32 NVS | Dashboard, Node-RED, MQTT, Cloud, Git |
| `NODE_RED_CREDENTIAL_SECRET` | Node-RED runtime | Có | Deployment secret | Repository hoặc chia sẻ qua chat/evidence |

### Checklist

- [ ] **[MUST | Phase 1]** Tạo `.env.example` chỉ với tên biến/placeholder rõ như `replace_me`; không dùng credential thật hoặc chuỗi giống secret có thể hoạt động.
- [ ] **[MUST | Phase 1]** `.gitignore` bao phủ `.env`, local secret headers, PlatformIO `.pio`, Node-RED local credential/runtime files, log/cache và service exports nhạy cảm.
- [ ] **[MUST | Phase 2]** Tách frontend-safe Supabase anon/publishable key khỏi service-role key; tìm kiếm toàn repository để xác nhận service-role không xuất hiện ở dashboard.
- [ ] **[MUST khi dùng credential node | Phase 2]** Cấu hình Node-RED credential encryption secret qua deployment environment trước khi lưu credential node.
- [ ] **[MUST | Phase 1]** MQTT broker bật authentication; TLS/certificate được xác minh nếu traffic qua Internet; local isolated development không bắt buộc TLS; không tắt certificate verification ở remote để “chạy được”.
- [ ] **[OPTIONAL]** MQTT ACL giới hạn device theo topic locker nếu broker hỗ trợ và còn thời gian; đây là defense-in-depth, không thay auth/ownership gate.
- [ ] **[MUST | Phase 1]** MQTT command topic không retained; kiểm tra retained inventory trước demo để không có command cũ.
- [ ] **[MUST | Phase 1]** Provision MQTT credential firmware bằng cơ chế bị ignore/runtime; tài liệu hóa cách thay/rotate mà không ghi value.
- [ ] **[MUST | Phase 2]** Supabase project URL/keys được nạp từ environment; service-role chỉ ở backend và được rotate nếu từng lộ.
- [ ] **[MUST | HARD-GATE Phase 2]** Tạo tối thiểu User A/User B và Locker A/Locker B cho security test; không dùng tài khoản cá nhân chính trong evidence.
- [ ] **[MUST | Phase 2]** Locker claim code/test data được quản lý riêng; owner ID không thể update từ frontend.
- [ ] **[MUST | FINAL-GATE]** Telegram bot token/webhook và automatic private-account link được kiểm thử ở môi trường test; screenshot che thông tin không cần thiết.
- [ ] **[MUST | FINAL-GATE]** Gmail credential/test mailbox được cấu hình; không dùng email production/lớp học nếu chưa được phép.
- [ ] **[MUST | FINAL-GATE]** Gemini API key/model/quota được xác minh; không gửi JWT, email, token, service key hoặc raw PII trong context.
- [ ] **[MUST | Phase 3]** Notification recipient/time/timezone có validation và RLS; default timezone `Asia/Ho_Chi_Minh` được ghi rõ.
- [ ] **[MUST | DEFERRED — HARDWARE-FINAL-GATE | Phase 1]** Wi-Fi password chỉ nhập qua portal cục bộ và không xuất hiện trong serial log, MQTT, Dashboard, video hoặc docs.
- [ ] **[MUST]** Logging ở trust boundaries redact `Authorization`, cookies, API keys, passwords, SMTP auth, bot tokens và full JWT.
- [ ] **[MUST]** Test fixtures dùng ID/email giả rõ ràng; không sao chép production dumps vào repository.
- [ ] **[MUST]** Trước mỗi commit/merge/release, scan working tree/staged diff và các file sẽ commit để bảo đảm không có secret; false positive chỉ suppress bằng lý do hẹp được ghi lại.
- [ ] **[SHOULD]** Scan toàn Git history trước final release nếu tooling sẵn có; **MUST** thực hiện điều tra/history cleanup phù hợp khi có incident thật. Không xây exhaustive secret-history pipeline chỉ để block đồ án.
- [ ] **[SHOULD]** Kiểm tra quota/free-tier Supabase, FlowFuse, broker, Telegram, Gmail và Gemini; core failure behavior vẫn phải rõ thay vì giả luôn khả dụng.
- [ ] **[MUST]** Ghi deployment-specific values ngoài Git theo phương thức nhóm thống nhất; backup credential không đặt trong repository/USB demo không mã hóa.
- [ ] **[MUST khi có incident]** Nếu phát hiện secret đã commit/log: dừng dùng secret, rotate/revoke trước, làm sạch nơi công khai theo quy trình được phép và ghi incident không chứa value.

## 11. Final Demo Script

Demo phải chạy trên một release candidate/build ID đã ghi, dùng dữ liệu thật của test accounts, không sửa flow/firmware giữa chừng để che lỗi. Ưu tiên 10–15 phút; WiFiManager có thể đặt cuối vì làm mất kết nối chủ động.

### Chuẩn bị trước demo

1. Xác nhận nguồn 5 V/3 A, wiring/as-built, điện thoại/laptop, Internet/hotspot dự phòng và emergency power-off.
2. Xác nhận ESP32 firmware version/build ID, Node-RED deploy version, Supabase migration version và release commit khớp test evidence.
3. Đặt cửa `CLOSED`, khóa `LOCKED`, alarm `INACTIVE`, LED `OFF`; xóa pending command; không sửa DB history để giả kết quả.
4. Xác nhận test User A owns Locker A; User B/Locker B có sẵn cho negative test; session/token không xuất hiện trên màn chiếu.
5. Xác nhận owner đã liên kết private Telegram account bằng nút **Liên kết Telegram**, Gmail test inbox và Gemini quota; chuẩn bị failure-safe message nếu dịch vụ ngoài không khả dụng.
6. Chuẩn bị video dự phòng, screenshots Telegram/email, sanitized DB export, MQTT/Node-RED logs, USB/cáp/firmware binary/flow export theo chính sách secret.

### Trình tự demo chính

1. **Giới thiệu và kiến trúc**
   - Cho xem mô hình vật lý, khoang chứa/khoang kỹ thuật và nêu 12 requirement.
   - Trình bày luồng bắt buộc Dashboard → Node-RED → MQTT → ESP32; chỉ DHT22 → ESP32 → OLED là cục bộ.

2. **YC9 Auth và ownership**
   - Đăng nhập User A; hiển thị Locker A.
   - Chứng minh chưa đăng nhập hoặc session không hợp lệ không điều khiển được.
   - Dùng negative test/sanitized evidence chứng minh User A không đọc/điều khiển Locker B và RLS chặn ở database.

3. **CB1 Door state**
   - Cho xem MQTT/ESP32 Online và door `CLOSED`.
   - Mở/đóng cửa, chỉ ra debounce, `OPEN/CLOSED`, timestamp và recent event.
   - Nếu thời lượng cho phép, trình bày `UNKNOWN` bằng evidence boot-before-stable-sample, Offline/stale hoặc invalid payload; không tháo dây để tuyên bố broken-wire detection.

4. **CB2 Lock/Unlock**
   - Nhấn `UNLOCK`; chỉ ra `PENDING`, command ID, servo chuyển động, ACK rồi Dashboard `UNLOCKED`.
   - Gửi `UNLOCK` khi cửa đóng và mở lần đầu: `authorized=true`. Đóng cửa: chốt tự về `LOCKED` mà không có ACK mới. Ép/mở lại mà không cấp quyền mới: `authorized=false`, buzzer/Telegram hoạt động.
   - Minh họa expiry bằng một `UNLOCK` khác nhưng không mở trong 30 giây; chốt tự khóa đúng hạn. Nút `LOCK`/“Khóa ngay” là override thủ công và chỉ báo success sau ACK.

5. **YC3 LED, CB3 Buzzer và YC1 local OLED**
   - Bật/tắt LED qua Dashboard, chỉ ra pending/ACK/state.
   - Bật còi/Tắt còi, chỉ ra buzzer thật, ACK và ACTIVE/INACTIVE.
   - Cho xem nhiệt độ/độ ẩm trên OLED; nhắc rõ không đưa YC1 lên Dashboard.

6. **YC6 mở cửa trái phép**
   - Bảo đảm full state fresh và lock `LOCKED`.
   - Tác động MC-38/mở cửa an toàn.
   - Cho thấy one `UNAUTHORIZED_OPEN`, `authorized=false`, buzzer ACTIVE, latest alert, Telegram và Supabase event.
   - Đóng cửa/Tắt còi theo quy trình; chứng minh không gửi cảnh báo lặp trong cùng episode.

7. **YC4 History và YC5 Chart**
   - Mở recent/history, đối chiếu các event door/lock/alarm/LED/unauthorized vừa tạo.
   - Chọn 7 ngày rồi 30 ngày; nêu counting rule và timezone; chỉ ra empty/zero-day behavior nếu có data chuẩn bị hợp lệ.

8. **YC7 Daily email**
   - Cho xem notification setting, report time/timezone.
   - Mở email test đã gửi bởi scheduler/test hook hợp lệ: report period, số lần mở, số cảnh báo, hoạt động gần nhất.
   - Cho xem delivery log/dedupe evidence, không hiển thị SMTP credential.

9. **YC8 Chatbot**
   - Hỏi một câu live: “Tủ hiện đang khóa hay mở?” hoặc “Cửa tủ đang đóng hay mở?”.
   - Hỏi một câu history: “Trong 7 ngày qua có bao nhiêu lần mở tủ?” hoặc “Cảnh báo gần nhất xảy ra khi nào?”.
   - Đối chiếu answer với cache/query; nêu Gemini chỉ diễn đạt, Node-RED tính facts.

10. **YC12 WiFiManager và recovery**
    - Thực hiện cuối demo hoặc dùng video/profile riêng: xóa/mất saved Wi-Fi, kết nối AP bằng điện thoại, nhập Wi-Fi mới, ESP32 reconnect MQTT và publish full state.
    - Không chiếu SSID/password thật; chỉ ra LWT Offline/Online và controls disabled trong downtime.

11. **Kết thúc và traceability**
    - Tóm tắt 12 requirement, owner đúng ba Phase và recovery/security chính.
    - Nêu build/commit/release evidence thật; không tuyên bố test chưa chạy.

### Final release checklist

- [x] Phase 1, Phase 2, Phase 3 đều `COMPLETED` bằng SOFTWARE-GATE evidence và integration thật trên `develop`; project đã ở `SOFTWARE_COMPLETE`. Đây chỉ là software prerequisite, không thay thế các release gate còn trống bên dưới.
- [ ] 12 requirement có traceability requirement → owner → module → test → evidence.
- [ ] Critical = 0 và High = 0; Medium có workaround/decision được chấp nhận.
- [ ] Firmware clean build, Node-RED deploy/export, Supabase migrations/RLS và relevant automated tests đã chạy trên release candidate.
- [ ] Full demo regression theo Test `E2E-45` đã chạy; không còn production mock data.
- [ ] Manual full-load, auth/RLS, external services và recovery tests có evidence.
- [ ] Mọi `DEFERRED — HARDWARE-FINAL-GATE` đã được chạy trên release candidate với hardware thật: P1-M01–P1-M11 (ESP32, servo/latch/power, DHT22/OLED, WS2812B, WiFiManager, physical MQTT recovery), P2-M01/P2-M02 (MC-38), P3-M01–P3-M03 (buzzer/physical producers), full-load và physical E2E. Simulator/mock/broker-only output không thay thế evidence này.
- [ ] README/user/deployment/troubleshooting/demo docs khớp as-built system.
- [ ] Không có secret trong Git, flow export, firmware binary metadata, log, screenshot/video hoặc release package.
- [ ] PDF nguồn còn nguyên và không bị sửa.
- [ ] Release commit/tag/version/deployment URLs được ghi bằng giá trị thật, không placeholder.
- [ ] Backup/recovery artifacts mở được và không chứa credential plaintext.
- [ ] Cả ba thành viên có thể giải thích phần mình và dependency tích hợp chéo.

## 12. Terra xHigh Execution Prompt

### Prompt mẫu

```text
Bạn đang thực thi Phase `<PHASE_NUMBER>` cho owner `<MEMBER_NAME>`.

1. Đọc toàn bộ PLAN.md và repository trước khi chỉnh file.
2. Xác minh Phase `<PHASE_NUMBER>` đang `ACTIVE`; nếu không, dừng và báo evidence trạng thái.
3. Xác minh owner là `<MEMBER_NAME>` và Phase trước (nếu có) đã `COMPLETED` trên `develop` bằng Git evidence thật; các deferred hardware final gates vẫn `[ ]` và không được gọi là completed/verified.
4. Đọc implementation, tests, config, docs và diff hiện có; bảo toàn user work.
5. Ưu tiên hoàn thành tất cả `MUST` theo Minimum Required Completion Path trước.
6. Không làm `OPTIONAL` cho đến khi mọi `MUST` đã hoàn thành; `SHOULD` không được làm chậm committed scope.
7. Chỉ làm checklist của Phase hiện tại; không bắt đầu hoặc sửa implementation Phase khác.
8. Không đổi scope, owner hoặc frozen shared contract; thay đổi contract chỉ khi PLAN cho phép, có version và producer/consumer evidence thật.
9. Áp dụng Simple Implementation Rule: chọn implementation đơn giản nhất đủ yêu cầu, KISS/YAGNI, tách trách nhiệm vừa đủ; không giant Function node/god class/premature optimization.
10. Thực sự tạo/sửa source code, config, tests và docs thuộc Phase hiện tại; không thay bằng mô tả hoặc placeholder.
11. Chạy build/test thực tế có thể chạy và lưu command/output/evidence thật.
12. Thực hiện MANUAL test khi phần cứng, account và credential hiện có cho phép; chạy SOFTWARE-GATE/broker-simulator khi khả thi và giữ physical test thiếu hardware là `[ ] DEFERRED — HARDWARE-FINAL-GATE`.
13. Không giả MANUAL evidence, không ghi PASS cho test chưa chạy và không suy đoán phần cứng hoạt động.
14. Không giả credential/secret/account/service; không commit hoặc log secret.
15. Chỉ tick checklist/test/acceptance khi có evidence truy vết được.
16. Cập nhật PLAN.md tối thiểu cho status, evidence, deferred items và handoff; không rewrite checklist của Phase khác.
17. Commit và push Phase branch theo Git Checklist; chỉ ghi hash/remote state thật, không force push hoặc rewrite history.
18. Khi SOFTWARE-GATE `PASS` và có quyền, fast-forward merge Phase branch vào `develop`, push `develop`, cập nhật/commit/push lifecycle: Phase hiện tại `COMPLETED`, Phase kế tiếp `ACTIVE`; tạo/push branch kế tiếp từ `develop`. Với Phase 3, đặt project `SOFTWARE_COMPLETE` thay vì tạo Phase mới.
19. Nếu thiếu quyền push/merge, giữ Phase `ACTIVE`, ghi blocker và exact commands cần chạy; không bịa trạng thái remote.
20. Review và Pull Request không bắt buộc. Sau lifecycle transition thành công, không triển khai functionality Phase kế tiếp và dừng.
```

### Bản điền sẵn — Phase 1

```text
Bạn đang thực thi Phase 1 cho owner Thái Quang Huy — 24127177; scope là repository/PlatformIO + shared firmware/MQTT foundation, CB2, YC1, YC3 và YC12.

1. Đọc toàn bộ PLAN.md và repository trước khi chỉnh file.
2. Xác minh Phase 1 đang `ACTIVE`; nếu không, dừng và báo evidence trạng thái.
3. Xác minh owner là Thái Quang Huy — 24127177; Phase 1 không có Phase trước và Phase 2/3 phải còn `NOT_STARTED`.
4. Đọc implementation, tests, config, docs và diff hiện có; bảo toàn user work kể cả repository đã không còn greenfield.
5. Ưu tiên hoàn thành tất cả `MUST` trong Minimum Required Completion Path Phase 1 trước.
6. Không làm `OPTIONAL` cho đến khi mọi `MUST` hoàn thành; `SHOULD` không được làm chậm CB2/YC1/YC3/YC12/foundation.
7. Chỉ làm Phase 1; không triển khai CB1/YC6/YC8/YC9/CB3/YC4/YC5/YC7.
8. Không đổi scope, owner hoặc frozen shared contract; không đơn phương thêm field/topic bắt buộc.
9. Chọn implementation đơn giản nhất đủ yêu cầu, KISS/YAGNI, module vừa đủ; không god class/framework/retry/cache phức tạp.
10. Thực sự tạo/sửa source code firmware, config, tests và docs của Phase 1; không thay bằng placeholder.
11. Chạy clean firmware build và mọi automated parser/state/dedupe test có thể chạy; lưu command/output thật.
12. Thực hiện P1-S broker/simulator SOFTWARE-GATE khi harness/broker có sẵn; nếu ESP32, linh kiện và điện thoại chưa có thì giữ P1-M01–P1-M11 là `DEFERRED — HARDWARE-FINAL-GATE`, không ghi PASS.
13. Không giả MANUAL evidence hoặc ghi PASS cho board/servo/DHT/OLED/LED/WiFi/MQTT chưa test.
14. Không giả Wi-Fi/MQTT credential; không commit/log password hoặc secret.
15. Chỉ tick checklist/test/acceptance có evidence truy vết được.
16. Cập nhật PLAN.md tối thiểu cho Phase 1 status/evidence/deferred items/handoff; không rewrite Phase 2/3.
17. Commit và push `phase/1-huy-firmware-foundation`; chỉ ghi hash/remote state thật, không force push hoặc rewrite history.
18. Khi SOFTWARE-GATE `PASS` và có quyền, tạo/fast-forward `develop` tại Phase-1 HEAD, push `develop`, cập nhật/commit/push Phase 1 `COMPLETED` và Phase 2 `ACTIVE`, rồi tạo/push `phase/2-minh-security-orchestration` từ `develop`.
19. Nếu thiếu quyền push/integration, giữ Phase 1 `ACTIVE`, ghi blocker và exact commands cần chạy; không bịa remote state. P1-M01–P1-M11 luôn giữ `[ ] DEFERRED — HARDWARE-FINAL-GATE` cho đến hardware-final workflow.
20. Không cần review hoặc Pull Request. Không triển khai Phase 2 functionality trong phiên lifecycle transition; sau khi branch setup thành công thì dừng.
```

### Bản điền sẵn — Phase 2

```text
Bạn đang thực thi Phase 2 cho owner Nguyễn Văn Minh — 24127205; scope là CB1, YC6 logic/Telegram/interface, YC8, YC9 và Node-RED auth/security/orchestration foundation.

1. Đọc toàn bộ PLAN.md và repository trước khi chỉnh file.
2. Xác minh Phase 2 đang `ACTIVE`; nếu không, dừng và báo evidence trạng thái.
3. Xác minh owner là Nguyễn Văn Minh — 24127205, Phase 1 software baseline đã `COMPLETED` trên `develop`, P1 hardware final gates vẫn `[ ] DEFERRED — HARDWARE-FINAL-GATE` và Phase 3 còn `NOT_STARTED`.
4. Đọc implementation, tests, config, docs, frozen contracts và diff hiện có; bảo toàn Phase 1/user work.
5. Ưu tiên hoàn thành tất cả `MUST` trong Minimum Required Completion Path Phase 2 trước.
6. Không làm `OPTIONAL` cho đến khi mọi `MUST` hoàn thành; `SHOULD` không được làm chậm CB1/YC6/YC8/YC9/orchestration.
7. Chỉ làm Phase 2; không triển khai actual CB3 buzzer hoặc YC4 persistence. Chỉ tạo contract/interface để Mai Phương Thùy nối ở Phase 3.
8. Không đổi scope, owner hoặc frozen contract; giữ Nguyễn Văn Minh là owner YC6/YC8 và không nhận owner CB3/YC4.
9. Chọn implementation đơn giản nhất đủ yêu cầu, KISS/YAGNI, subflow/module vừa đủ; không giant Function node, queue/LRU/retry/validator framework phức tạp.
10. Thực sự tạo/sửa firmware CB1, Node-RED, Supabase YC9, Dashboard phần Phase 2, tests và docs; không thay bằng placeholder.
11. Tạo/dùng `tools/device-simulator/` theo frozen MQTT contract và chạy firmware regression + automated/simulator tests cho debounce, auth/RLS, validation, dispatcher, ACK/timeout/dedupe, YC6 và YC8 contract; lưu output thật.
12. Thực hiện MANUAL service/account test nếu environment có sẵn; MC-38/ESP32 board test chưa có hardware phải giữ `DEFERRED — HARDWARE-FINAL-GATE`, còn `FINAL-GATE` service được ghi pending trung thực.
13. Không giả MANUAL evidence, actual buzzer ACK, event persistence hoặc history backend thật.
14. Không giả credential/account/service; không commit/log JWT, service-role key, Telegram/Gemini secret hoặc PII.
15. Chỉ tick checklist/test/acceptance có evidence truy vết được.
16. Cập nhật PLAN.md tối thiểu cho Phase 2 status/evidence/deferred items/handoff; không rewrite Phase 1/3.
17. Commit và push `phase/2-minh-security-orchestration`; chỉ ghi hash/remote state thật, không force push hoặc rewrite history.
18. Khi SOFTWARE-GATE `PASS` và có quyền, fast-forward merge Phase branch vào `develop`, push `develop`, cập nhật/commit/push Phase 2 `COMPLETED` và Phase 3 `ACTIVE`, rồi tạo/push `phase/3-thuy-data-integration` từ `develop`.
19. Nếu thiếu quyền push/integration, giữ Phase 2 `ACTIVE`, ghi blocker và exact commands cần chạy; không bịa remote state. MC-38/ESP32 hardware gates vẫn `[ ]` và các `FINAL-GATE` pending vẫn block final release.
20. Không cần review hoặc Pull Request. Không triển khai Phase 3 functionality trong phiên lifecycle transition; sau khi branch setup thành công thì dừng.
```

### Bản điền sẵn — Phase 3

```text
Bạn đang thực thi Phase 3 cho owner Mai Phương Thùy — 24127249; scope là CB3, YC4, YC5, YC7, full YC6/YC8 integration, final Dashboard/testing/docs/release.

1. Đọc toàn bộ PLAN.md và repository trước khi chỉnh file.
2. Xác minh Phase 3 đang `ACTIVE`; nếu không, dừng và báo evidence trạng thái.
3. Xác minh owner là Mai Phương Thùy — 24127249 và Phase 2 software baseline đã `COMPLETED` trên `develop` bằng Git evidence thật; prior hardware final gates vẫn `[ ]`/deferred.
4. Đọc implementation, tests, config, docs, frozen contracts và diff hiện có; bảo toàn Phase 1/2/user work.
5. Ưu tiên hoàn thành tất cả `MUST` trong Minimum Required Completion Path Phase 3 trước.
6. Không làm `OPTIONAL` cho đến khi mọi `MUST` hoàn thành; `SHOULD` không được làm chậm CB3/YC4/YC5/YC7/integration/release.
7. Chỉ làm Phase 3; không tạo Phase 4 hoặc rewrite implementation đã đạt của Phase trước ngoài phần tích hợp bắt buộc.
8. Không đổi scope, owner hoặc frozen contract; nối buzzer/persistence vào YC6 và history vào YC8 nhưng giữ Nguyễn Văn Minh là owner YC6/YC8.
9. Chọn implementation đơn giản nhất đủ yêu cầu, KISS/YAGNI, separation vừa đủ; không framework migration/dead-letter/retry/observability/scaling phức tạp.
10. Thực sự tạo/sửa firmware CB3, Supabase YC4/YC5/YC7, Node-RED, final Dashboard, tests và docs; không thay bằng placeholder.
11. Chạy firmware/Node-RED/Supabase/RLS/aggregation/email-dedupe/regression tests có thể chạy; lưu command/output thật.
12. Thực hiện SOFTWARE-GATE/simulator và MANUAL service tests khi environment có sẵn; physical test thiếu hardware giữ `DEFERRED — HARDWARE-FINAL-GATE`. Trước release phải chạy toàn bộ physical E2E/final hardware gates thật.
13. Không giả MANUAL evidence, full-load result, Telegram/Gmail/Gemini delivery hoặc demo rehearsal.
14. Không giả credential/account/service/release tag; không commit/log service-role, MQTT, Telegram, Gmail, Gemini hoặc Wi-Fi secret.
15. Chỉ tick checklist/test/acceptance có evidence truy vết được.
16. Cập nhật PLAN.md tối thiểu cho Phase 3 status/evidence/deferred items/handoff; không rewrite checklist Phase 1/2.
17. Commit và push `phase/3-thuy-data-integration`; chỉ ghi hash/remote state thật, không force push hoặc rewrite history.
18. Khi SOFTWARE-GATE `PASS` và có quyền, fast-forward merge Phase branch vào `develop`, push `develop`, cập nhật/commit/push Phase 3 `COMPLETED` và project `SOFTWARE_COMPLETE`.
19. Nếu thiếu quyền push/integration, giữ Phase 3 `ACTIVE`, ghi blocker và exact commands cần chạy; không bịa remote/release state. Deferred hardware-final/`FINAL-GATE` vẫn `[ ]`/`Pending` và block `FINAL_RELEASE_READY`.
20. Không cần review hoặc Pull Request. Không tạo Phase 4, không gọi project final/released; sau khi đặt `SOFTWARE_COMPLETE` thì dừng để cả nhóm bắt đầu hardware workflow.
```

Historical baseline invariants trước lần thực thi đầu tiên: chỉ Phase 1 là `ACTIVE`; Phase 2/3 là `NOT_STARTED`; không implementation checkbox nào được tick; không test nào có kết quả; mọi Phase Completion Summary là `Pending`; không có commit/release giả; CB3 và YC4 không thuộc Minh; YC6 phụ thuộc actual CB3 + YC4 ở Phase 3; YC1 vẫn là luồng local-only; mọi secret nằm ngoài Git. Current state phải lấy từ Phase registry và Git evidence, không từ historical baseline này.
