ThaiQuangHuy2906/smart-privacy-locker/THUYETMINH/03_SMART_PRIVACY_LOCKER_VIVA_FINAL/05_BAO_CAO_KIEM_CHUNG/KIEM_TRA_DAY_DU_17_HANG_MUC.md

# KIỂM TRA ĐỦ 17 HẠNG MỤC

Kết luận: **PASS**. Mapping phủ đủ 17 nhóm `01`-`17`; các nhóm có chi tiết A/B/C được tách thành 21 điểm mũi tên để tránh chỉ nhầm linh kiện.

| ID | Bộ phận | ID chức năng | Vị trí dự kiến/hiện tại | Kết quả |
|---|---|---|---|---:|
| 01A | MC-38 reed trên khung | CB1 · YC4 · YC6 | Khung phải, đối diện nam châm cửa | PASS |
| 01B | Nam châm MC-38 trên cửa | CB1 · YC4 · YC6 | Mép phải cánh cửa | PASS |
| 02A | Servo SG90 | CB2 | Góc phải khoang kỹ thuật | PASS |
| 02B | Tay servo + thanh truyền | CB2 | Nối servo với chốt | PASS |
| 02C | Chốt khóa | CB2 | Sát mép phải cửa | PASS |
| 03 | Active Buzzer 5 V | CB3 · YC6 | Trên khay, gần vùng thoát âm | PASS |
| 04 | DHT22 | YC1 | Vách sau khoang chứa | PASS |
| 05A | Mặt hiển thị OLED | YC1 | Mặt trước nắp khoang kỹ thuật | PASS |
| 05B | PCB OLED phía sau | YC1 | Ngay sau cửa sổ OLED | PASS |
| 06 | Dải LED WS2812B | YC3 | Mặt dưới vách ngăn kỹ thuật | PASS |
| 07 | ESP32 DevKit V1 | CB1 · CB2 · CB3 · YC1 · YC3 · YC12 | Khay điện tử trong khoang kỹ thuật | PASS |
| 08 | Breadboard 830 lỗ | CB1 · CB2 · CB3 · YC1 · YC3 | Giữa khay kỹ thuật | PASS |
| 09 | MOSFET D4184 | CB2 · CB3 · YC3 | Cạnh ESP32 và đầu nối tải | PASS |
| 10 | Jack nguồn DC 5 V/3 A gắn tủ | CB1 · CB2 · CB3 · YC1 · YC3 | Mặt sau; nguồn đi qua công tắc | PASS |
| 11 | Công tắc nguồn | CB1 · CB2 · CB3 · YC1 · YC3 | Mặt sau, nối tiếp trước BUS_5V_SW | PASS |
| 12 | Khoang kỹ thuật | Vùng kết cấu | Phía trên khoang chứa | PASS |
| 13 | Khoang chứa | Vùng sử dụng | Phía dưới vách ngăn kỹ thuật | PASS |
| 14 | Nắp khoang kỹ thuật tháo rời | Kết cấu bảo trì | Mặt trước khoang kỹ thuật | PASS |
| 15 | Hệ thống quản lý dây | Kết cấu bảo vệ | Gờ phải và vách sau | PASS |
| 16 | Hai bản lề cửa | Kết cấu cửa | Mép trái cánh cửa | PASS |
| 17 | Tấm che dây phía sau | Kết cấu bảo vệ | Sau khoang chứa | PASS |

Nguồn đối chiếu: thuyết minh đã nộp, mapping JSON, 9 ảnh VIVA và F3D fresh-reopen mới nhất.
