ThaiQuangHuy2906/smart-privacy-locker/THUYETMINH/03_SMART_PRIVACY_LOCKER_VIVA_FINAL/02_BANG_TRINH_BAY_VIVA/2.1_Design_Board_VIVA.pdf

SMART PRIVACY LOCKER · Tổng quan bộ ảnh viva | Page 1 of 5 | Trang 1/5

SMART PRIVACY LOCKER · Tổng quan 17 hạng mục | Page 2 of 5 | Trang 2/5

SMART PRIVACY LOCKER · C1 - Khay điện tử và mạng dây | Page 3 of 5 | Trang 3/5

SMART PRIVACY LOCKER · C2 - Cảm biến cửa và cơ cấu khóa | Page 4 of 5 | Trang 4/5

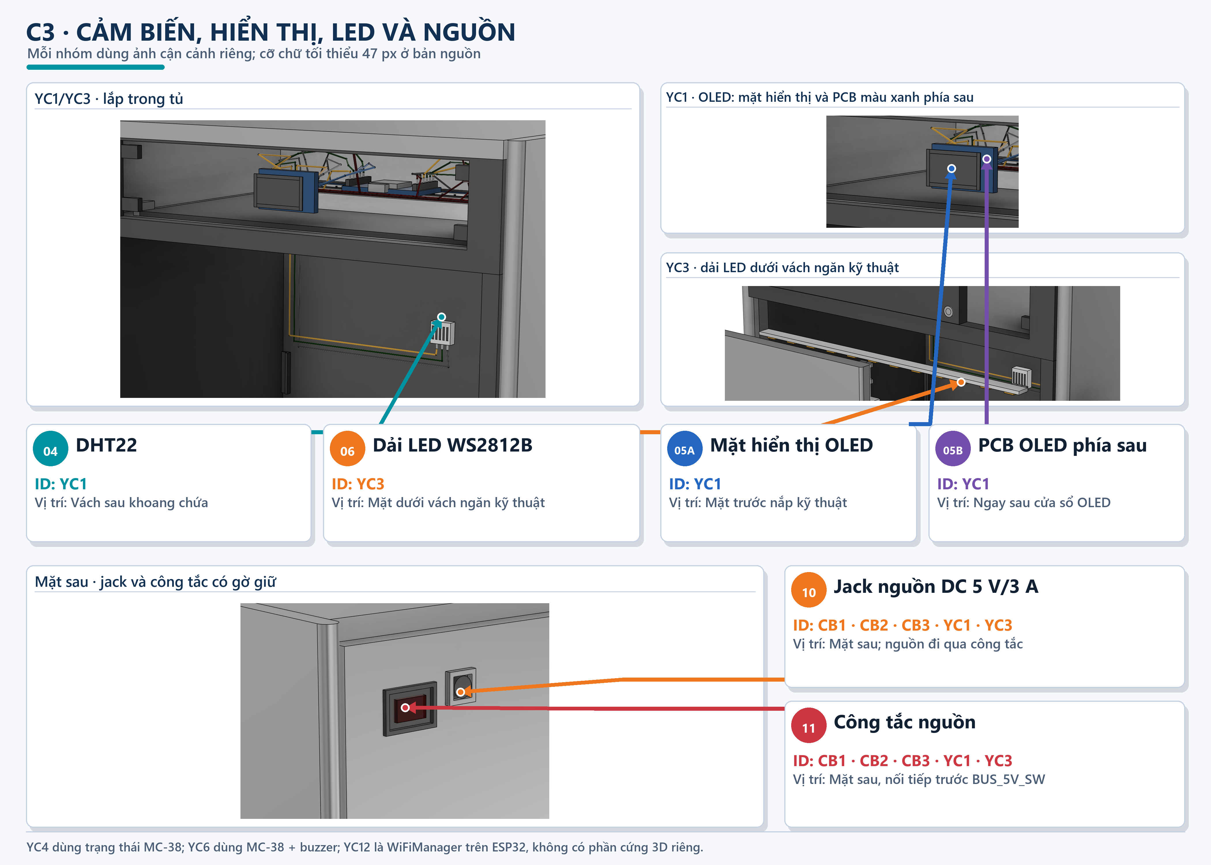
[picture p47: page 5]

SMART PRIVACY LOCKER · C3 - Cảm biến, hiển thị, LED và nguồn | Page 5 of 5 | Trang 5/5
