ThaiQuangHuy2906/smart-privacy-locker/AnhVatLi/2.3.2.jpg

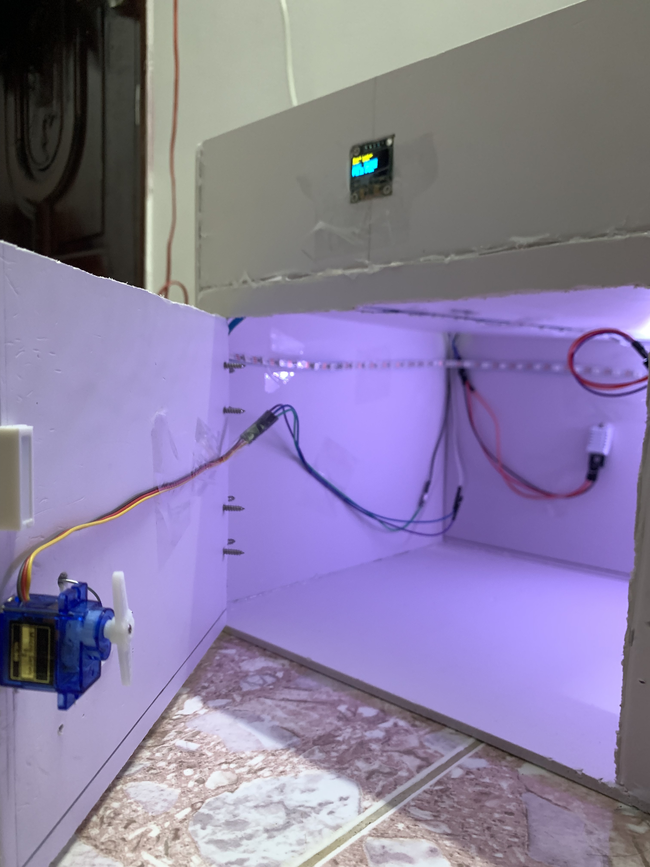
AnhVatLi/2.3.2.jpg
