ThaiQuangHuy2906/smart-privacy-locker/AnhVatLi/2.3.4_1.jpg

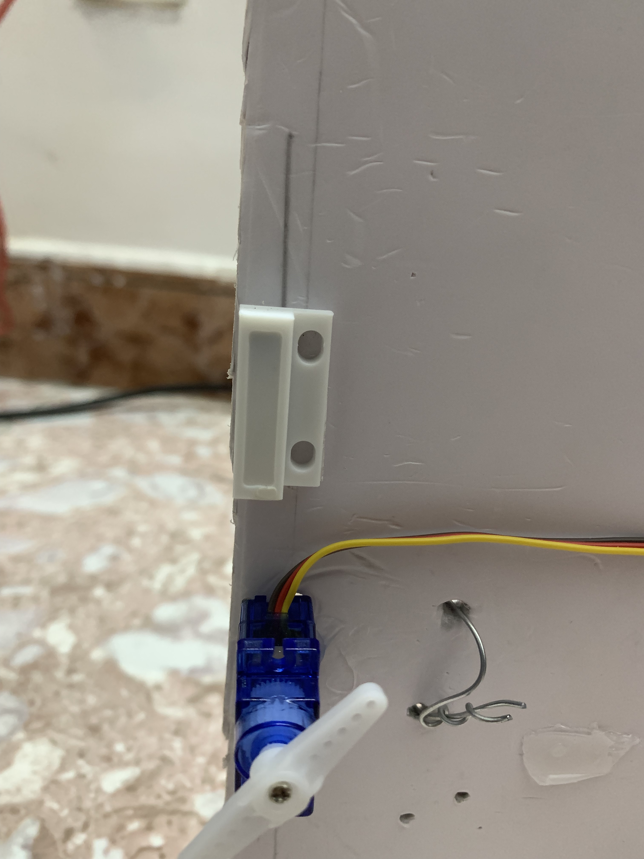
AnhVatLi/2.3.4_1.jpg
