ThaiQuangHuy2906/smart-privacy-locker/AnhVatLi/2.3.7_1.jpg

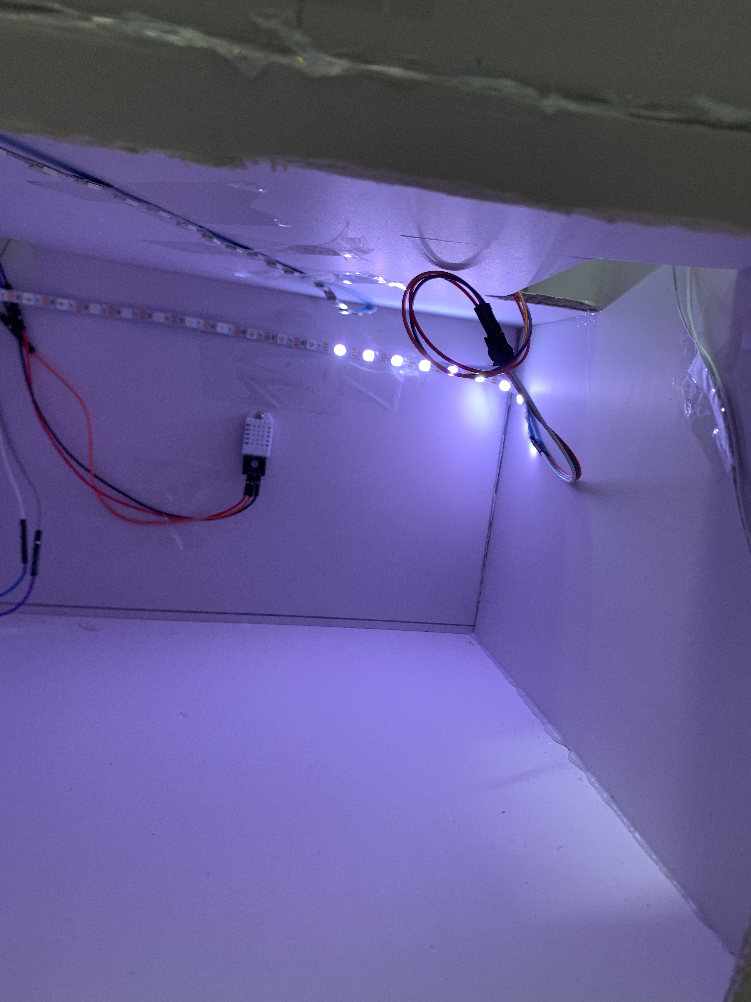
AnhVatLi/2.3.7_1.jpg
