ThaiQuangHuy2906/smart-privacy-locker/AnhVatLi/AnhWeb/Ảnh chụp màn hình 2026-08-18 170316.png

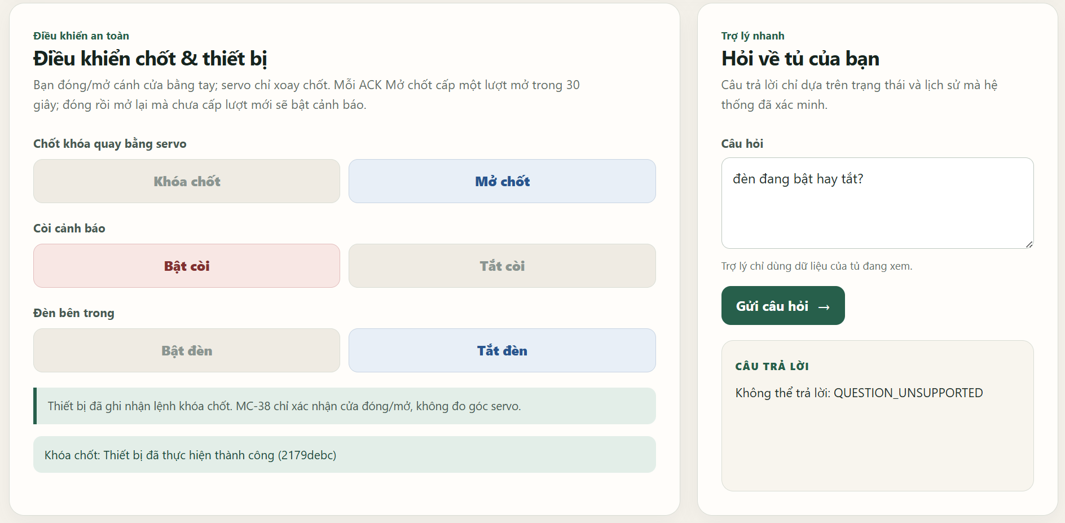
AnhVatLi/AnhWeb/Ảnh chụp màn hình 2026-08-18 170316.png
