ThaiQuangHuy2906/smart-privacy-locker/hardware/breadboard-830-tu-470uf-ws2812b-demo-final.png

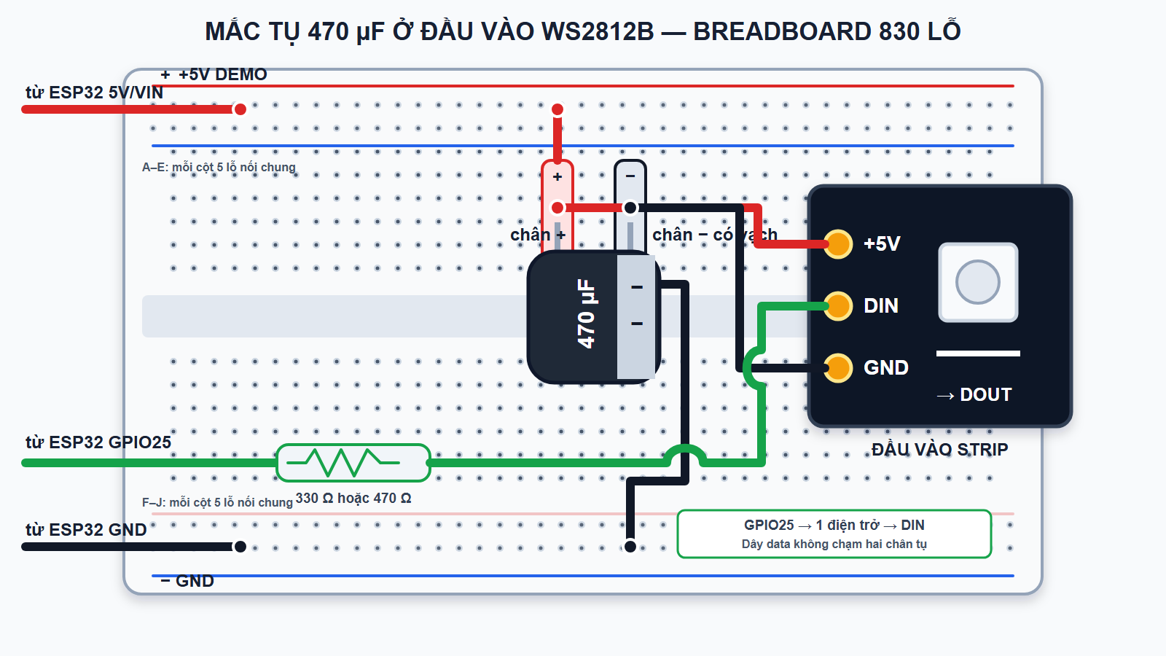
hardware/breadboard-830-tu-470uf-ws2812b-demo-final.png
