ThaiQuangHuy2906/smart-privacy-locker/THUYETMINH/03_SMART_PRIVACY_LOCKER_VIVA_FINAL/03_HINH_ANH_VIVA/2.1D_Technical_Compartment_VIVA.png

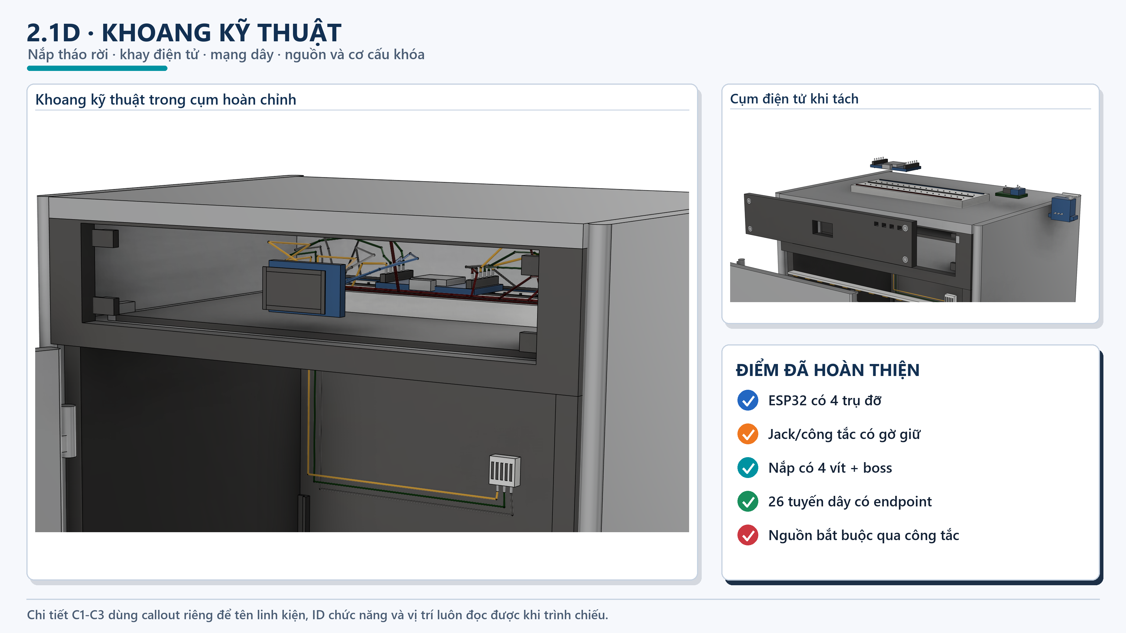
THUYETMINH/03_SMART_PRIVACY_LOCKER_VIVA_FINAL/03_HINH_ANH_VIVA/2.1D_Technical_Compartment_VIVA.png
