ThaiQuangHuy2906/smart-privacy-locker/hardware/bom.md

# Hardware BOM and purchase acceptance checklist

**Status: candidate procurement list — no item is accepted until its exact
marking and primary datasheet are recorded.** Quantities assume one locker and
the 10 WS2812 pixels configured in the local deployment. Update the quantity
and power worksheet if the physical model changes the strip count.

For the current supervised demo only, the user accepted unmeasured power gate
P1-05 on 2026-08-18. That waiver does not turn any candidate row below into an
accepted electrical part and does not apply to unattended/public operation.

Record the accepted exact parts and measurements against the gate IDs in
[../HUONG_DAN_TEST_END_TO_END.md](../HUONG_DAN_TEST_END_TO_END.md). A purchased
part or a user-observed smoke test is not automatically an accepted release
part.

| Item | Qty. | Minimum acceptance evidence before purchase/use | Reject when |
|---|---:|---|---|
| ESP32 DevKit | 1 | ESP32 board supported as Arduino IDE `ESP32 Dev Module` with core 2.0.17 and equivalent PlatformIO `esp32dev`; accessible GPIO4/18/21/22/25/26/27, 3.3 V and GND; exact board schematic or vendor pinout | board identity/pin labels are unknown, or the seller substitutes another MCU |
| Regulated SELV 5 V supply | 1 | rated at least 3 A; enclosed/certified low-voltage output; connector polarity documented; enough current after completing `power-budget.md` | bare mains wiring, unknown polarity, no current rating, or unstable output |
| DC jack 5.5 × 2.5 mm matching the adapter | 1 | plug fits firmly; center/sleeve terminals and polarity verified by continuity/voltage measurement; solder joints insulated and strain-relieved, or a correctly rated screw-terminal adapter is used | confused with 5.5 × 2.1 mm, pins guessed from appearance, loose plug, exposed conductors or undocumented polarity |
| Power switch, terminal/distribution and branch protection | 1 set | voltage/current rating exceeds the calculated load; connector and wire rating documented; fuse/polyfuse chosen for the real wire/load with supervisor approval | loose breadboard jumpers carry servo/LED supply current in the final build |
| SG90-class servo | 1 | exact operating-voltage and stall-current data; mechanical dimensions fit the door-arm mechanism; separate 5 V load branch; `80°`/`170°` do not force an end stop | stall current is unknown or the door forces the horn against an end stop |
| DHT22/AM2302 | 1 | exact part supports 3.3 V operation; bare sensor or module pull-up is known and can terminate at 3.3 V | module data is hard-pulled to 5 V with no level translation |
| SSD1306 I2C OLED | 1 | exact breakout accepts 3.3 V supply/I2C, or a separately specified level shifter is included; address can be scanned | SDA/SCL are pulled to 5 V while connected directly to ESP32 |
| WS2812-family RGB pixel | 10 | exact manufacturer/part, supply/data thresholds and pixel count recorded; if using Direct-D without a buffer, the exact specimen passes the dedicated direct/reconnect/full-load gate | listing says only “WS2812 compatible”, count/current is unknown, or direct operation is unstable |
| 74AHCT125 or 74HCT14 logic device | 0–1 | recommended robust path: genuine part rated for 5 V supply and a 3.3 V-high input; 74AHCT125 uses one non-inverting channel, while 74HCT14 must use two inverter gates in series; unused inputs/enables tied to defined levels | `SN74HC125N` is substituted as if it had TTL/AHCT input thresholds, or one 74HCT14 inverter is used alone and reverses the data polarity; omit the device instead when testing conditional Direct-D |
| WS2812 data resistor | 1 | 330–470 Ω, suitable through-hole/SMD rating, fitted near first DIN | omitted or placed only at ESP32 end of a long data wire |
| WS2812 bulk capacitor | 1 | 470–1000 µF, polarity marked, voltage rating above the measured 5 V rail | reversed, damaged, or insufficient voltage rating |
| MC-38 dry-contact reed sensor | 1 | isolated dry contact; contact state can be measured with a meter; cable/connector suitable for the enclosure | powered/alarm-loop module is substituted without a compatible interface |
| Active buzzer LOW-trigger module with `TMB12A05` | 1 | received specimen bench-tested with VCC at ESP32 `3V3`, common GND and `IN/S/I/O` through series 4.7 kΩ; inactive HIGH is silent; record active current/sound and exact module revision before final acceptance | direct VCC is returned to 5 V, GPIO26 supplies VCC/load current, LOW-at-3V3 is unreliable, or current/full-load behavior remains unbounded for final use |
| Decoupling/bulk parts for servo branch | 1 set | values and placement selected from the exact servo/supply behavior and recorded in `power-budget.md`; polarity/rating verified | capacitors are added by guess or used to hide an undersized supply |
| Wiring, connectors, insulation and strain relief | 1 set | current rating and length suit each branch; color/polarity labels; no exposed conductor | Dupont jumpers are used as an unsupported permanent high-current connection |
| Digital multimeter | 1 | can measure continuity, DC voltage and branch current in the expected range; leads/fuse intact | current range or lead connection is unknown |

## Before ordering

1. Put the exact manufacturer/part number and a primary datasheet link beside
   every active component in the team's purchase record.
2. Copy every maximum/peak current into `power-budget.md`; calculate the
   simultaneous load before accepting the supply, protection and wire size.
3. Confirm the ESP32 board's USB/external-power arrangement. Buy an appropriate
   data-only/isolated USB solution if simultaneous serial monitoring is needed.
4. Confirm the enclosure has space for the buffer, branch distribution,
   protection, capacitors, connectors and strain relief—not only the visible
   sensors/servo.
5. Do not substitute parts silently. A substitution reopens pin, voltage,
   current, polarity, logic-threshold and mechanical checks.

## As-built record fields

After receiving parts, record: manufacturer; exact part/board revision; seller
or source; datasheet link; quantity; measured supply polarity; measured idle
and peak current; logic/pull-up voltage; firmware build/commit; wiring revision;
tester; date; and P1/P2/P3 manual test IDs. Keep credentials, tokens, personal
email and Wi-Fi passwords out of photos and logs.
