ThaiQuangHuy2906/smart-privacy-locker/THUYETMINH/03_SMART_PRIVACY_LOCKER_VIVA_FINAL/06_MO_HINH_STEP_DU_PHONG/Smart_Privacy_Locker_v2.1_Backup.step

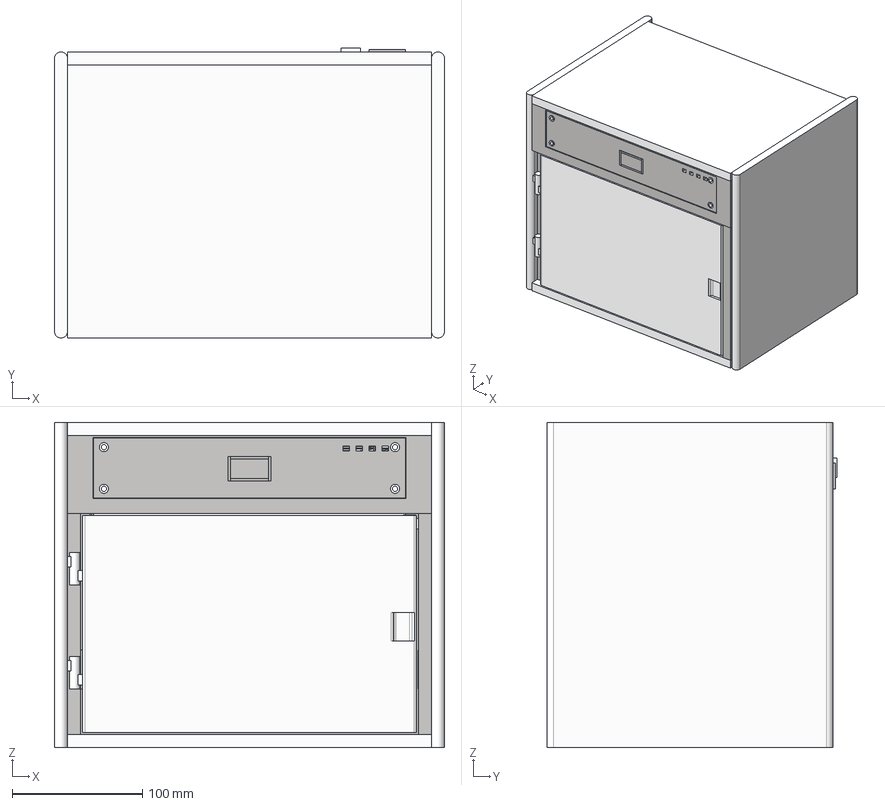
[picture p69: CAD file, 2026-08-14]
THUYETMINH/03_SMART_PRIVACY_LOCKER_VIVA_FINAL/06_MO_HINH_STEP_DU_PHONG/Smart_Privacy_Locker_v2.1_Backup.step
300.0 x 223.0 x 250.0 mm
