ThaiQuangHuy2906/smart-privacy-locker/(list of files, cad)

Other CAD files:
THUYETMINH/03_SMART_PRIVACY_LOCKER_VIVA_FINAL/01_MO_HINH_FUSION_CHINH/Smart_Privacy_Locker_v2.1_Final.f3d
