ThaiQuangHuy2906/smart-privacy-locker/tests/evidence/phase-1/README.md

# Phase 1 evidence index

| Evidence | Status | Location |
|---|---|---|
| P1-A01 clean ESP32 build | recorded | `automated-results.md` |
| P1-A02/P1-A03/P1-A04 native contract tests | recorded | `automated-results.md` |
| P1-M01–P1-M11 hardware/phone/broker tests | `[ ] DEFERRED — HARDWARE-FINAL-GATE` | capture under this directory with a redacted file name and Test ID after execution |
| Contract review by Nguyễn Văn Minh | pending | reviewer must add traceable review evidence; owner must not self-approve |
| Pin-map as-built review | pending | attach signed/redacted measurement and wiring evidence |

No image, serial transcript, broker capture, or video has been fabricated. P1-M01–P1-M11 are not evidence of a software pass and remain mandatory before final release/demo; their deferred status does not replace them with simulator evidence. Use `private/` (ignored) for raw captures that may require redaction, then commit only the verified sanitized evidence allowed by the project policy.
