ThaiQuangHuy2906/smart-privacy-locker/docs/troubleshooting.md

# Smart Privacy Locker troubleshooting

> Updated from the 2026-08-18 code/browser/hardware audit. For a reproducible
> diagnosis, record the release commit, wiring revision, timestamp/correlation
> ID and exact PASS/FAIL condition from
> [../HUONG_DAN_TEST_END_TO_END.md](../HUONG_DAN_TEST_END_TO_END.md).

| Symptom | Check | Safe action |
|---|---|---|
| Door is closed, latch state is `LOCKED`, then opening the door does not sound the buzzer | Confirm current firmware is installed; serial should observe a stable `CLOSED → OPEN`, local alarm should become `ACTIVE`, and the event should carry a UUIDv4 `event_id` even if MQTT is down | Do not bypass the alarm. Verify MC-38 polarity/debounce and GPIO26 active-low wiring separately. The current firmware must alarm locally before any Node-RED/Telegram result. |
| First OPEN after `UNLOCK` is valid, but closing does not rotate the latch back to `80°` | Confirm current firmware, a stable `OPEN → CLOSED` edge, raw MC-38 closed level and serial auto-lock messages. The retained state should become `LOCKED` only after the 2,000 ms servo cycle | Do not add a fixed delay or weaken the sensor interlock. Upload the synchronized firmware, align MC-38, then retest offline as well. Auto-lock is local and emits state, not a command ACK. |
| An unused `UNLOCK` remains open past 30 seconds | Keep the door stable/raw `CLOSED`; verify the grant started only after the successful UNLOCK cycle and observe the exact expiry boundary | Use the synchronized firmware. Expiry must revoke the grant and start local lock; boot must not create a grant or servo motion. |
| First OPEN after `UNLOCK` is valid, but a later forced/reopened door does not sound the buzzer | Inspect OPEN telemetry: the valid edge must be `authorized:true` and a later edge without a new grant must be `authorized:false`; confirm current firmware rather than an older lock-state-only detector | Keep the latch angles unchanged. Upload the synchronized current firmware/FlowFuse artifact and retest. Wait for auto-lock, then issue **Mở chốt** while CLOSED for another valid opening. |
| **Mở chốt** returns `DOOR_NOT_CLOSED_FOR_ACCESS` | MC-38 is not stably `CLOSED`. Every `UNLOCK` requires a closed door so that a successful ACK always creates a usable one-time opening grant, regardless of whether the current latch state is `LOCKED`, `UNLOCKED` or `UNKNOWN` | Close/align the door and magnet, wait for fresh `CLOSED`, then press once. If the latch already says `UNLOCKED`, the servo will not move again; only the access grant is renewed. |
| Dashboard refuses **Khóa ngay** with `DOOR_NOT_CLOSED` | Live state must be fresh and MC-38 must report stable `CLOSED`; an opening edge during the 2,000 ms servo travel also cancels the command | Close/align the door and magnet, wait for fresh `CLOSED`, then issue `LOCK` once. Do not force the latch or weaken the interlock. |
| A command returns `ALREADY_IN_STATE` | Compare requested action with fresh lock/alarm/LED state | This is an intentional no-op: no MQTT actuator command is published and the servo does not move. Refresh only if the physical observation disagrees with the open-loop logical state. |
| Dashboard persistence health is degraded or shows pending/dead-letter items | Inspect bounded persistence diagnostics and Supabase availability/credentials; pending RAM items retry on the periodic runtime tick | Restore the data service and observe retry. A dead-letter needs explicit investigation; do not call the event persisted until the row exists. Remember that a Node-RED restart can lose pending RAM items. |
| Dashboard looks correct but sends too many state requests | Current cadence is 5 seconds while visible and 15 seconds while hidden; only one poll may be in flight, with one coalesced follow-up | Align the deployed artifact/cache with current source. Do not add overlapping intervals or reduce the delay to mask a stale-state root cause. |
| Dashboard stays “chưa được cấu hình” after backend startup | `/api/v1/public-config` should retry every five seconds while both auth actions remain disabled | Fix the backend/config response and wait for automatic recovery. If there is still only one request, rebuild/redeploy `flows.flowfuse.json` and hard reload the old cached page; never hard-code keys. |
| Command succeeds but UI shows raw `COMMAND_SUCCEEDED` | Current source maps it to “Thiết bị đã thực hiện thành công” | Treat this as a source/generated-artifact/browser-cache version mismatch; rebuild, redeploy and reload before taking final evidence. ACK remains the technical source. |
| Pending spinner is missing, off-center or appears on both opposing buttons | The requested button alone must have a centered 17 px green spinner and `aria-busy=true`; its same-domain counterpart is disabled but not marked busy | Do not repeatedly click. Verify current CSS/JS artifact and cache; preserve the no-actuator-retry rule while waiting/reconciling. |
| Telegram provider/delivery says `failed` but UI says “đang xử lý” | Current UI maps `failed` to “gửi thất bại” and has controlled labels for every known delivery status | Record the provider result accurately, then fix the deployed artifact/cache mismatch; do not rewrite backend status. |
| No live data but alarm/LED show “Đang tắt” | Current no-data path sets lock/alarm/LED to `UNKNOWN` | Do not infer safety from the cards. Align the deployment with current source and confirm no-data regression before release. |
| Device is stale/offline but lock/alarm/LED still look current | Current stale path sets these cards to unknown and disables all actuator controls | Treat retained values as last-known only. Check deployed source version plus availability/state generation; never bypass freshness. |
| Device appears after `EN` then disappears from Dashboard after about 30 seconds | Confirm current firmware emits non-retained `locker/<ID>/heartbeat` plus retained state every 10 seconds; inspect serial reset reason, broker ACL/subscription, Node-RED artifact, and 5 V/3.3 V rails | Upload/deploy the same current version. If heartbeat stops while serial stays healthy, fix MQTT/ACL/flow. If serial reboots or reports brownout, disconnect loads and repeat the power gate. Do not keep pressing `EN`. A `Locker-Setup` AP ending at 180 seconds is only the provisioning timeout. |
| SG90 ACK success but door did not reach position | Horn/linkage, 5 V rail, jam/end stop and MC-38 outcome | Power off if binding; ACK is timed open-loop completion, not feedback. Correct mechanics/power and rerun with MC-38/video. |
| Adapter has no I/O switch or jack does not split power | Jack polarity/terminals and power-distribution topology | A built-in switch is not required. Use a rated DC switch in the positive lead and a proper terminal/distribution block; meter-check before energizing. |
| A future-dated command is accepted | Verify NTP is synced, current firmware is installed, and skew exceeds the 30-second default | A synced device must reject it as `INVALID_ISSUED_AT`. An unsynchronized device cannot enforce wall-clock age; restore time sync and rerun rather than claiming the boundary passed. |
| Unknown/late/mismatched ACK appears schema-valid | Ingestion should return `accepted:false` with `UNKNOWN_ACK`, `DUPLICATE_OR_LATE_ACK`, or `ACK_CORRELATION_MISMATCH` in bounded diagnostics | Never complete another pending request. If generic ingestion says accepted, align the deployed FlowFuse artifact with current runtime source and rerun the correlation test. |
| Alarm command stays pending | MQTT/ESP32 state, matching ACK, timeout diagnostic | Do not auto-repeat; request/reconcile full state |
| Alarm ACK says success but no sound | Module supply, polarity, driver and GPIO26 wiring | Power off; return to P3-M01 hardware verification |
| `DATA_NOT_CONFIGURED` | Backend `SUPABASE_SERVICE_ROLE_KEY` and URL | Restore the secret in the deployment store; never expose it to the browser |
| `DATA_TIMEOUT` | Supabase did not complete headers and response body inside the bounded adapter deadline | Check service health/network, then retry the read once; do not reinterpret timeout as empty data |
| `DATA_INVALID_RESPONSE` | Supabase returned a non-JSON or malformed response | Inspect the sanitized backend/provider response and proxy configuration; do not expose service-role headers |
| `INVALID_SESSION` after a previously valid request | The access token expired between verification and the ownership query | Sign in again; the backend returns 401 and does not continue to ownership-dependent work |
| History/chart unavailable | Migration order, service-role access, owner/locker mapping | Run the adapter/SQL tests and inspect sanitized backend diagnostics |
| `EVENT_DATASET_TOO_LARGE` | The requested range crossed the backend pagination safety ceiling | Narrow the range or archive/index data after measuring; never treat a partial count as complete |
| `SETTINGS_DATASET_TOO_LARGE` | The daily scheduler crossed the notification-settings pagination safety ceiling | Archive stale locker settings or raise the measured backend ceiling deliberately; never send from a partial settings list |
| Email not sent | Email enabled/address/time/timezone and SMTP variables | Test one controlled report; inspect delivery status without logging password |
| `EMAIL_NOT_CONFIGURED` | SMTP variables are missing or incomplete | Configure the backend SMTP secret store, then wait for the next due run; no delivery attempt is consumed while unconfigured |
| `TELEGRAM_BOT_NOT_CONFIGURED` | Bot token/username is missing or invalid in FlowFuse | Set `TELEGRAM_BOT_TOKEN` and the BotFather username without `@`, then Full Deploy; never put the token in Dashboard/Git |
| `TELEGRAM_WEBHOOK_NOT_CONFIGURED` | `TELEGRAM_WEBHOOK_SECRET` is missing/invalid | Generate a dedicated `[A-Za-z0-9_-]` secret of at least 16 characters, set it in FlowFuse, Full Deploy, then register the same value using Bot API `setWebhook` |
| Link opens Telegram but Dashboard stays unlinked | User did not press **Start**, webhook URL/secret is wrong, or the 10-minute link expired | Check `getWebhookInfo`, create a new link, and press **Start** in the private chat; never ask the user to find a Chat ID |
| `TELEGRAM_NOT_LINKED` | Telegram was enabled/tested before private-account linking completed | Press **Liên kết Telegram** and finish the bot Start flow; there is intentionally no global-recipient fallback |
| `TELEGRAM_LINK_SERVICE_UNAVAILABLE` | Supabase RPC/migration/schema cache is unavailable or returned an unknown rejection | Keep the link page open, verify the latest migration and service-role configuration, then retry; the webhook deliberately returns non-2xx so Telegram can redeliver instead of silently losing the link |
| Telegram link works in a private chat but not a group | Group/supergroup destinations are intentionally refused | Link from the user's private bot chat; alerts contain owner-scoped locker data and must not be routed to an unverified group |
| Bot opens without a link token | The user opened the bot profile directly or an old deep link lost its parameter | Use `/start`, `/help`, or `/settings` for a safe Dashboard instruction, then create a fresh 10-minute link from the owned locker |
| History loads but chart fails (or the reverse) | Inspect the message under the two panels and the failed API response | Keep the valid panel; retry once after correcting only the failing route |
| Duplicate report suppressed | Existing locker/channel/local `report_date` row | Expected behavior; do not delete production delivery history just to resend |
| Delivery is `delivery_unknown` | SMTP may have accepted a message before the result could be recorded | Review the mailbox/provider and delivery row manually; never trigger an automatic resend |
| Dashboard controls disabled | Session, ownership, MQTT ONLINE and fresh full state | Re-authenticate or wait for the current connection generation to synchronize |
| Wi-Fi status is `Chưa xác định` | MQTT/ESP32 availability and whether a fresh full-state message has arrived | Wait for current-generation ONLINE + state; do not infer Wi-Fi health from an old retained message |
| `Locker-Setup` does not appear | The saved Wi-Fi may still work, or the three-minute portal window may have elapsed | Move near the powered locker and restart it; use the USB-local reset procedure only during supervised maintenance; never enter Wi-Fi credentials into the Dashboard |
| Clean `esp32dev` build loses files under a Vietnamese Windows path | Xtensa compiler output shows a mangled repository path while native tests still pass | Use the temporary `subst` ASCII drive workflow in `firmware/README.md`, then remove the mapping; do not copy or commit `.pio` |

For physical work, disconnect the low-voltage supply before touching wiring.
Do not bypass the driver/power checks and do not connect this project to mains.
