ThaiQuangHuy2906/smart-privacy-locker/arduino/SmartPrivacyLocker/ack_publisher.cpp

#include "ack_publisher.h"

#include <ArduinoJson.h>

#include <string.h>

// Cache này giúp command có tính idempotent: cùng command_id sẽ không chạy
// actuator lần hai mà chỉ phát lại kết quả đã ghi nhớ.
// Khởi tạo cache và chặn sức chứa trong khoảng an toàn từ 1 đến 16 phần tử.
RecentCommandCache::RecentCommandCache(size_t capacity)
    : capacity_(capacity == 0 ? 1 : (capacity > kMaximumEntries ? kMaximumEntries : capacity)) {}

// Tìm ACK đã lưu theo command_id để phát lại mà không chạy command lần hai.
const AckRecord* RecentCommandCache::find(const char* commandId) const {
  if (commandId == nullptr) {
    return nullptr;
  }
  for (size_t index = 0; index < count_; ++index) {
    if (strcmp(entries_[index].commandId, commandId) == 0) {
      return &entries_[index];
    }
  }
  return nullptr;
}

// Ghi ACK mới vào vị trí kế tiếp của bộ nhớ vòng.
void RecentCommandCache::remember(const AckRecord& record) {
  // Ghi đè phần tử cũ nhất khi vòng đệm đã đầy.
  entries_[nextIndex_] = record;
  nextIndex_ = (nextIndex_ + 1) % capacity_;
  if (count_ < capacity_) {
    ++count_;
  }
}

// Chuyển AckRecord thành JSON hoàn chỉnh để publish lên MQTT.
bool serializeAck(const AckRecord& record, bool duplicate, const char* timestamp,
                  char* destination, size_t destinationCapacity) {
  if (destination == nullptr || destinationCapacity == 0) {
    return false;
  }

  JsonDocument document;
  document["schema_version"] = 1;
  document["command_id"] = record.commandId;
  document["locker_id"] = record.lockerId;
  document["action"] = toString(record.action);
  document["result"] = record.result == AckResult::SUCCESS ? "success" : "error";

  // Gắn snapshot trạng thái tại thời điểm hoàn tất command để backend đối soát.
  JsonObject deviceState = document["device_state"].to<JsonObject>();
  deviceState["door"] = toString(record.state.door);
  deviceState["lock"] = toString(record.state.lock);
  deviceState["alarm"] = toString(record.state.alarm);
  deviceState["led"] = toString(record.state.led);

  if (record.result == AckResult::SUCCESS) {
    document["error"] = nullptr;
  } else {
    // ACK lỗi luôn có mã máy đọc được và thông báo dành cho người dùng/log.
    JsonObject error = document["error"].to<JsonObject>();
    error["code"] = toString(record.error);
    error["message"] = record.errorMessage;
  }
  document["duplicate"] = duplicate;
  if (timestamp == nullptr) {
    document["timestamp"] = nullptr;
  } else {
    document["timestamp"] = timestamp;
  }
  // serializeJson trả số byte đáng lẽ ghi; bằng/vượt capacity là bị cắt mất dữ liệu.
  return serializeJson(document, destination, destinationCapacity) < destinationCapacity;
}
