ThaiQuangHuy2906/smart-privacy-locker/(commit log)

2026-08-07 feat(phase-1): add ESP32 firmware foundation
2026-08-07 fix(phase-1): harden MQTT subscription recovery
    [app_config.example.h, display_controller.cpp, mqtt_client.cpp, mqtt_client.h]
2026-08-07 fix(phase-1): correct MQTT subscription semantics
    [mqtt_client.cpp]
2026-08-08 fix(phase-2): harden orchestration and evidence gates
    [app_config.example.h]
2026-08-09 fix(flowfuse): canonicalize generated export line endings
2026-08-09 docs(plan): record cross-platform FlowFuse verification
2026-08-14 feat: finalize hardware docs, simulation, and viva assets
    [Smart_Privacy_Locker_v2.1_Backup.step, Smart_Privacy_Locker_v2.1_Final.f3d]
2026-08-16 docs: add breadboard wiring guide
2026-08-17 fix: stabilize device sync and finalize demo documentation
    [app_config.example.h, command_handler.cpp, command_handler.h, main.cpp, mqtt_client.cpp, mqtt_client.h, sketch.ino]
2026-08-17 fix: correct servo actuation and document 5V wiring
    [app_config.example.h, main.cpp]
2026-08-18 docs: align final report checklist with current build
2026-08-18 docs: add final report and viva materials
2026-08-19 docs: add Vietnamese Arduino firmware comments
2026-08-19 docs: document every Arduino firmware function
